SafeGuard-EWHA/2026ESWContest_mobility_DugoNaerijiMarajo/README.md

# SafeGuard: UWB와 mmWave를 융합한 Cascading Wake-up 기반 차량 내 잔류 탑승자 선제 보호 시스템

**제24회 임베디드SW경진대회 자동차/모빌리티 부문 결선 제출 저장소** · 팀 두고내리지말아조 (윤현서, 최서현, 윤홍은, 이화여자대학교)

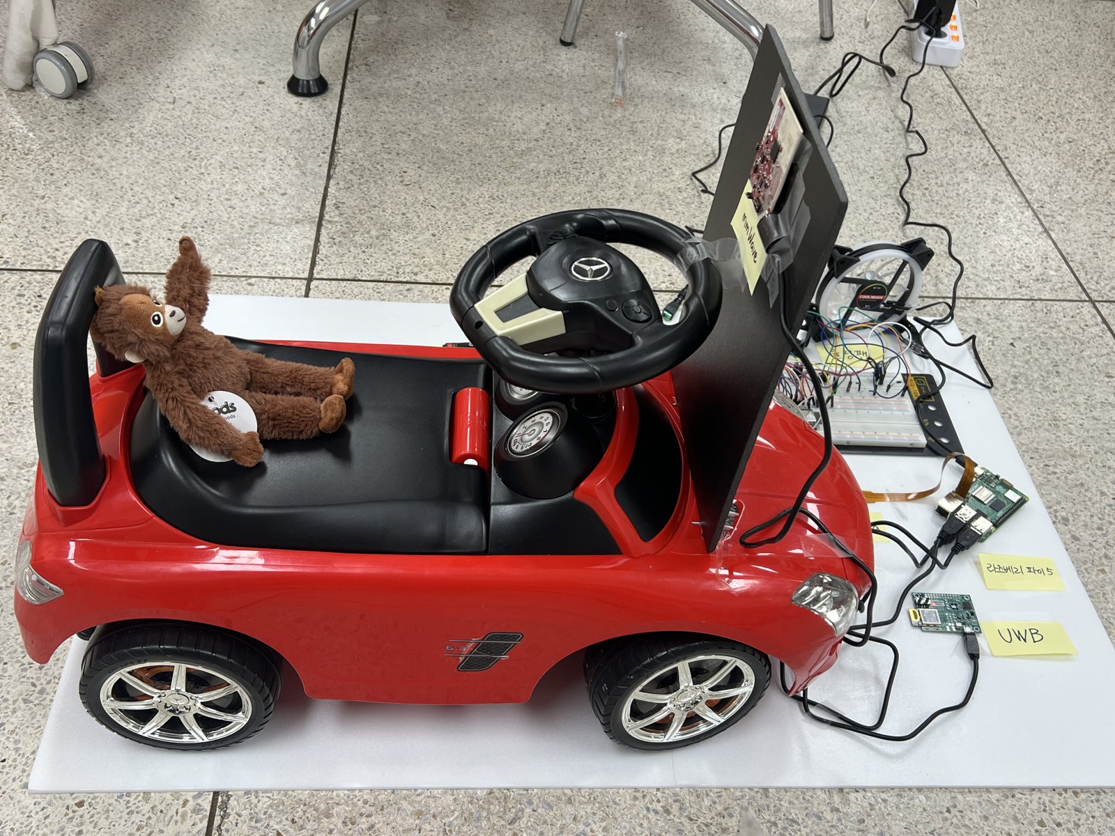
[picture p1: docs/presentation/img/benz/car_side_teddy.jpg]
SafeGuard 시연 시제품


| 제출 자료 | 위치 |
|---|---|
| 개발완료보고서 (PDF, 본문 20쪽) | [`2026ESWContest_모빌리티_두고내리지말아조_개발완료보고서.pdf`](docs/presentation/2026ESWContest_모빌리티_두고내리지말아조_개발완료보고서.pdf) |
| 작품소개서 (Word, 2쪽) | [`2026ESWContest_모빌리티_두고내리지말아조_작품소개서.docx`](docs/presentation/2026ESWContest_모빌리티_두고내리지말아조_작품소개서.docx) |
| 시연 동영상 (YouTube) | [https://www.youtube.com/watch?v=aBB1S666mp4&feature=youtu.be](https://www.youtube.com/watch?v=aBB1S666mp4&feature=youtu.be) |
| 레이더 영상 5종, 주요 그래프, 실측 그래프 | 아래 본문 (페이지를 열면 바로 재생) |

| 폴더 | 내용 |
|---|---|
| [`prototype/`](prototype/) | **장치 제어 소스**: C++ 상태기계와 열 관측기(`SafeGuard_Main/src`), Python 센서 허브와 대시보드(`scripts`), ESP32 펌웨어, 측정 원본 |
| [`hardware/`](hardware/) | 블록 B 레이더 수신기(`mmwave/mmwave_reader.py`), 카메라 움직임 검출, ESP32 시험 스케치, 배선 가이드 |
| [`src/`](src/), [`app/`](app/), [`tests/`](tests/) | TwinLab 시뮬레이터 (상태기계, 가상 센서, 전력 모델, Streamlit 대시보드, pytest) |
| [`docs/figures/paper/`](docs/figures/paper/) | 주요 그래프와 생성 스크립트 (실측 원본에서 재현) |
| [`docs/figures/power/`](docs/figures/power/) | 결선 장비 소비전력 추정 그래프와 계산 스크립트 |
| [`docs/presentation/`](docs/presentation/) | 보고서, 소개서, 영상, 그림 생성 스크립트 |
| `B회신*_20261027/` | 레이더, 카메라 시험 원본 (CSV, 원본 바이트, 사진, 분석) |
| [`pic_red_benz/`](pic_red_benz/), [`pics/`](pics/) | 시연 시제품과 부품 사진 |

---






## 요약

보호자가 차를 떠난 뒤 차 안에 남은 아이를 찾아, 실내 온도가 위험해지기 **전에** 팬과 부저를 켜는 장치다.
보호자의 UWB 거리(5 m 초과 10초)로 이탈을 확인한 뒤에만 PIR, 카메라 → 60 GHz 레이더 → 온도 예측 순서로
필요한 센서를 깨운다(Cascading Wake-up).

| 서론 | 본론 | 결론 |
|---|---|---|
| 차량 내 아동 방치 사고는 온도가 오른 뒤 알리면 늦다. 단일 센서와 상시 구동 방식의 한계를 넘는 저전력 선제 보호가 목표 | 유아용 전동차 시제품, 시스템 구조와 상태기계, 레이더, 카메라, UWB 실측, 소비전력 추정 | [결론과 시사점](#3-결론과-시사점): 무엇을 확인했고 실제 차량에 무엇을 줄 수 있는지 |

시연 영상 (2026.10.28 실차 시연): https://www.youtube.com/watch?v=aBB1S666mp4&feature=youtu.be

라이브 데모 (TwinLab 시뮬레이터, 예선 제출본): https://safeguard-mmwave-simulator.streamlit.app/

## 상황별 실제 대시보드

**[상황별 캡처 7장과 간단한 설명 보기](docs/dashboard-scenarios/README.md)**

정지 확인 → 근거리 감시 → 보호자 이탈·탑승 의심 → 열 예측 → 보호·종료 순서로 정리했습니다. 연결 장애 화면도 별도로 모았습니다.
서로 다른 개발·시연 시점의 실제 캡처이며, 선제 보호 작동 장면은 갤러리의 시연영상 링크로 연결합니다.

| 근거리 감시 대기 | 이탈 후 온도 판단 | 열 예측 결과 예시 |
|---|---|---|
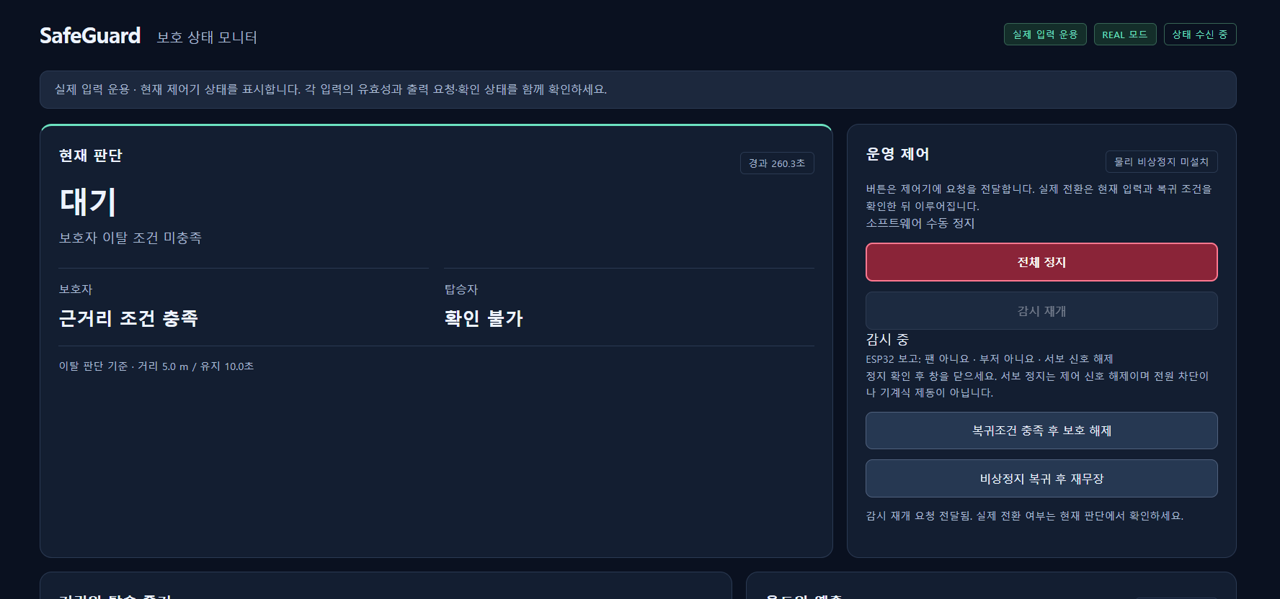
[picture p2: docs/dashboard-scenarios/images/02-standby.png]
근거리 감시 대기
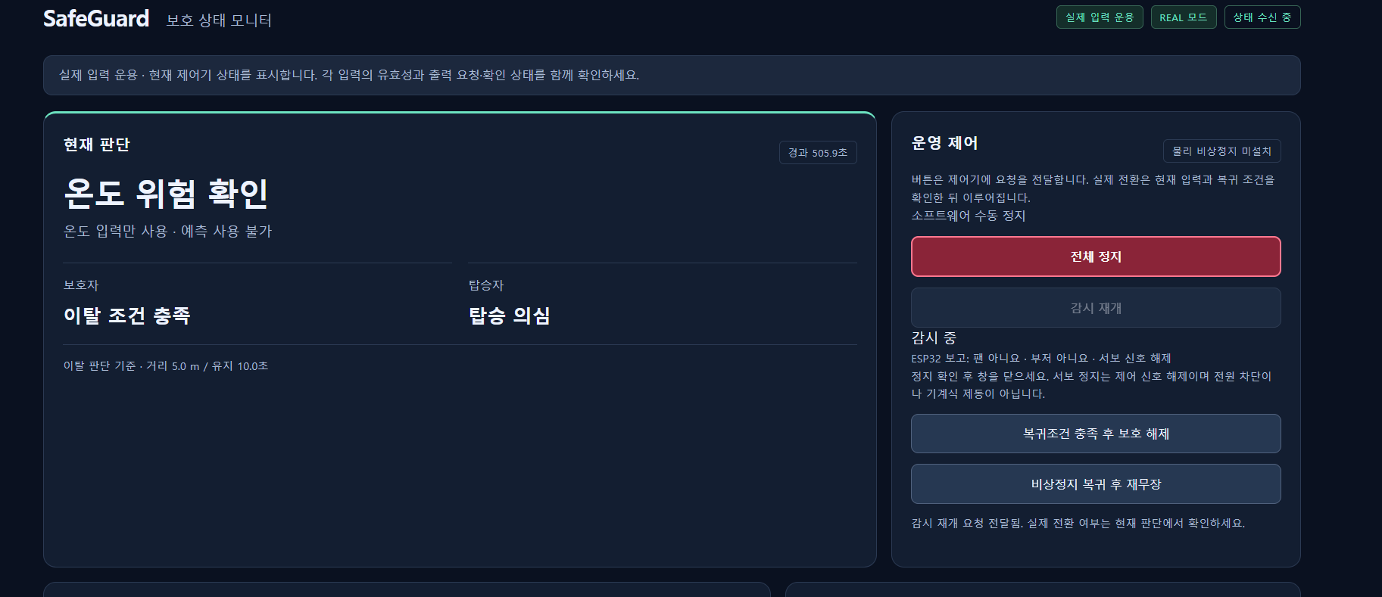
[picture p3: docs/dashboard-scenarios/images/03-away-thermal.png]
이탈 후 온도 판단
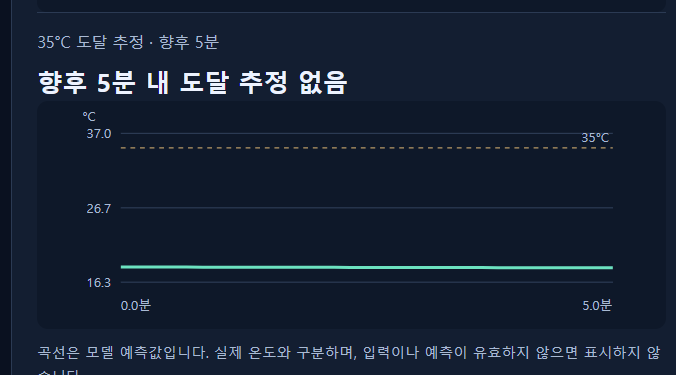
[picture p4: docs/dashboard-scenarios/images/04-no-crossing-forecast.png]
도달 추정 없음
|  |  |  |

# 1. 서론: 배경과 목표

- **배경**: 직사광선 아래 차량 실내 온도는 외기보다 크게 오르고, 아이는 체온 조절이 약해 짧은 시간에도 위험하다.
  Euro NCAP은 2026년부터 어린이 잔류 감지(CPD)를 평가 항목으로 다루고, 국내도 통학차량 하차 확인 장치를 의무화했다.
- **기존 방식의 한계**: PIR은 가만히 있는 아이를, 카메라는 어둠과 가림을 놓친다. 모든 센서를 상시 켜 두면 주차 중 배터리 부담이 크다.
  "현재 온도가 기준을 넘으면 알림"은 이미 위험 구간에 들어선 뒤다.
- **목표**: (1) 놓치지 않는다: 평소에는 PIR 또는 카메라 하나만 반응해도 레이더로 확인한다. (2) 필요할 때만 켠다.
  (3) 뜨거워지기 전에 움직인다: 35 °C 도달까지 남은 시간으로 판단한다.

# 2. 본론

## 2.1 시연 시제품: 유아용 전동차 위 SafeGuard (2026.10.28)

빨간 유아용 전동차를 차량 실내 모형으로 쓰고, 뒷좌석 자리에 인형(잔류 탑승자 역할)을 앉혔다.
60 GHz 레이더(mmWave)는 운전대 앞 판에 붙여 좌석을 향하게 했고, 나머지 부품은 이름표를 붙여 옆에 배치했다.

전동차 옆모습과 인형, 운전대 앞 레이더

| 위에서 본 전체 배치 | 정면: 운전대 앞 레이더 |
|---|---|
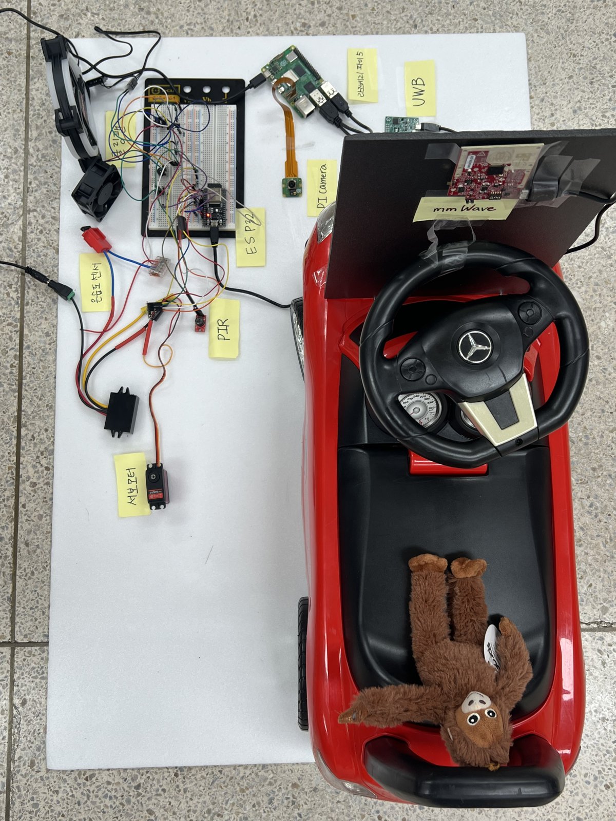
[picture p5: docs/presentation/img/benz/car_top_full.jpg]
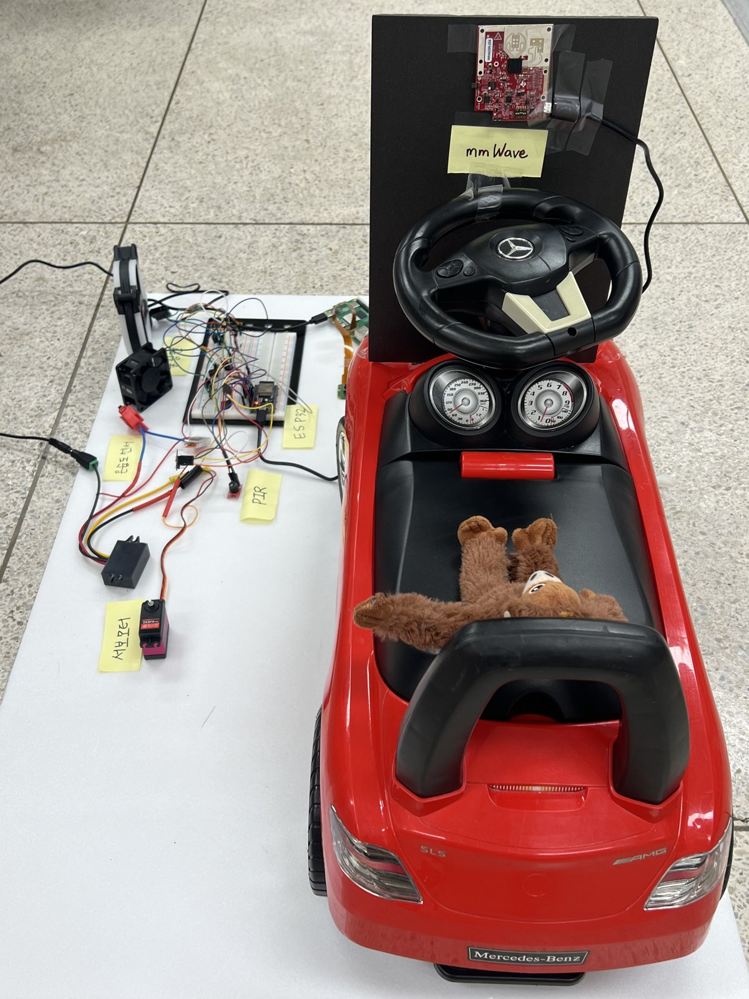
[picture p6: docs/presentation/img/benz/car_front_radar.jpg]
|  |  |

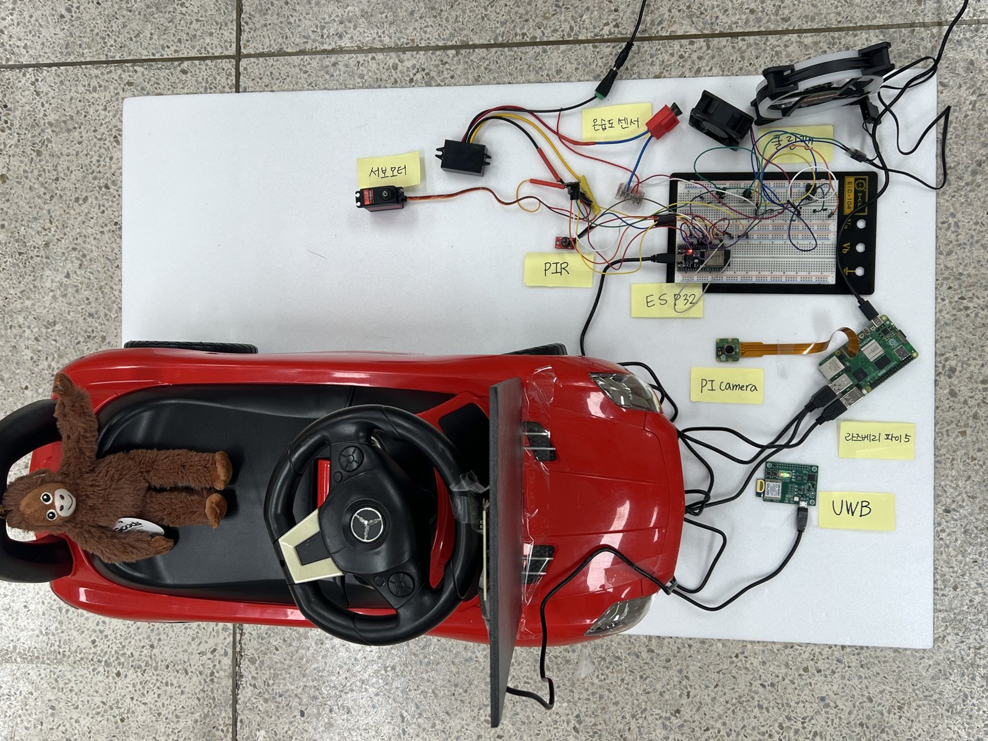
[picture p7: docs/presentation/img/benz/car_side_top.jpg]
옆에서 본 전체 배치와 이름표


| 레이더 (IWR6843ISK-ODS) | 운전대 앞 판에 장착 |
|---|---|
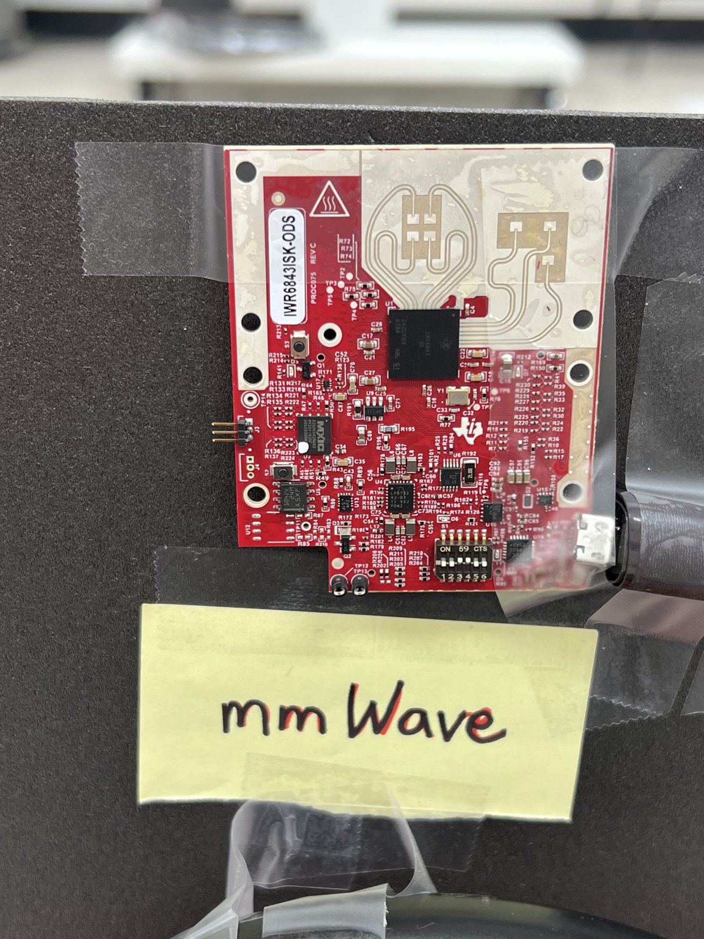
[picture p8: docs/presentation/img/benz/radar_close.jpg]
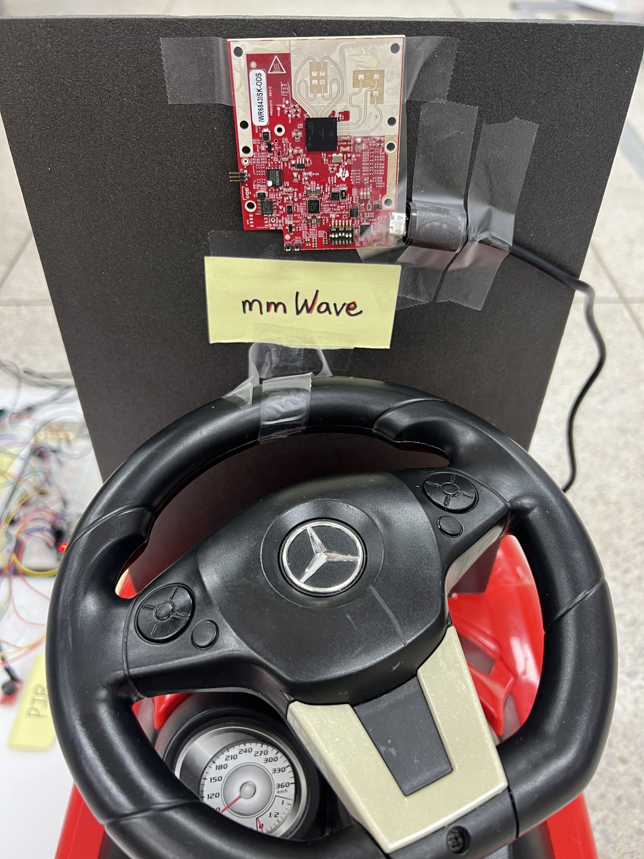
[picture p9: docs/presentation/img/benz/radar_on_dashboard.jpg]
|  |  |

| UWB, Pi Camera, Raspberry Pi 5 | ESP32, PIR, 온습도센서, 팬, 부저 | 서보, PIR, 12V 배선 |
|---|---|---|
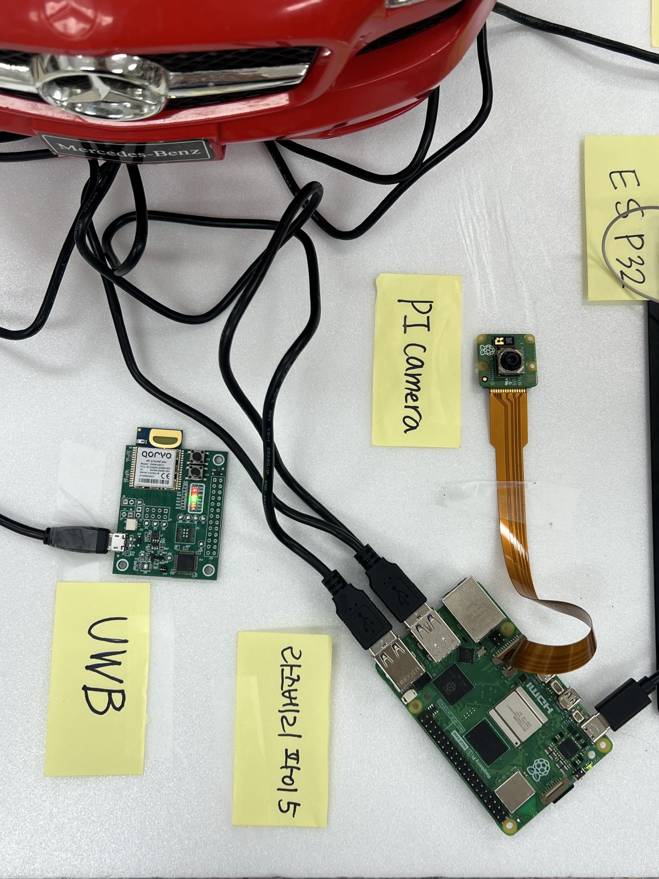
[picture p10: docs/presentation/img/benz/uwb_pi_camera.jpg]
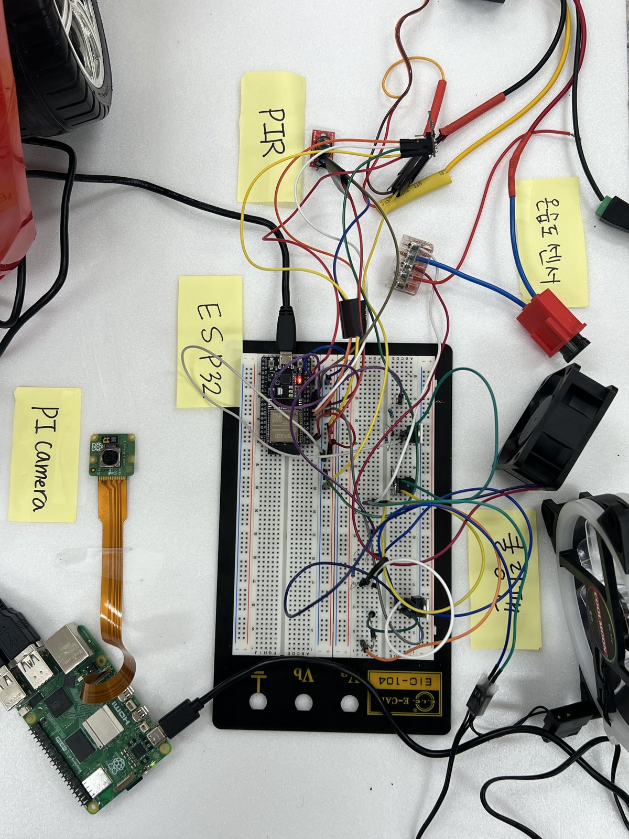
[picture p11: docs/presentation/img/benz/esp32_pir_sht31.jpg]
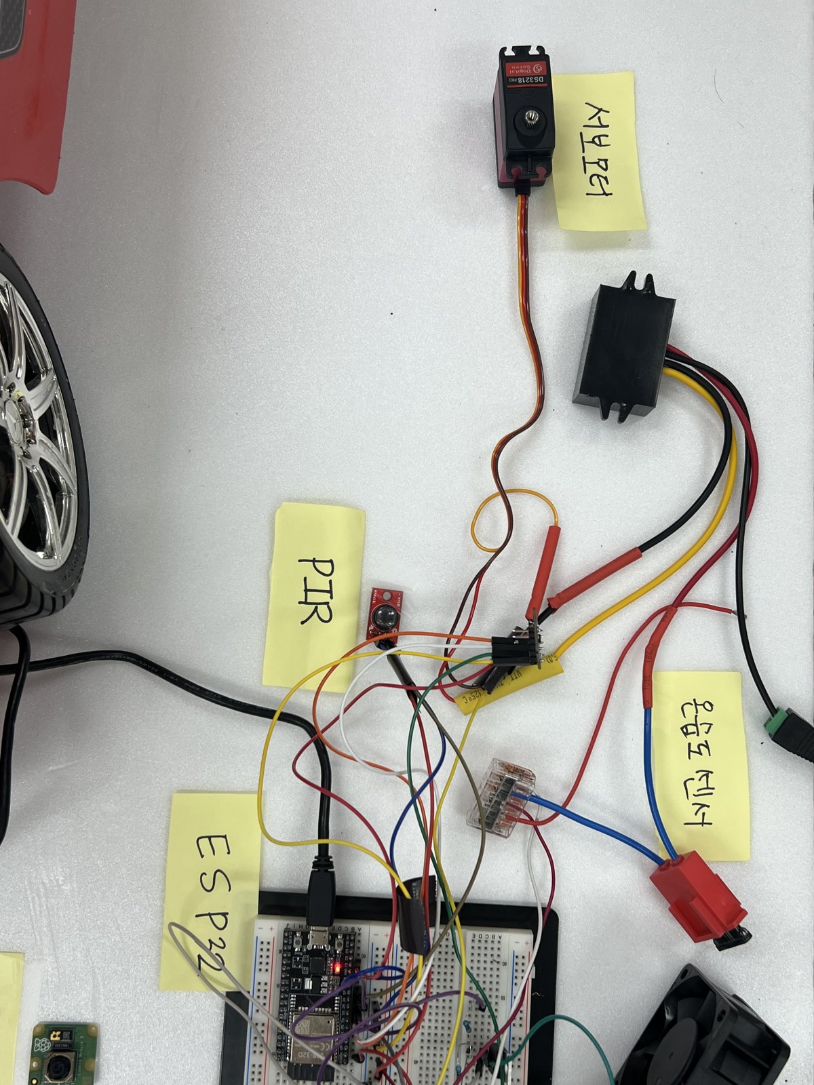
[picture p12: docs/presentation/img/benz/servo_pir.jpg]
|  |  |  |

사진 23장 (긴 변 2000 px로 줄이고 위치 정보 제거): [`pic_red_benz/`](pic_red_benz/)

### 실제 차량 설치와 시연 (2026.10.28)

전동차에서 만든 센서와 제어부를 실제 승용차 운전석 옆 센터 콘솔에 옮겨 달았다. Pi 5, 카메라, UWB 차량측, 레이더, ESP32 출력부를
판 하나에 고정하고 12V 팬, 부저를 연결했다.

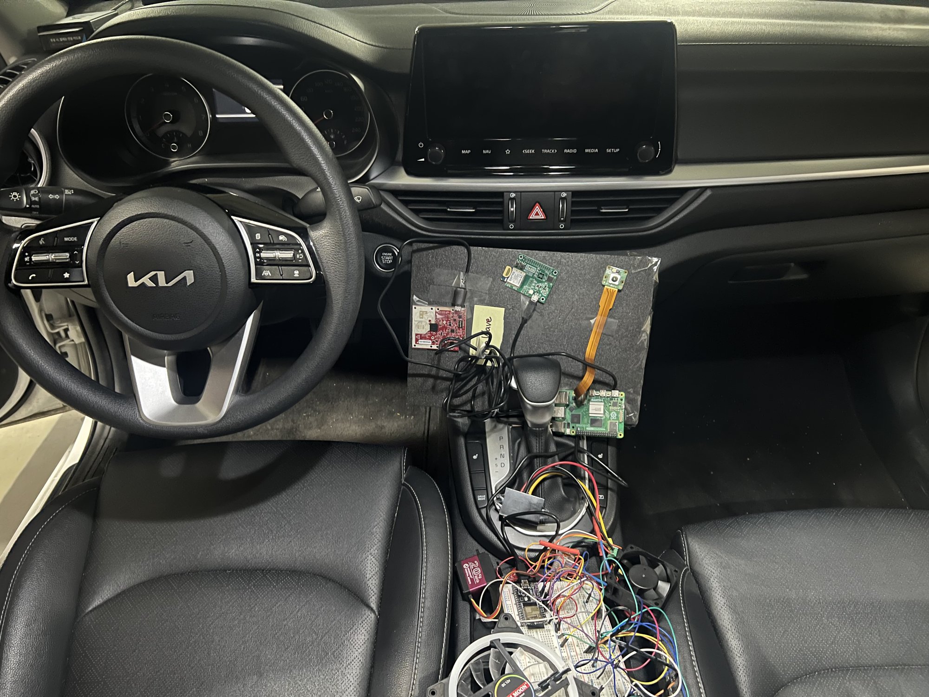
[picture p13: docs/presentation/img/realcar/realcar_install_front.jpg]
실제 차량 센터 콘솔에 설치한 SafeGuard


| 센터 콘솔 장착 | 장치 근접 (Pi 5, 카메라, UWB, 배선) |
|---|---|
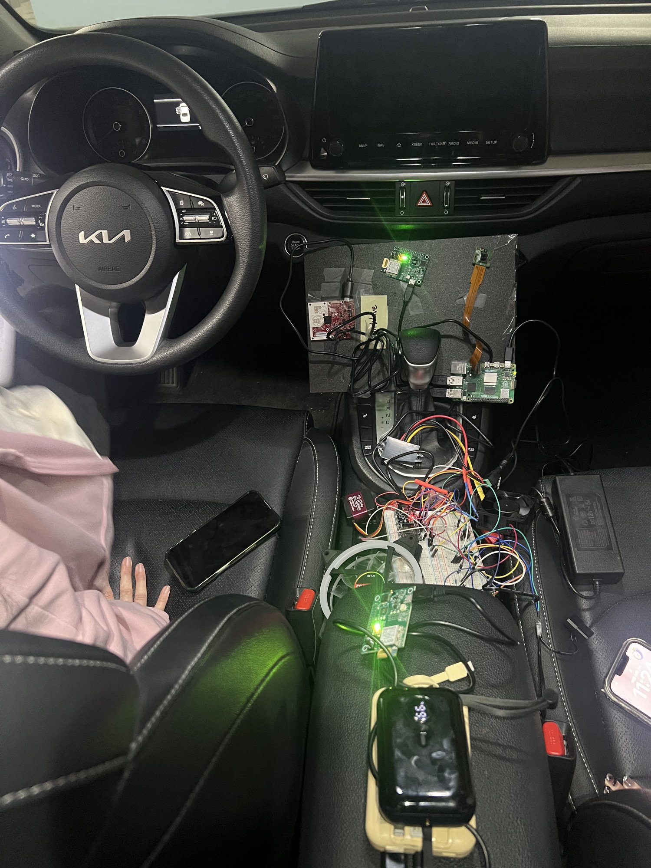
[picture p14: docs/presentation/img/realcar/realcar_console_mount.jpg]
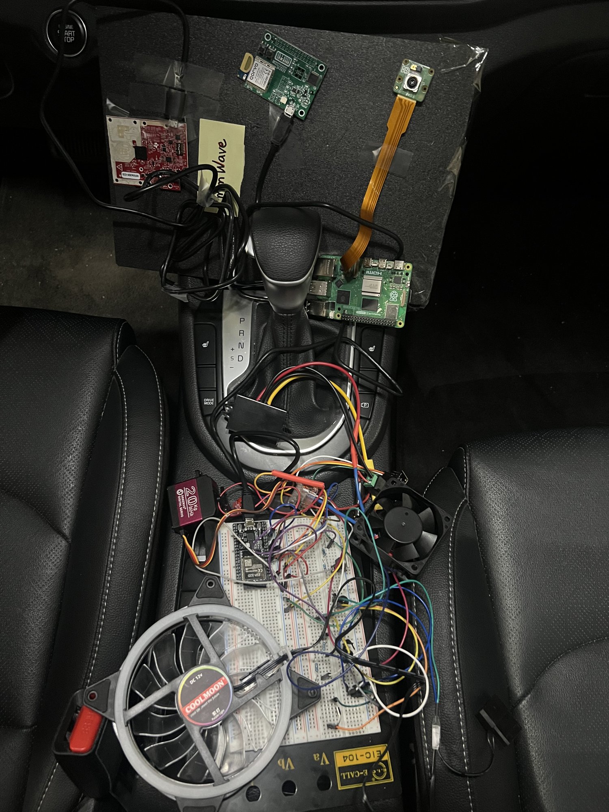
[picture p15: docs/presentation/img/realcar/realcar_device_closeup.jpg]
|  |  |

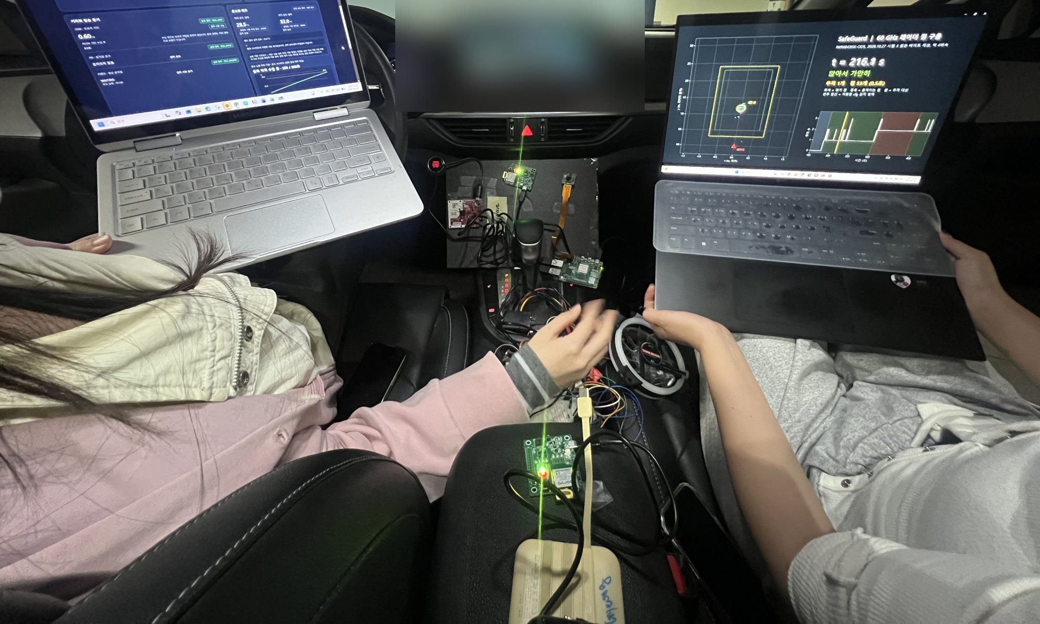
[picture p16: docs/presentation/img/realcar/realcar_demo_dashboards.jpg]
실차 시연 중 대시보드


시연 중 모습. 왼쪽 노트북은 SafeGuard 보호자 대시보드(UWB 거리, 실내 온도, 상태)다.
사진은 긴 변 2000 px로 줄이고 위치 정보를 지웠으며, 차량 내비게이션 화면은 가렸다.

## 2.2 실측 결과

제24회 임베디드SW경진대회 자동차/모빌리티 부문 결선 시제품(두고내리지말아조)의 실측 결과다.
아래 영상과 그래프는 모두 시험 원본 CSV와 레이더 원본 바이트에서 다시 그린 것이다
(생성 스크립트: [`docs/presentation/`](docs/presentation/)). 움직이는 그림은 GIF라서 페이지를 열면 바로 재생되고,
고화질 MP4는 각 그림 아래 링크로 받을 수 있다.

### 주요 그래프 6장 (실측 원본 기반)

생성: [`docs/figures/paper/build_paper_figures.py`](docs/figures/paper/build_paper_figures.py) · 각 그림은 PNG(300 dpi)와 PDF(벡터)로 저장.
모두 한 사람, 한 번의 시험이라 프레임끼리 독립이 아니며, 일반화된 정확도로 쓰지 않는다.

**Fig. 1 UWB 거리 측정 특성.** 정지 구간 잡음 σ 3.5 cm / 6.7 cm, 이동평균 창이 커질수록 잡음은 줄고 지연은 늘어남 (N = 7은 약 1.6 s 지연). 정답 거리가 없어 정밀도만 보고 정확도는 주장하지 않음.

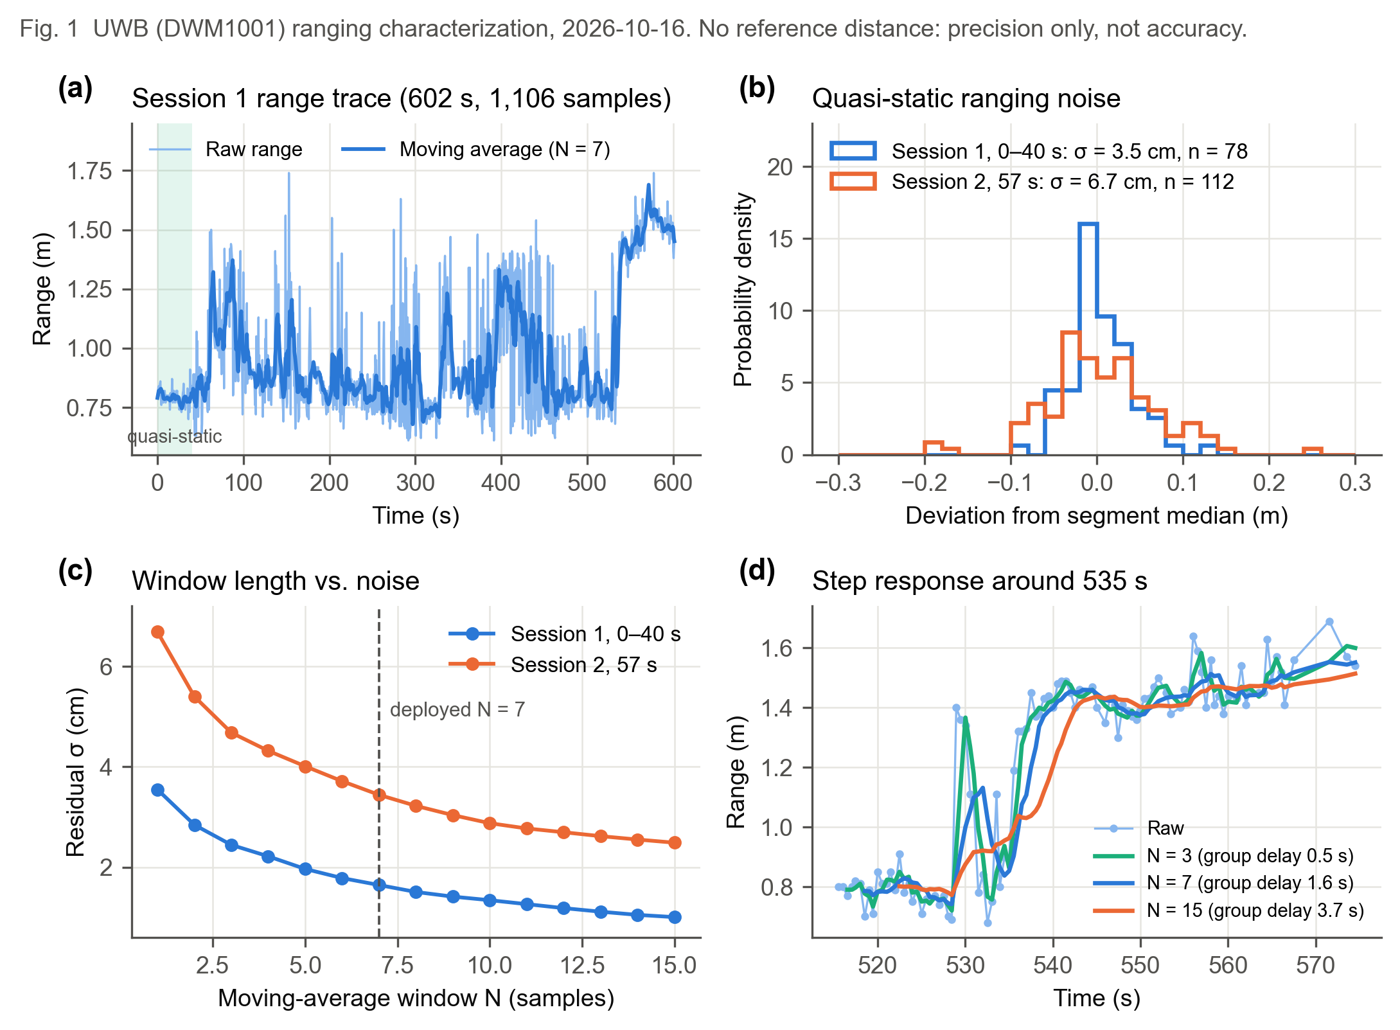
[picture p17: docs/figures/paper/fig1_uwb_ranging.png]
Fig 1 UWB


**Fig. 2 레이더 재실 판정.** 시험 3에서 빈자리 0%, 착석 100%였지만 퇴장 뒤 빈자리도 100% (유령 추적). 정지 착석 시험에서 차량용 cfg만 정확히 1명 95.7%.

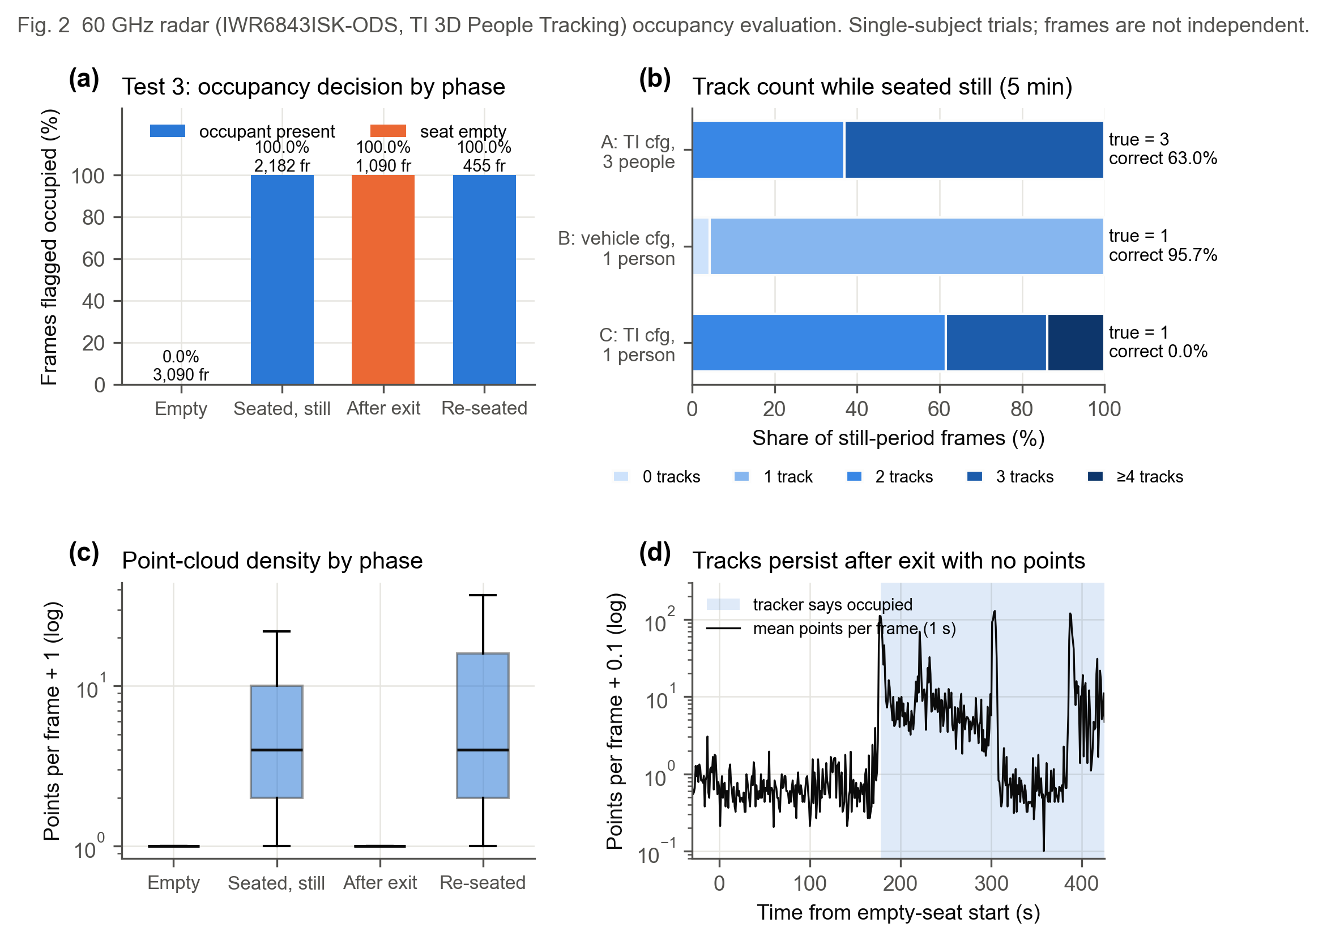
[picture p18: docs/figures/paper/fig2_radar_occupancy.png]
Fig 2 radar


**Fig. 3 카메라 움직임 특징.** 사람이 움직일 때만 1% 기준을 넘고, 가만히 앉은 사람과 조명 변화는 대부분 판정되지 않음 (조명 0%).

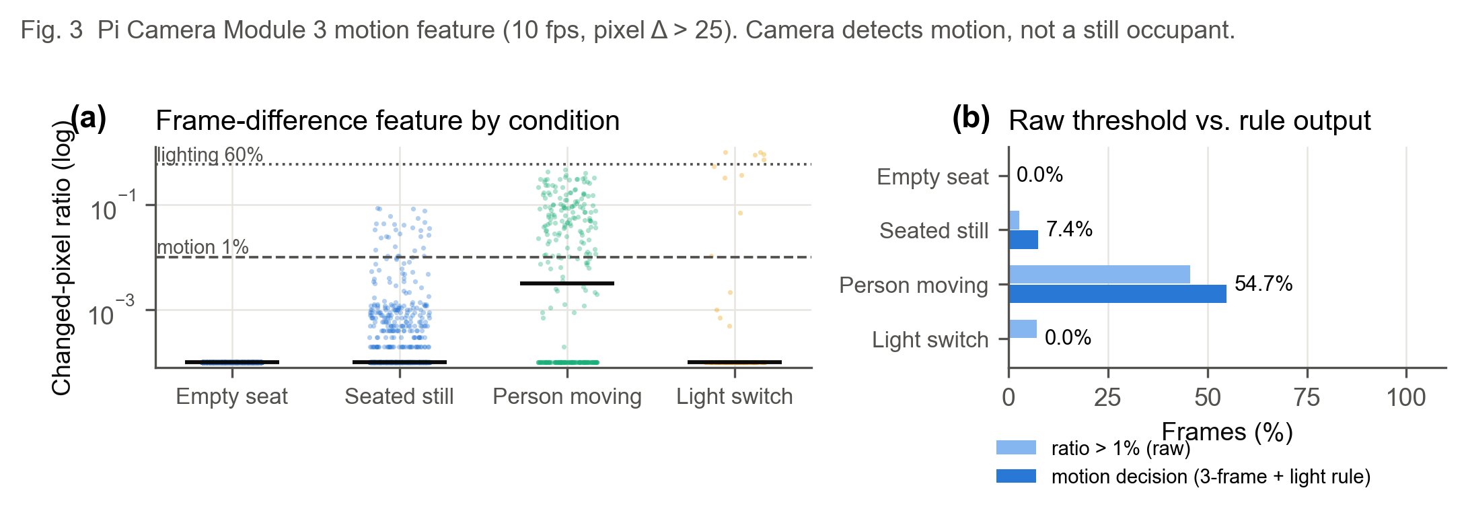
[picture p19: docs/figures/paper/fig3_camera_feature.png]
Fig 3 camera


**Fig. 4 센서 상호보완.** 카메라만으로는 정지 착석을 12%만 잡고, 레이더는 100%지만 퇴장 뒤에도 100%. 사후 분석으로 "추적 주변 0.45 m 안에 0.5 s 동안 점 3개 이상" 조건을 더하면 퇴장 뒤 0%, 착석 100% (메인 코드 미반영, 해결 후보).

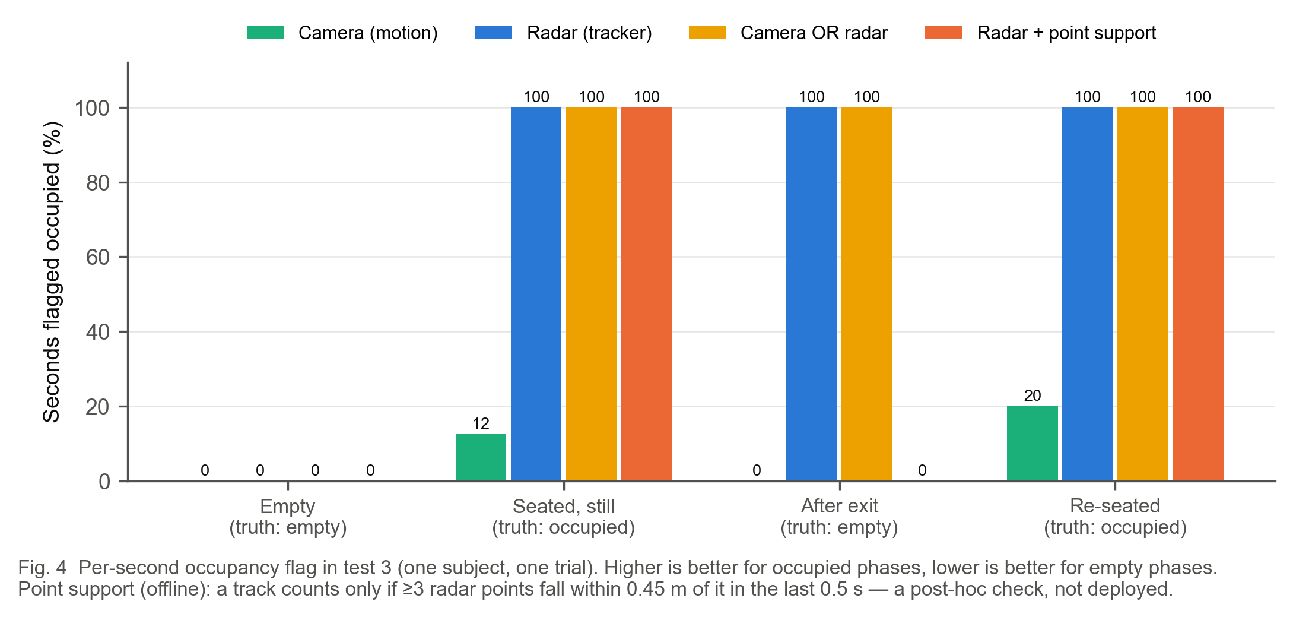
[picture p20: docs/figures/paper/fig4_multimodal.png]
Fig 4 multimodal


**Fig. 5 센서별 수신 주기.** 레이더 55 ms (누락 0), 카메라 100 ms, UWB 531 ms. UWB 99%가 1.1 s 안에 도착해 2 s 만료 기준 안쪽.

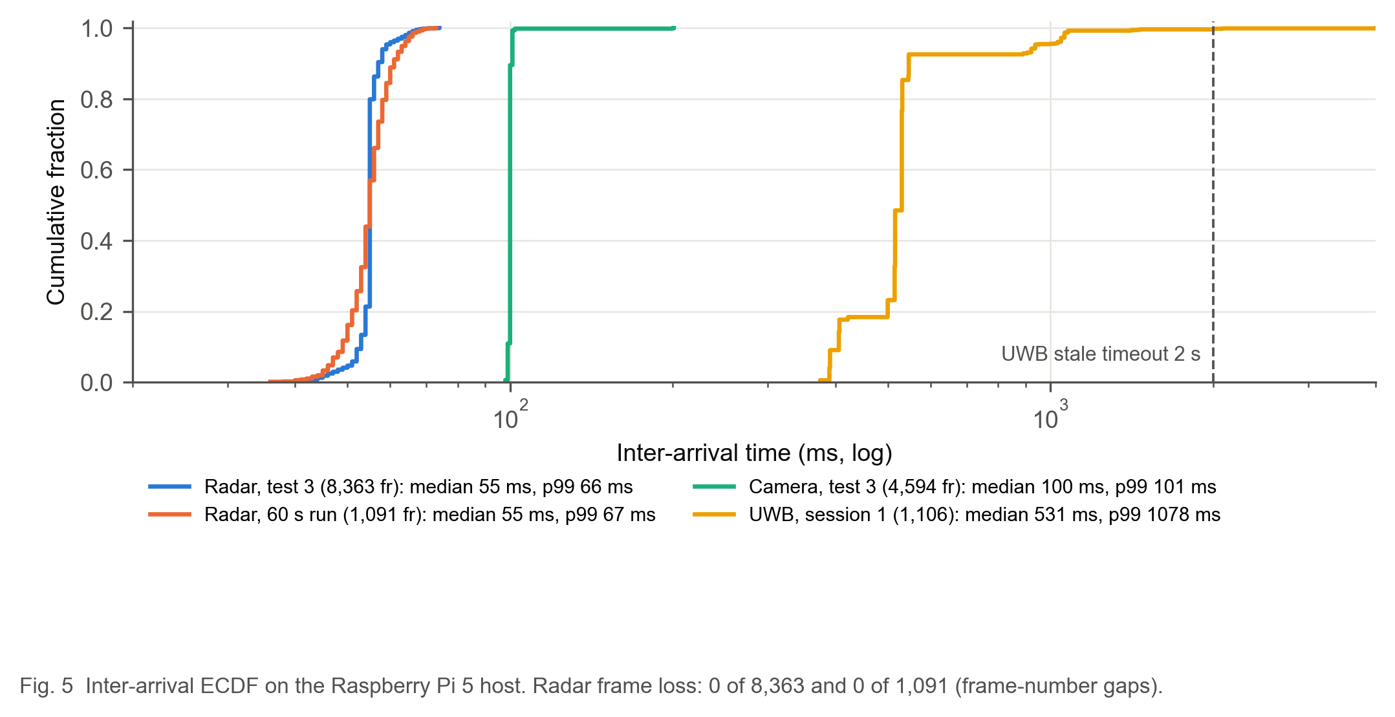
[picture p21: docs/figures/paper/fig5_sensor_timing.png]
Fig 5 timing


**Fig. 6 온도 판단 규칙 지도 (측정 아님).** `src/config.py` 규칙: 32 °C 이상 또는 35 °C 도달 예상 300 s 이하이면 PROTECT.

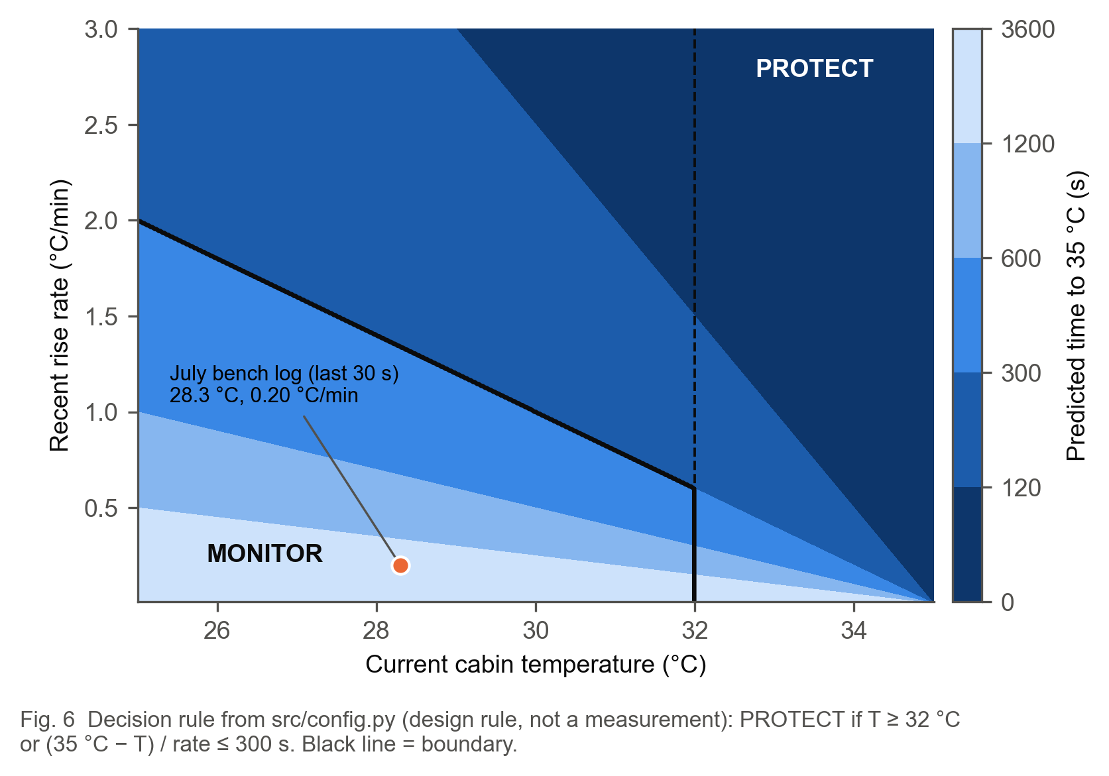
[picture p22: docs/figures/paper/fig6_thermal_rule_map.png]
Fig 6 thermal rule


PIR, SHT31, ESP32는 시간 기록이 있는 실측 로그가 아직 짧아(블록 A 시리얼 10줄) 통계 그림에서 뺐다.

### 레이더 점 구름 (위에서 본 모습, 시험 3, 약 4배속)

앉기 → 가만히 → 일어나 나감 → 다시 앉기. 사람이 나간 뒤에도 추적 2개가 남는 문제가 보인다.

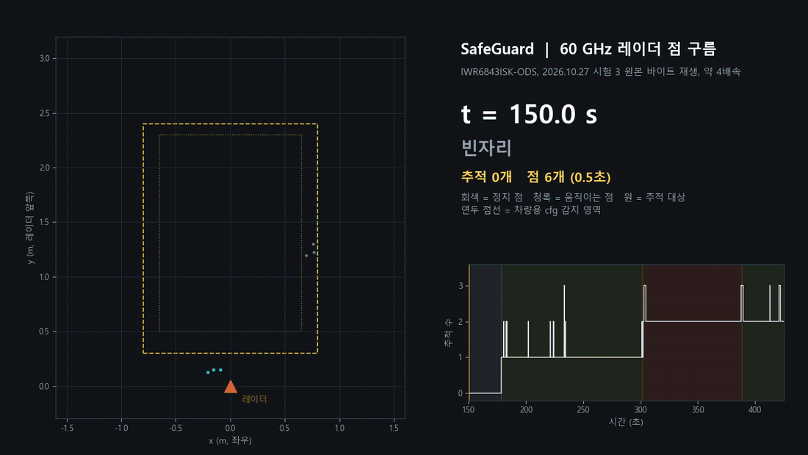
[picture p23: docs/presentation/img/readme/pointcloud_topview.gif]
레이더 점 구름 재생


MP4 (1분 2초): [`SafeGuard_mmwave_pointcloud_test3.mp4`](docs/presentation/SafeGuard_mmwave_pointcloud_test3.mp4)

### 사람 추적과 점 연결 (TI People Tracking 데모 형식)

위: 점 구름과 최근 6초 추적 경로. 아래: 추적 0.45 m 안의 점을 같은 색으로 표시.
사람이 나간 뒤에는 원 안에 점이 하나도 없는데 추적 2개가 남는다.

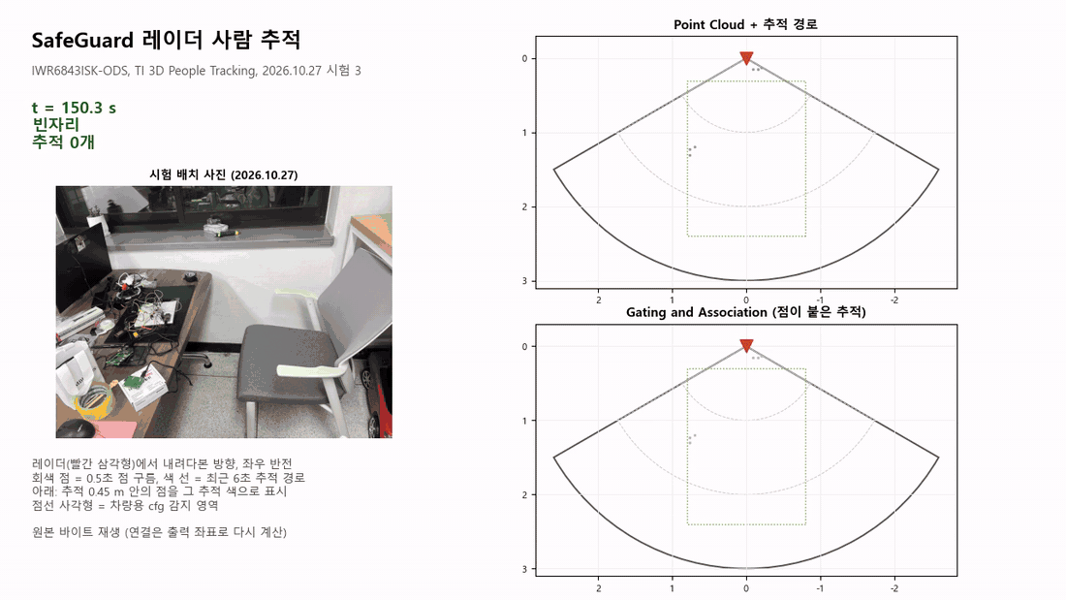
[picture p24: docs/presentation/img/readme/tracking_test3.gif]
사람 추적과 점 연결 영상


MP4 (1분 2초): [`SafeGuard_radar_tracking_test3.mp4`](docs/presentation/SafeGuard_radar_tracking_test3.mp4)

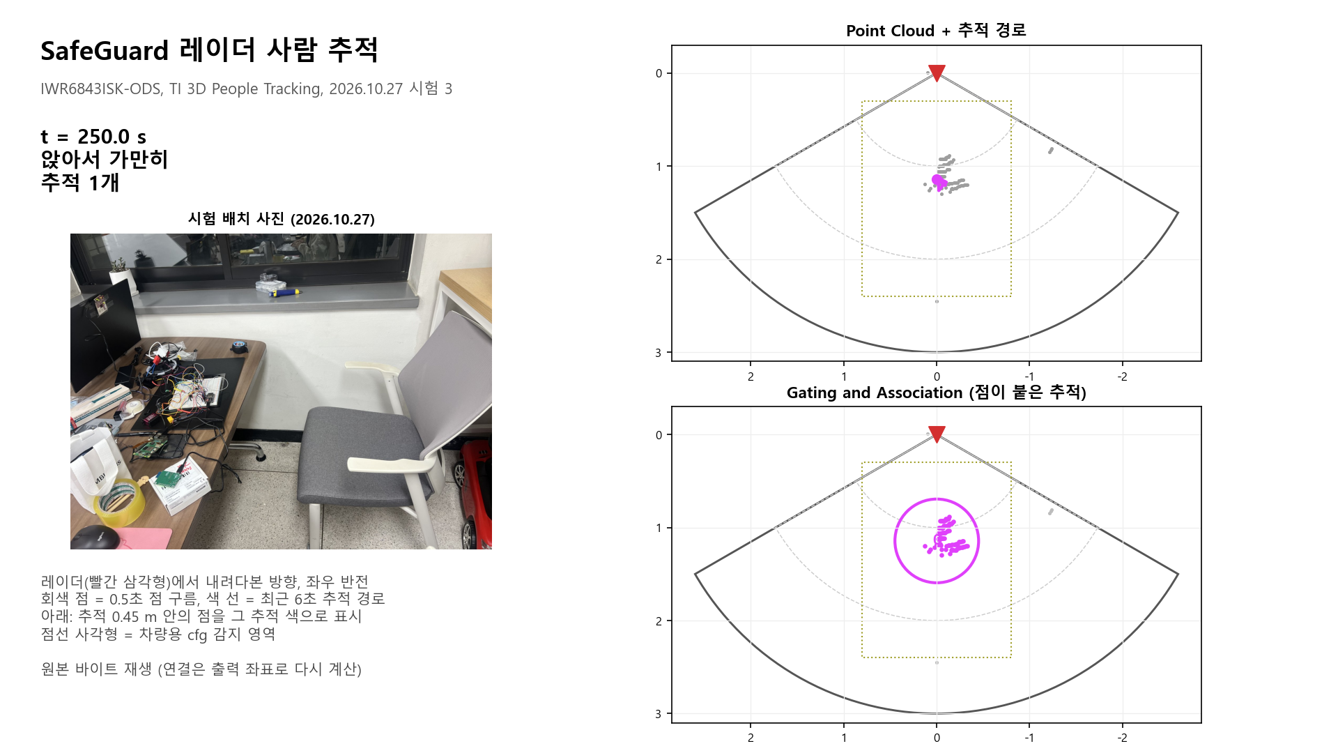
[picture p25: docs/presentation/img/final/fig_tracking_assoc.png]
사람 추적과 점 연결 정지 화면


### 3D 군집 (DBSCAN)과 TI 트래커 추적

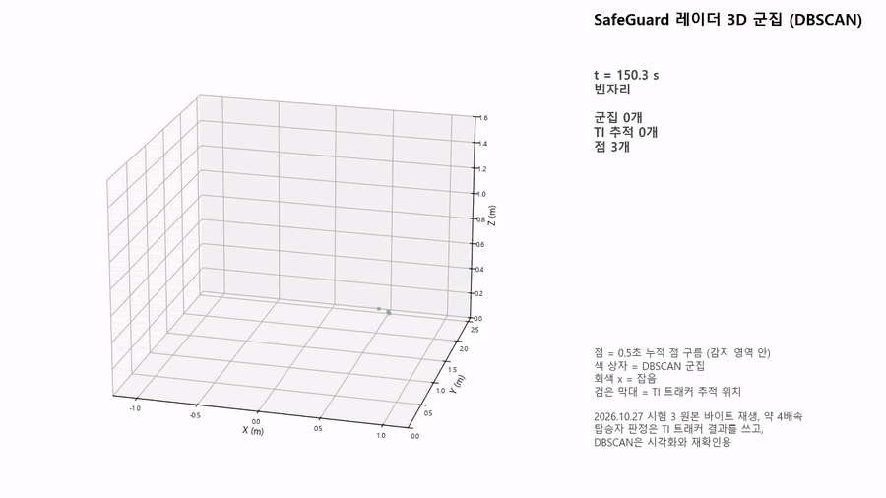
[picture p26: docs/presentation/img/readme/cluster3d_test3.gif]
3D 군집 영상


MP4: [`SafeGuard_radar_cluster3d_test3.mp4`](docs/presentation/SafeGuard_radar_cluster3d_test3.mp4)

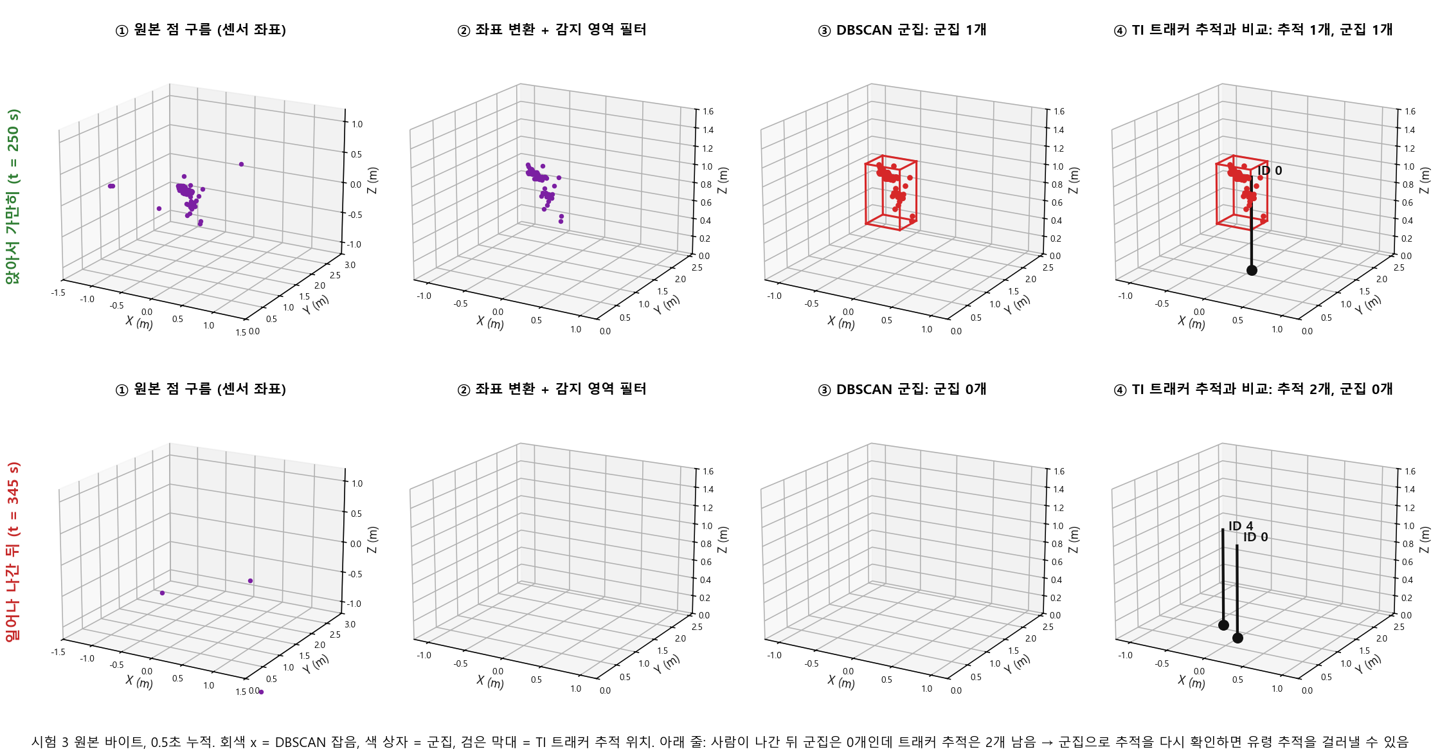
[picture p27: docs/presentation/img/final/fig_cluster_pipeline.png]
점 구름 처리 과정


윗줄은 앉아 있을 때 군집 1개와 추적 1개가 일치한다. 아랫줄은 사람이 나간 뒤 군집은 0개인데 TI 트래커 추적은 2개 남는다.
군집으로 추적을 다시 확인하면 유령 추적을 걸러낼 수 있다 (해결 후보, 메인 코드 미반영).

### TI 데모 형식 대시보드 (X-Y, Doppler-Range, 좌석 영역 점 개수, 필터, 스펙트럼)

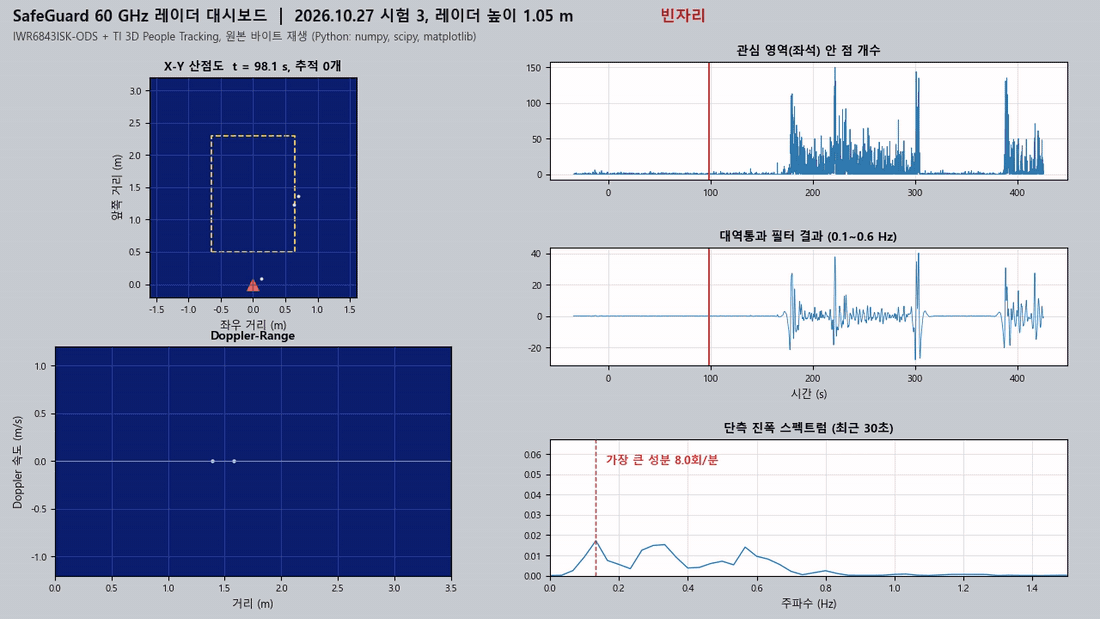
[picture p28: docs/presentation/img/readme/dashboard_test3.gif]
시험 3 대시보드 영상


MP4: [`SafeGuard_radar_dashboard_test3.mp4`](docs/presentation/SafeGuard_radar_dashboard_test3.mp4)

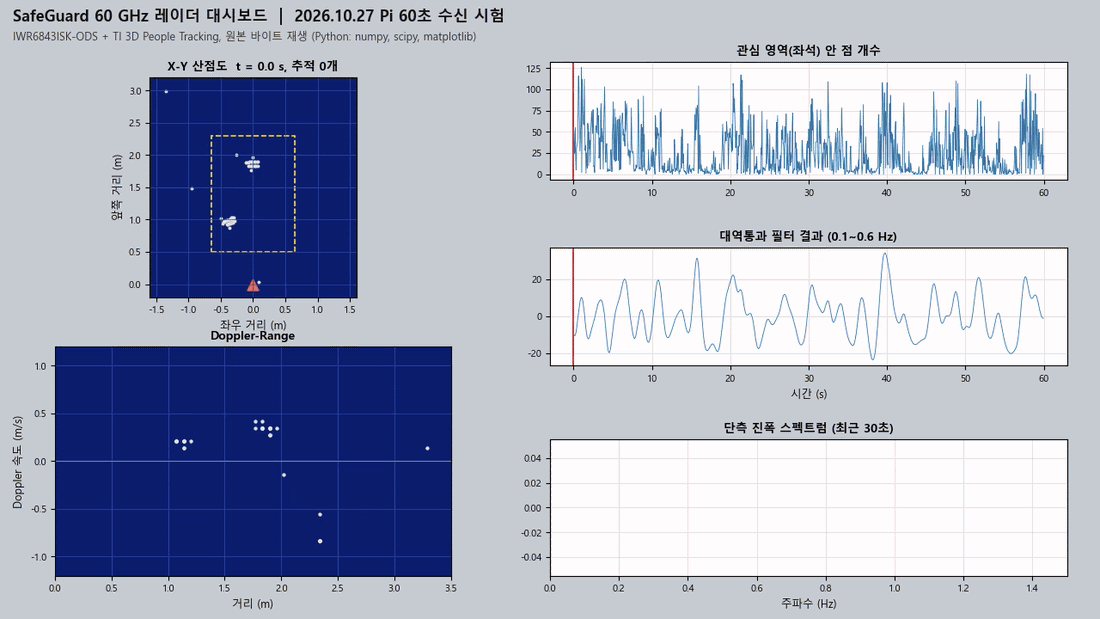
[picture p29: docs/presentation/img/readme/dashboard_rx60.gif]
60초 수신 시험 대시보드 영상


MP4 (55초): [`SafeGuard_radar_dashboard_rx60.mp4`](docs/presentation/SafeGuard_radar_dashboard_rx60.mp4).
스펙트럼의 가장 큰 성분은 표시만 하며, 호흡 정답이 없어 호흡수로 주장하지 않는다.

| 시험 3 대시보드 (정지 화면) | 60초 수신 대시보드 (정지 화면) |
|---|---|
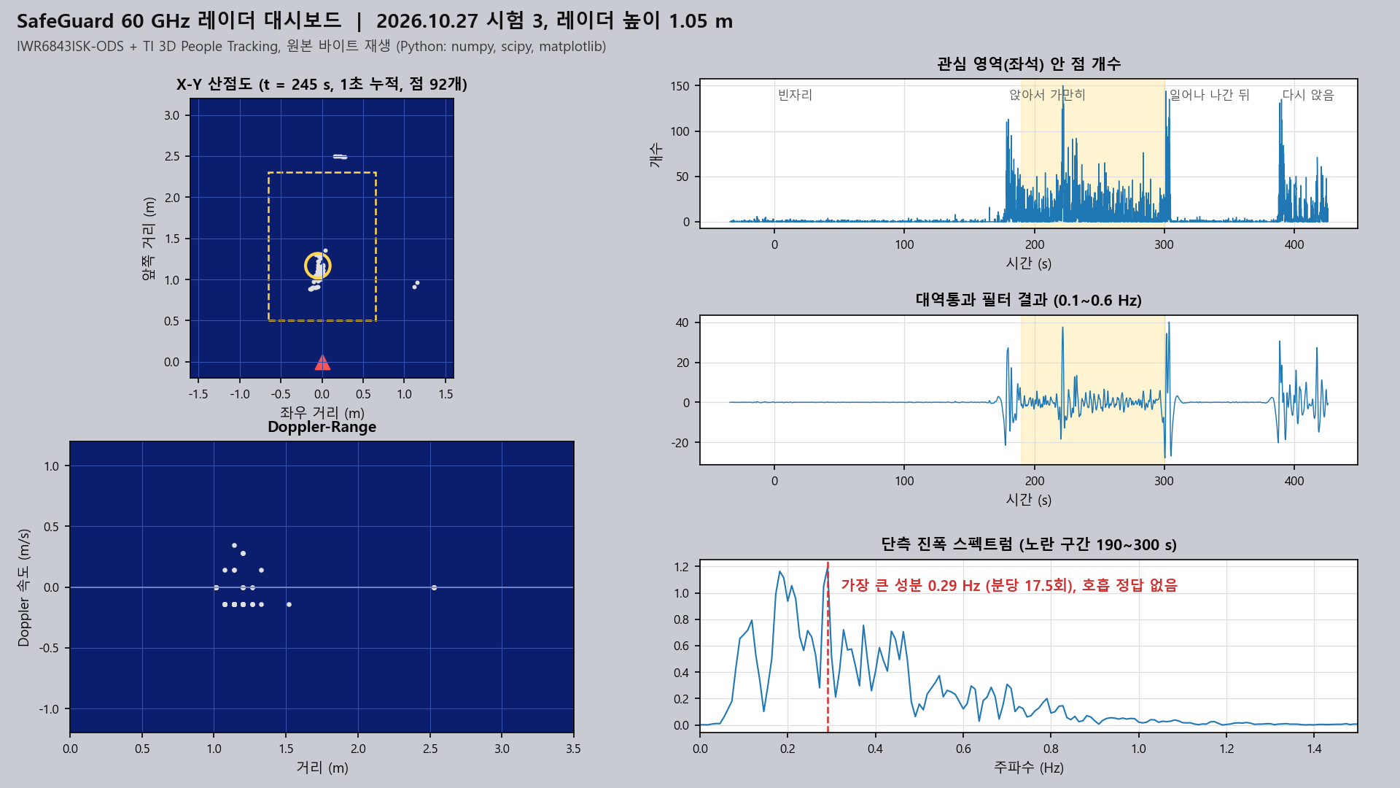
[picture p30: docs/presentation/img/final/dash_test3.png]
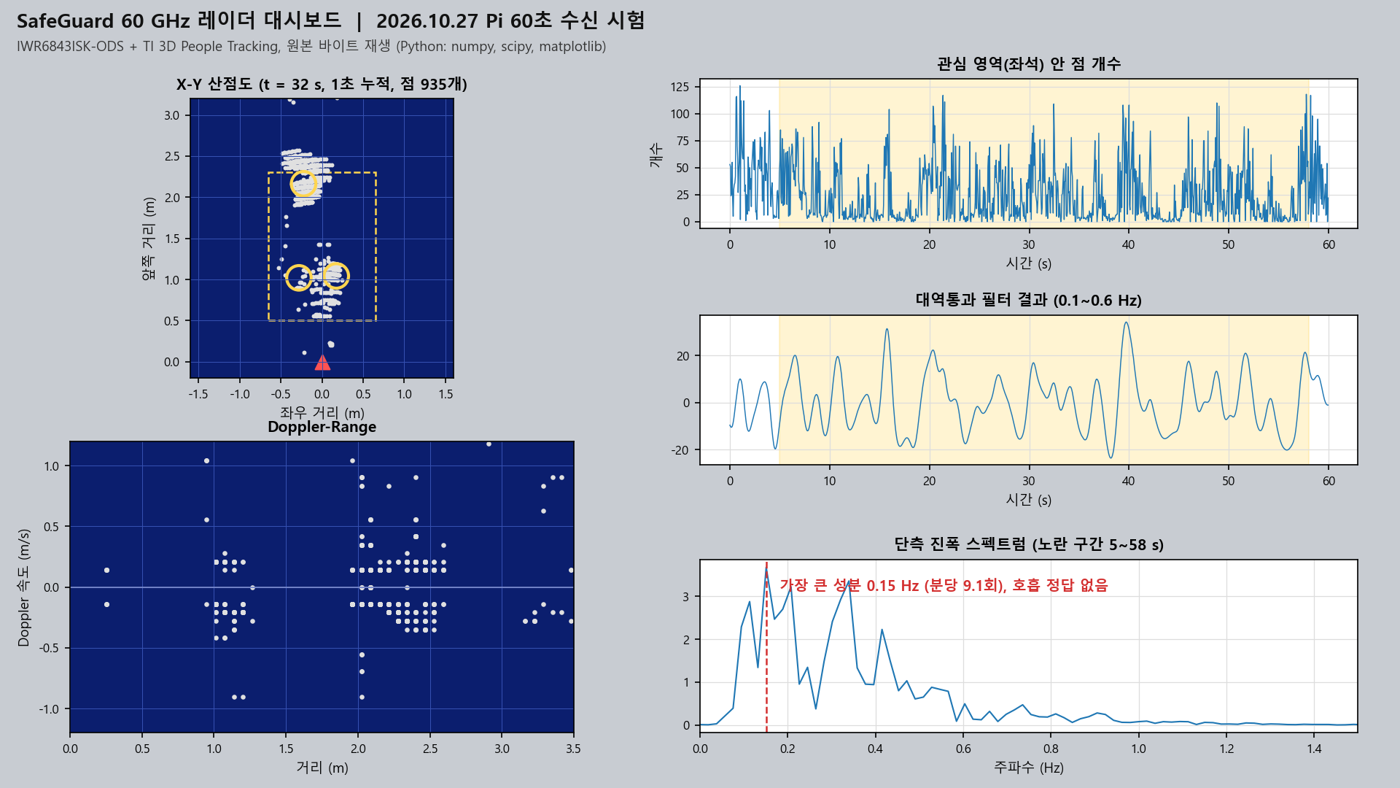
[picture p31: docs/presentation/img/final/dash_rx60.png]
|  |  |

### 시스템 구성과 실물

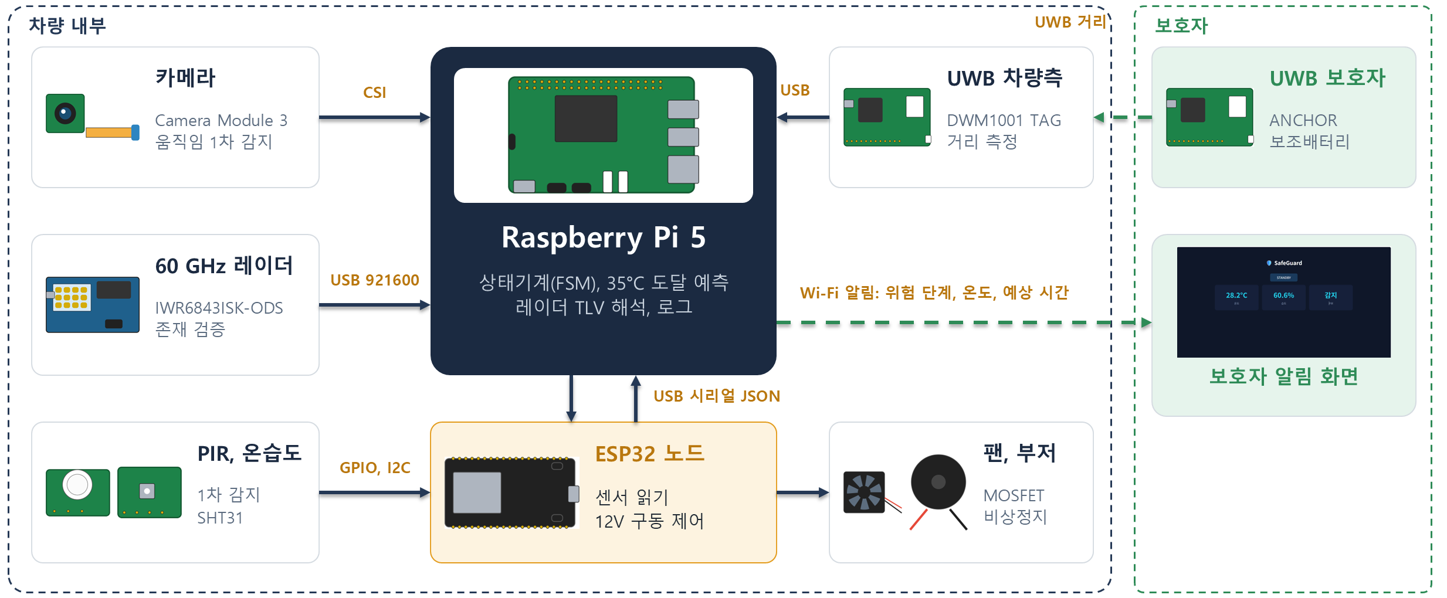
[picture p32: docs/presentation/img/final/system_diagram_crop.png]
SafeGuard 시스템 구성도


| 결선 시제품 전체 (2026.10.28) | 블록 B, C: Pi 5, 카메라, 레이더, UWB |
|---|---|
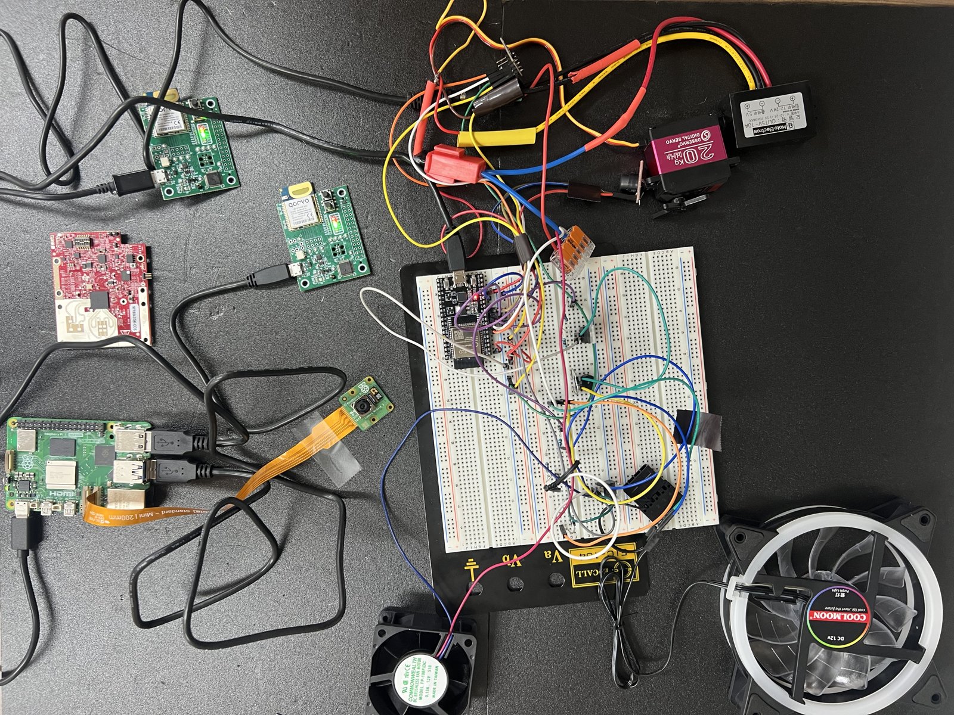
[picture p33: docs/presentation/img/final/sys_overview.jpg]
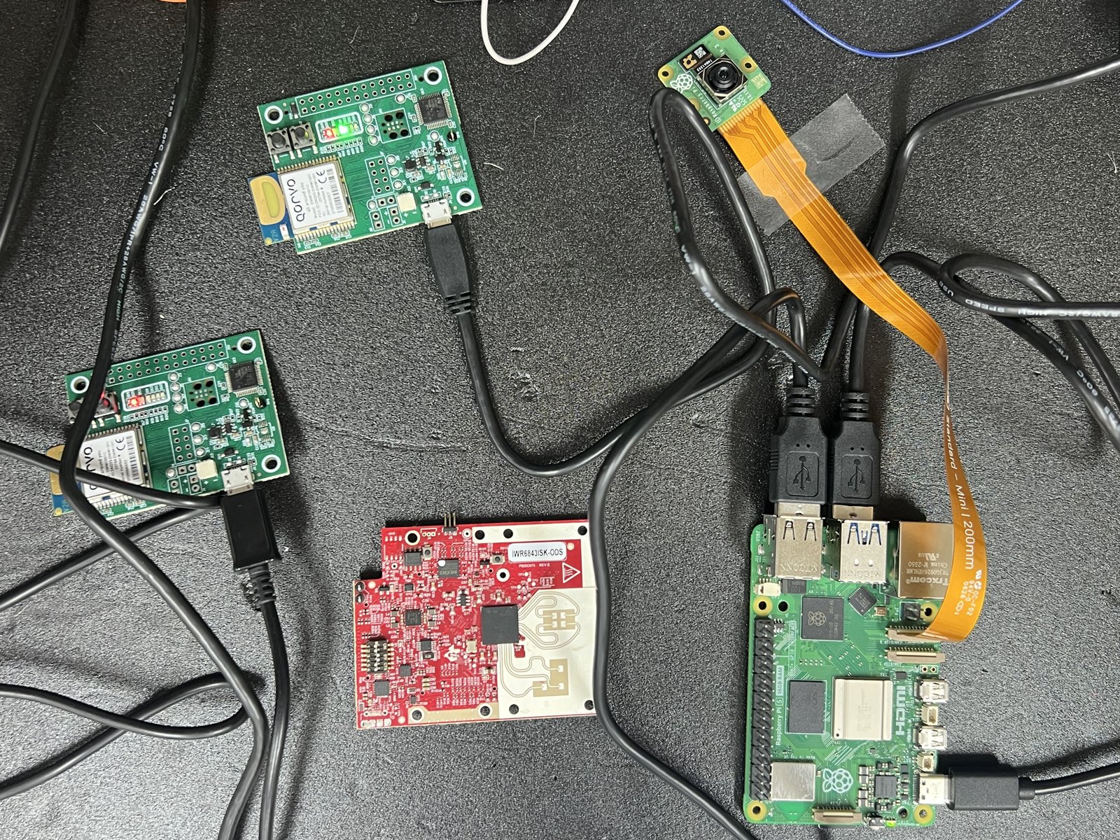
[picture p34: docs/presentation/img/final/pi_radar_uwb.jpg]
|  |  |
| **블록 A: ESP32, 12V 팬, 부저** | **레이더 정지 착석 시험 배치 (2026.10.27)** |
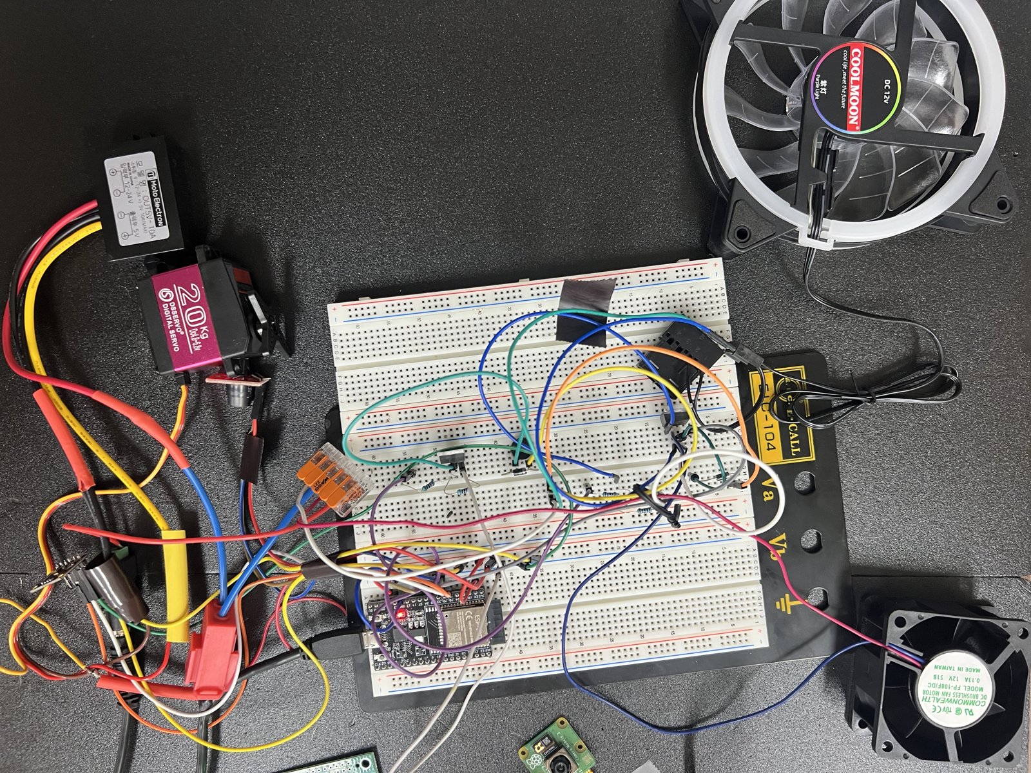
[picture p35: docs/presentation/img/final/blockA_fan.jpg]
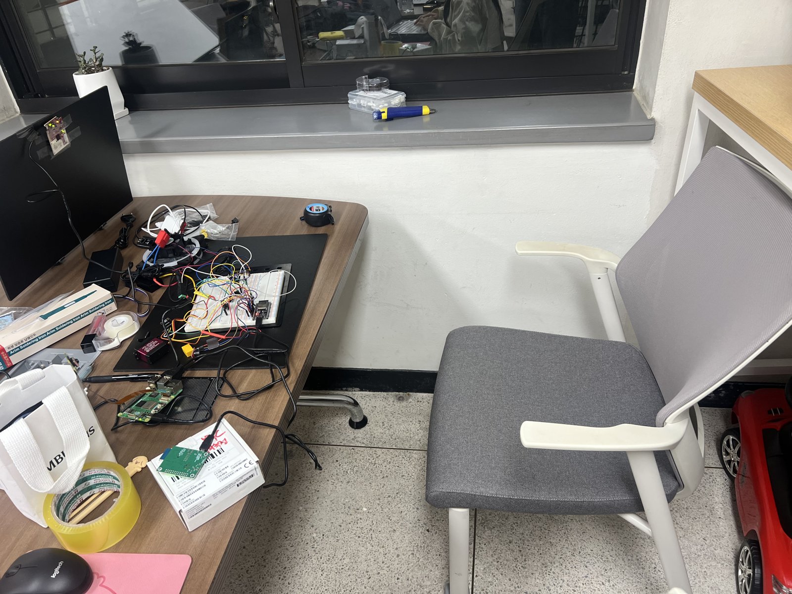
[picture p36: docs/presentation/img/final/radar_test_setup.jpg]
|  |  |

### 60 GHz 레이더 측정 결과 (IWR6843ISK-ODS, TI 3D People Tracking)

**1. 감지 영역을 차 실내 크기로 줄이자, 가만히 앉은 1명을 5분 동안 95.7% 정확히 1명으로 판정했다.**
TI 원본 cfg(6 m 방 기준)에서는 같은 조건에서 0%였다 (벽 다중 반사로 유령 추적 2에서 5개).

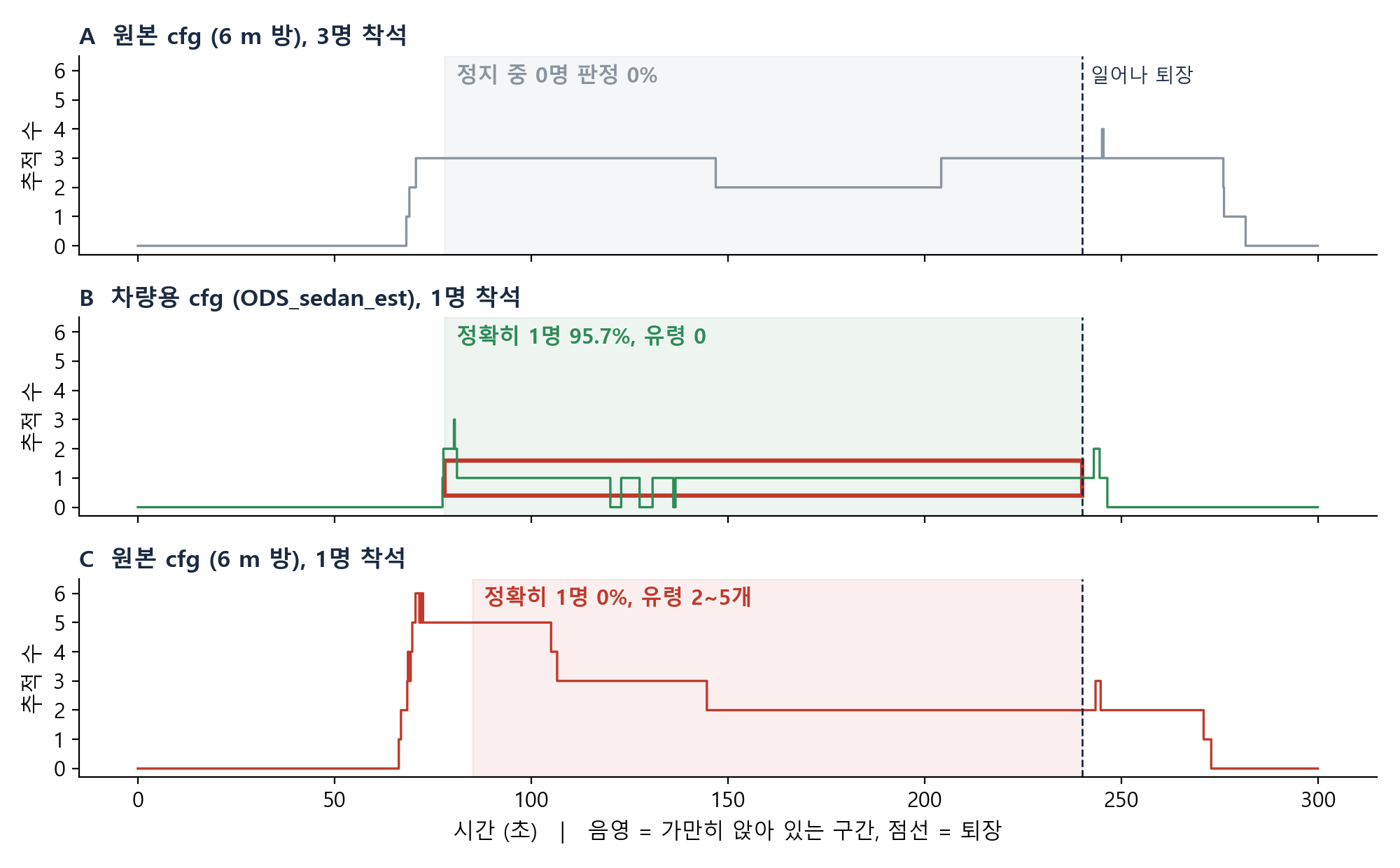
[picture p37: docs/presentation/img/final/fig_still_tests.png]
정지 착석 시험 A/B/C


**2. 하차 후 추적이 남는 시간.** 원인은 정지 추적 소거 시간 `static2free 3000`(약 165초)으로 분석했다.

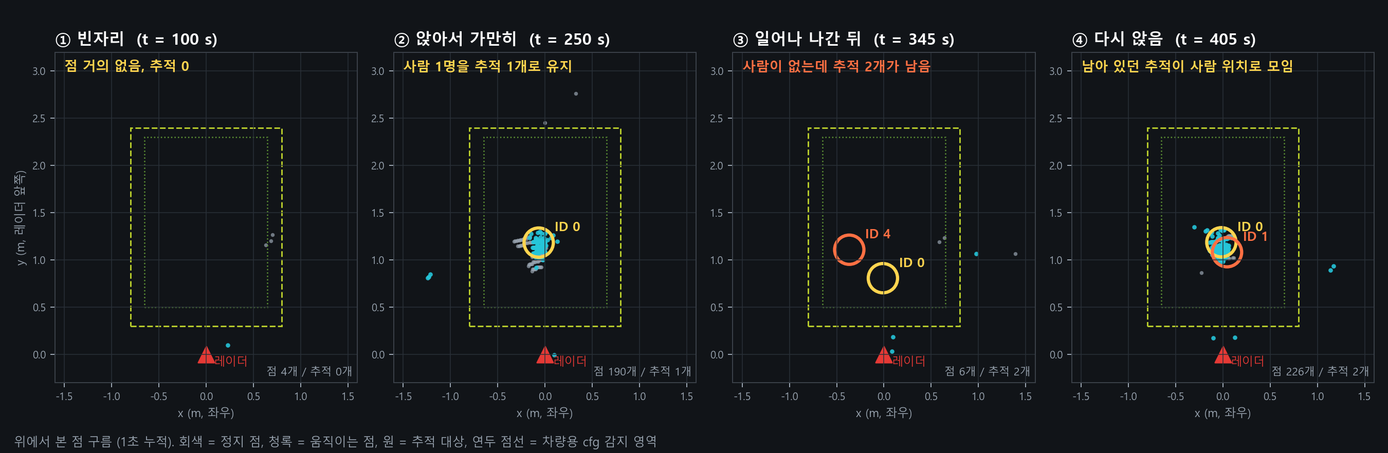
[picture p38: docs/presentation/img/final/fig_pointcloud.png]
시험 3 점 구름 4장면


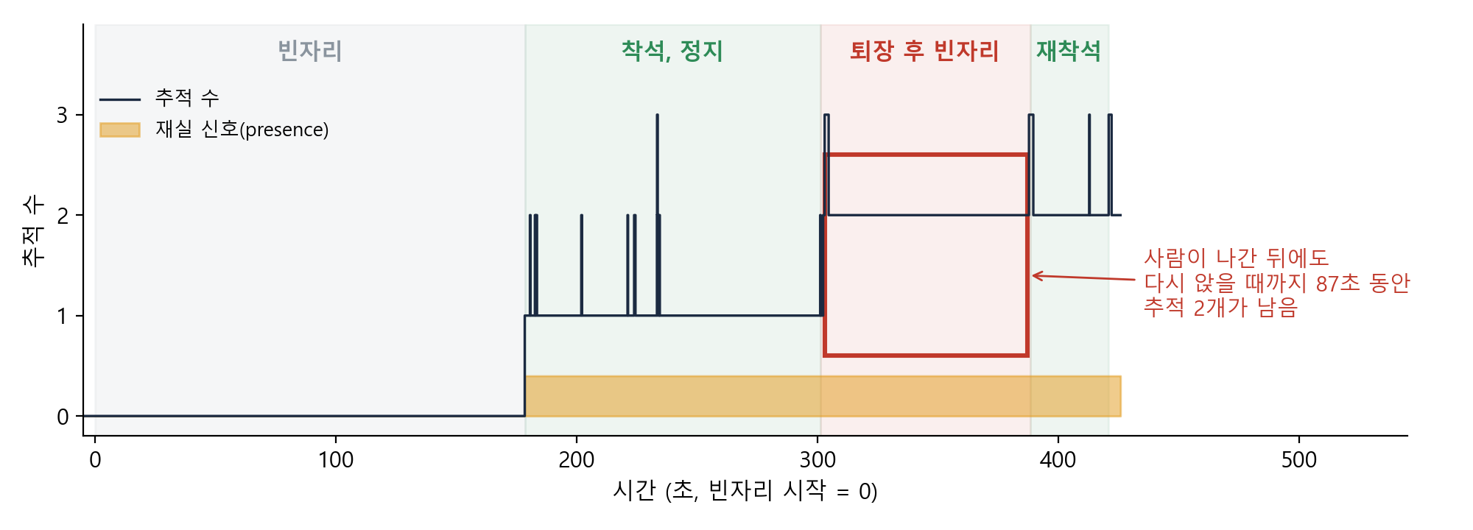
[picture p39: docs/presentation/img/final/fig_test3_timeline.png]
시험 3 타임라인


| Raspberry Pi 5 수신 안정성 | 카메라 조명 변화 시험 |
|---|---|
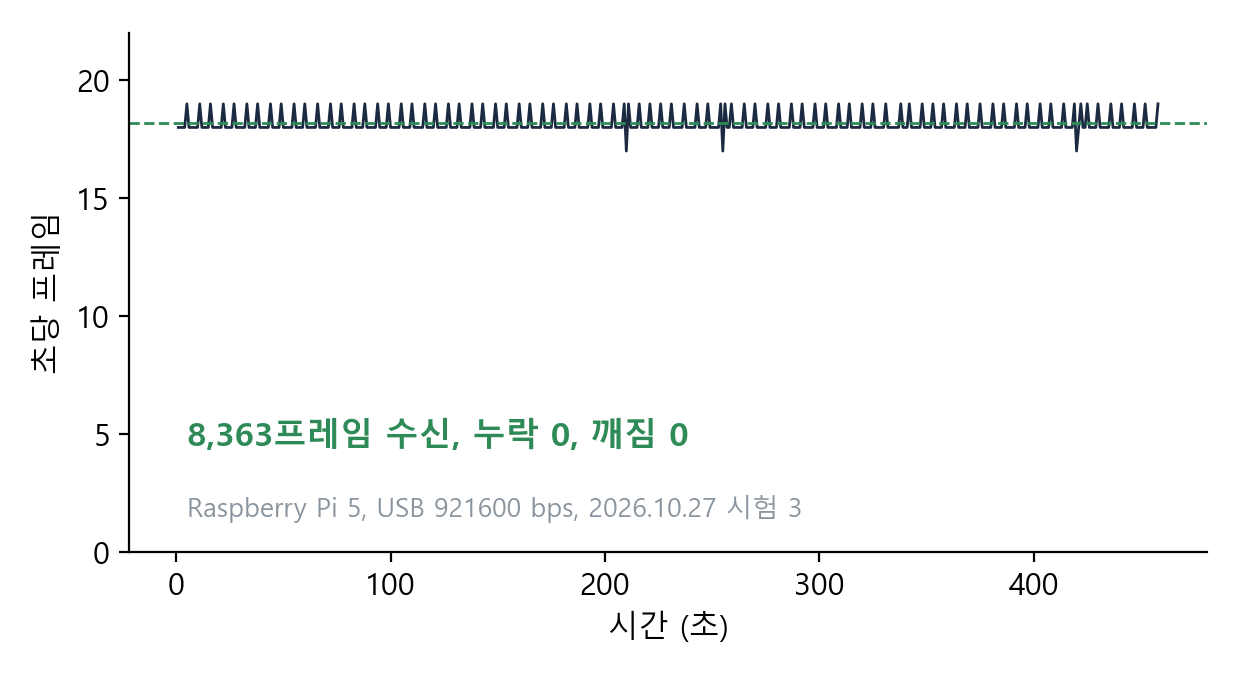
[picture p40: docs/presentation/img/final/fig_pi_fps.png]
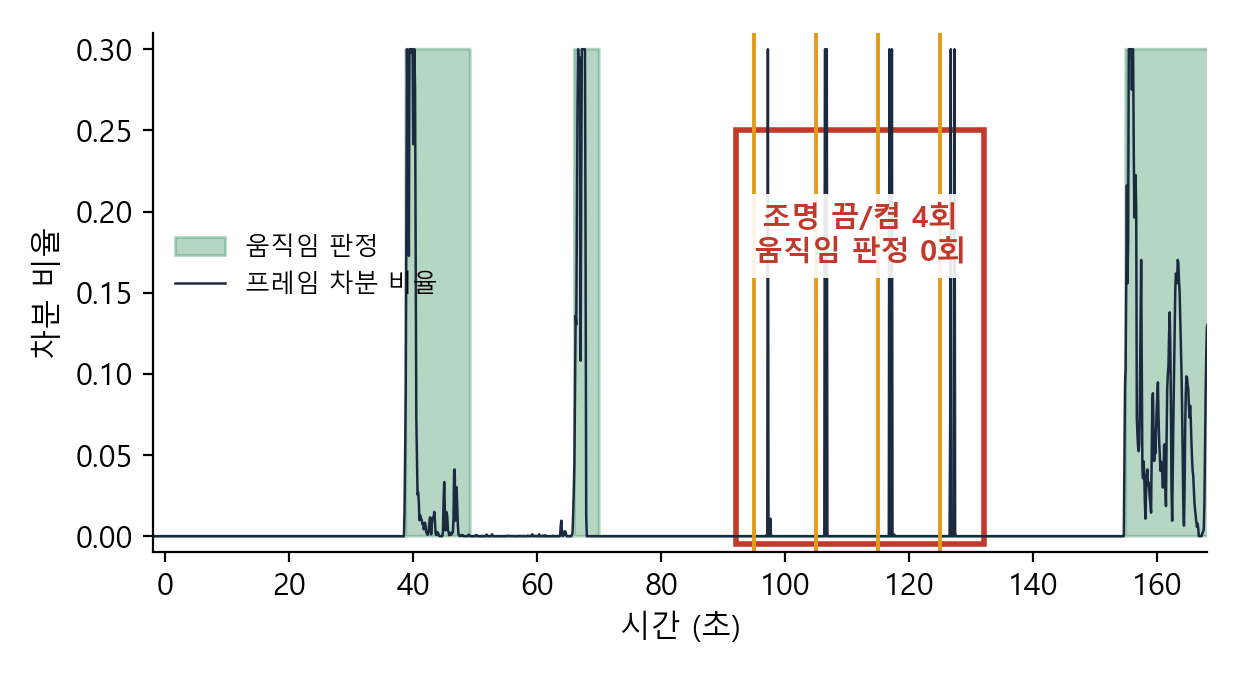
[picture p41: docs/presentation/img/final/fig_cam_light.png]
|  |  |
| 460초 동안 8,363프레임, 누락 0, 깨짐 0 (18.2 fps) | 천장 조명 끔/켬 4회, 움직임 오검출 0회 |

### 센서 검증 그래프 (시간 축 기록)

**카메라와 레이더 같은 시간축 비교 (시험 3).** 카메라는 움직일 때만, 레이더는 가만히 앉아 있어도 잡는다. 퇴장 뒤 레이더 추적이 남는 구간도 함께 보인다.

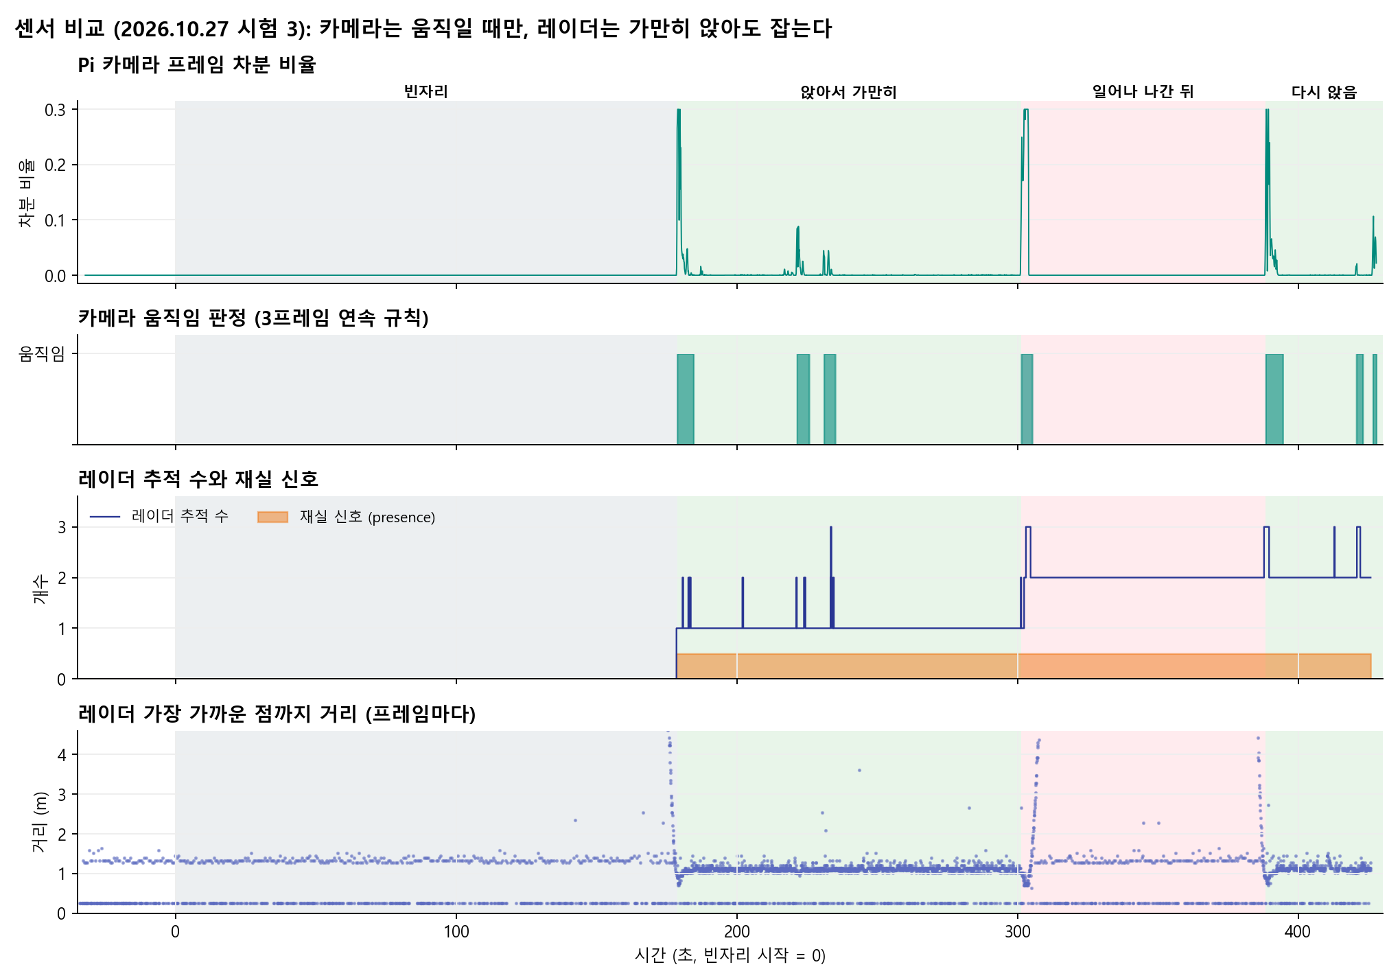
[picture p42: docs/presentation/img/final/fig_val_fusion.png]
카메라와 레이더 비교


**레이더 수신 품질.** 시험 3(460초)과 Pi 60초 수신 모두 누락 0, 깨짐 0, 프레임 간격 중앙값 55 ms.

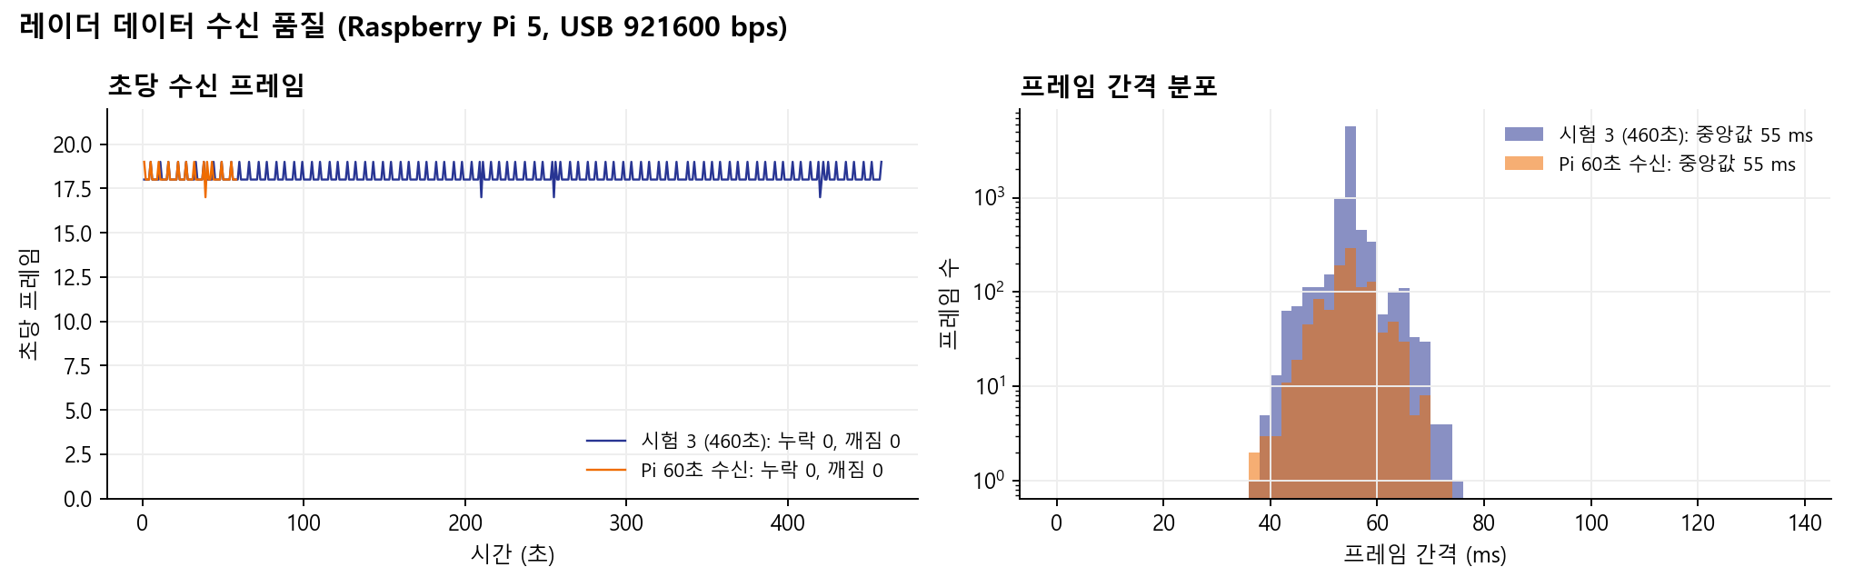
[picture p43: docs/presentation/img/final/fig_val_rates.png]
레이더 수신 품질


**7월 1차 시제품 로그 (Pi 4B, DHT22, PIR, 릴레이, 180초).** 결선 장비(SHT31, ESP32) 이전 시제품의 데이터 로거 기록.

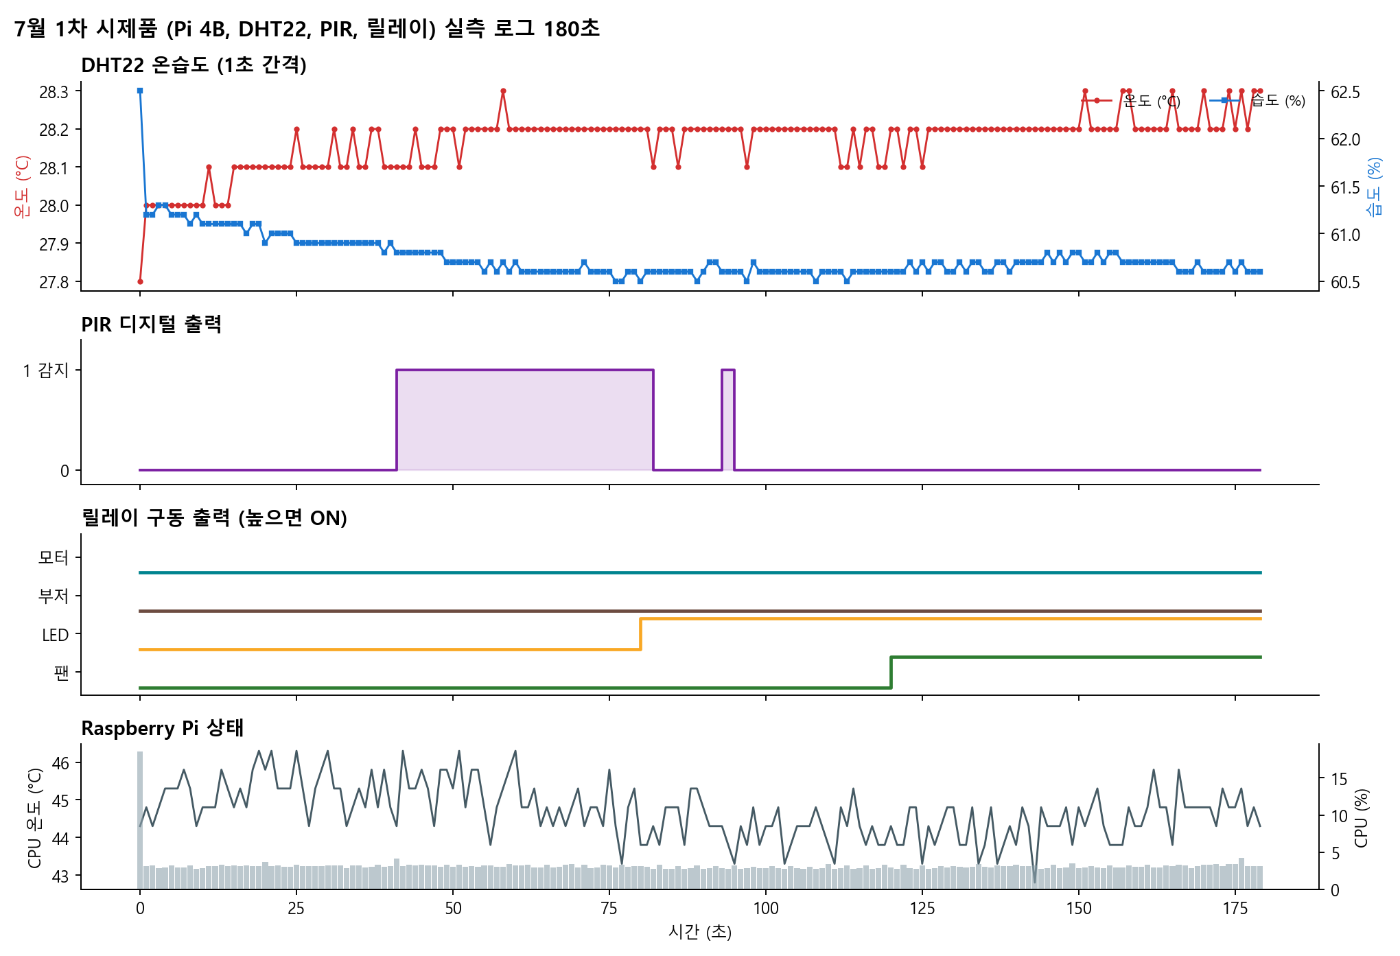
[picture p44: docs/presentation/img/final/fig_val_logger.png]
1차 시제품 로그


자세한 시험 기록: [`hardware/mmwave/people_tracking/README.md`](hardware/mmwave/people_tracking/README.md), [`hardware/HANDOFF_BLOCK_B.md`](hardware/HANDOFF_BLOCK_B.md)

## 2.3 소비전력 추정

전류계 실측은 아직 하지 못해, **데이터시트 대표값**에 실제 상태기계 설정(`configs/real.json`: 이탈 확인 10 s, 융합 창 2 s)을
곱해 계산했다. 계산: [`docs/figures/power/build_power_estimate.py`](docs/figures/power/build_power_estimate.py)

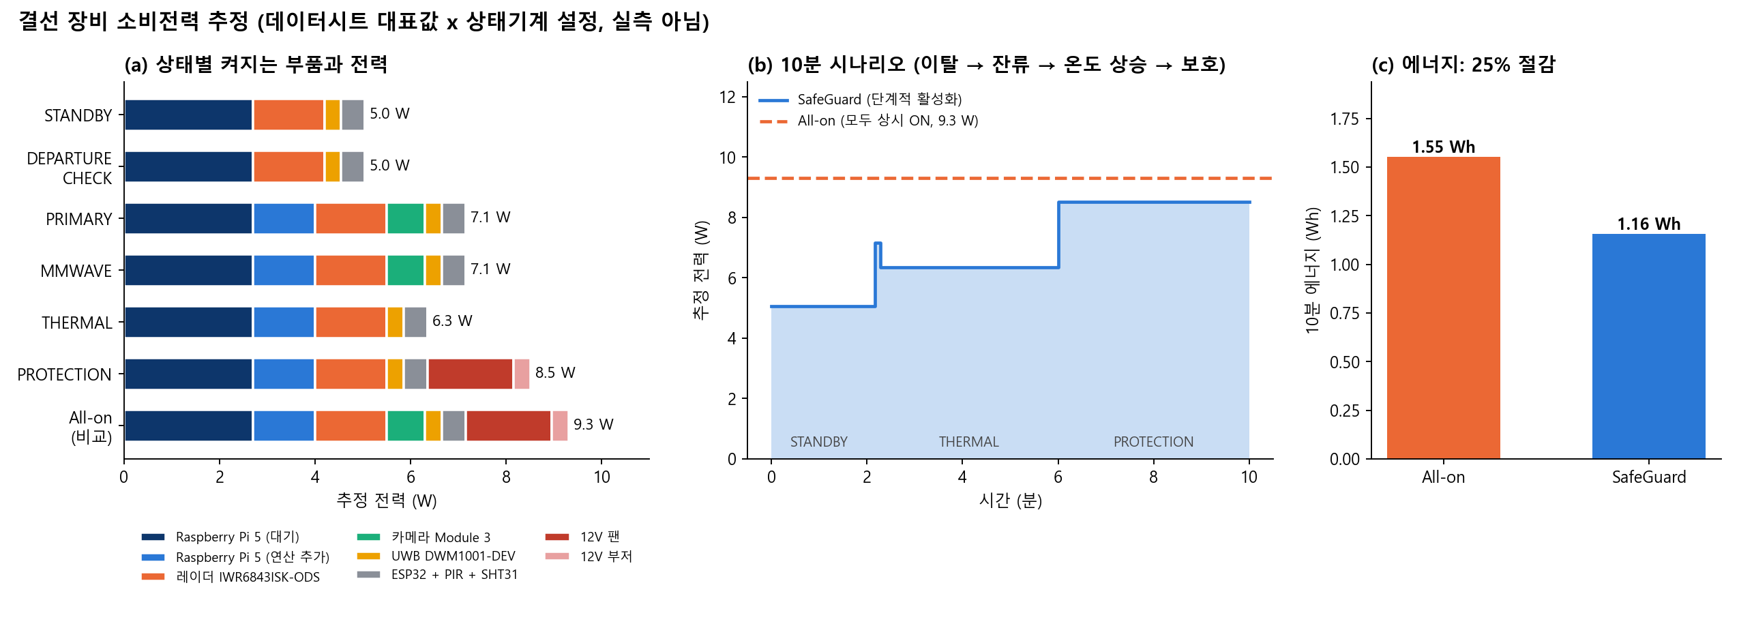
[picture p45: docs/figures/power/fig_power_estimate.png]
결선 장비 소비전력 추정


| 항목 | 추정값 |
|---|---|
| 대기 (STANDBY: Pi 5, 레이더, UWB, ESP32) | 5.0 W |
| 보호 (PROTECTION: + Pi 연산, 12V 팬, 부저) | 8.5 W |
| 모든 부품 상시 ON (All-on) | 9.3 W |
| 10분 시나리오 에너지 (이탈 → 잔류 → 온도 상승 → 보호) | All-on 1.55 Wh, SafeGuard 1.16 Wh (**25% 절감**) |
| 주차 대기 1시간 | All-on 9.3 Wh, SafeGuard 5.0 Wh |

현재 레이더는 한 번 멈추면 USB를 다시 꽂아야 켜지므로 계속 전원이 들어가 있다. 그래서 절감은 Pi 연산, 카메라, 구동부에서만
생긴다. 레이더 전원 제어(저전력 모드)까지 넣으면 대기 전력을 더 줄일 수 있다. 측정 방법은 [`hardware/power/README.md`](hardware/power/README.md).

# 3. 결론과 시사점

각 결과 옆에 근거 수준을 적었다: **[센서 실측]** 장치로 잰 값, **[실차 시연]** 실제 차량에서 확인, **[소프트웨어 시험]** 코드 시험,
**[사후 분석]** 기록을 다시 분석한 값, **[추정]** 계산값, **[계획]** 아직 하지 않은 것.

## 3.1 확인한 성과

1. **단계적 활성화를 하나의 상태기계로 구현했다 [소프트웨어 시험].** UWB 이탈 확인 → PIR, 카메라 → 레이더 → 온도 예측 →
   팬, 부저, 서보 요청까지 C++ 상태기계(상태 10개)로 이어진다. 다음 단계의 처리와 판단은 앞 단계 이벤트가 있을 때만 켜진다.
   레이더 등 센서의 전원은 계속 들어가 있어, 단계적으로 켜는 것은 처리와 판단이다.
2. **보호자 이탈을 거리로 판단한다 [센서 실측].** UWB 거리 잡음은 표준편차 3.5 cm이고, 7점 이동평균으로 잡음을 절반으로 줄이며 지연은 약 1.6초다.
3. **가만히 앉은 사람을 레이더가 잡는다 [센서 실측].** 감지 영역을 차 실내 크기로 줄이자 5분 정지 착석 시험에서 1명으로 정확히 판정한 비율이
   0%에서 95.7%로 올랐다. 같은 조건에서 카메라 움직임 판정은 7.4%(프레임 기준)였다. 레이더 단독 시험 결과이며 전체 시스템의 미검출률은 아니다.
4. **수신이 안정적이다 [센서 실측].** Raspberry Pi 5에서 레이더 8,363프레임(460초)을 누락 0, 깨짐 0으로 받았다.
5. **센서끼리 약점을 보완한다 [센서 실측, 사후 분석].** 카메라는 조명 변화에 오검출 0회였다. 하차 뒤 남는 레이더 유령 추적은
   추적 주변 점 근거를 확인하면 시험 3에서 퇴장 뒤 오판 0%가 된다(사후 분석, 메인 코드 미반영).
6. **온도가 35 °C(프로젝트 설정값)에 닿기 전에 보호를 요청한다 [소프트웨어 시험].** 합성 상승 이력에서 현재 34.5 °C, 약 51초 뒤 35 °C 도달
   예측으로 PROTECTION에 들어가 팬, 부저 요청을 확인했다. 실차에서 선제 출력이 켜진 시험은 아직 아니다.
7. **실제 차량에 옮겨 달았다 [실차 시연].** 전동차에서 만든 센서와 제어부를 실제 차량에 설치하고 대시보드와 연결했다.
   팬 2개와 부저 작동, 소프트웨어 전체 정지 후 꺼짐을 확인했다. 현재 시연은 레이더 USB 소켓 파손으로 레이더 입력 없이 대체 판단 경로로 진행한다.
8. **전력 [추정].** 데이터시트 대표값 기준 대기 5.0 W, 10분 시나리오에서 모든 부품 상시 구동 대비 약 25% 절감.

## 3.2 시사점

- **기존 차량에 붙이는 모듈**: 차량 배선을 바꾸지 않고 12V 전원과 USB만으로 동작해, 이미 운행 중인 통학차량, 승용차, 렌터카에도 붙일 수 있다.
- **레이더가 꼭 필요한 이유**: 카메라와 PIR은 가만히 있는 아이를 놓치기 쉽다. 정지 착석 시험에서 카메라 7.4%, 레이더 95.7%로 차이가 컸다.
  잔류 감지에서는 움직임이 없는 상황을 잡는 센서가 핵심이다.
- **설정과 시험 조건이 결과를 좌우한다**: 같은 레이더도 감지 영역 설정 하나로 0%와 95.7%가 갈렸고, 정지 추적 소거 시간 설정 하나로
  하차 뒤 잔존 시간이 크게 달라졌다. 차량마다 설치 위치와 영역을 맞추는 보정 절차가 제품화에 필요하다.
- **고장에 대비한 대체 경로**: 레이더가 응답하지 않으면 PIR과 카메라가 둘 다 반응할 때 "의심"으로 보호를 이어 간다.
  실제로 레이더 소켓이 파손된 지금도 이 경로로 시연을 진행할 수 있었다.
- **"현재 온도"보다 "도달까지 남은 시간"**: 온도가 오르는 속도를 보면 기준에 닿기 전에 환기를 시작할 수 있다. 다만 차량별 예측 정확도는 아직 검증하지 않았다.
- **규제, 평가 방향과의 연결**: Euro NCAP의 어린이 잔류 감지 평가처럼 "정지한 아이를 찾고 경고와 대응까지 이어지는가"를 보는 기준에
  레이더 확인과 선제 보호 흐름이 맞닿아 있다.

## 3.3 다음 검증 [계획]

| 항목 | 방법 |
|---|---|
| 레이더 복구 후 통합 시험 | 소켓 교체 뒤 실제 차량에서 이탈 → 레이더 확인 → 보호 전 과정 기록 |
| 선제 보호 실차 시험 | 실제 35 °C 이전에 예측 조건으로 팬, 부저, 서보가 켜지고 전체 정지로 꺼지는지 영상과 로그로 확인 |
| UWB 실거리 시험 | 줄자로 5 m 지점 표시 후 이탈 판정 시간 측정 |
| 소비전력 실측 | 12V 입력 전류계 + USB 전력계로 상태별 60초씩 3회 ([측정 계획](hardware/power/README.md)) |
| 유령 추적 대책 반영 | 정지 추적 소거 시간 조정과 점 근거 확인을 메인 코드에 넣고 하차 시험 반복 |
| 열 예측 정확도 | 실제 차량 온도 기록으로 35 °C 도달 시간 예측 오차 측정 |

# 부록

## 부록 A. Vital Signs 호흡수 측정 시도

컨설팅에서 "먼저 레이더로 미세 움직임(재실)을 잡고, 호흡수와 심박수는 가능하면 해 보라"는 의견을 받아 TI Vital Signs 펌웨어로 시도했다.

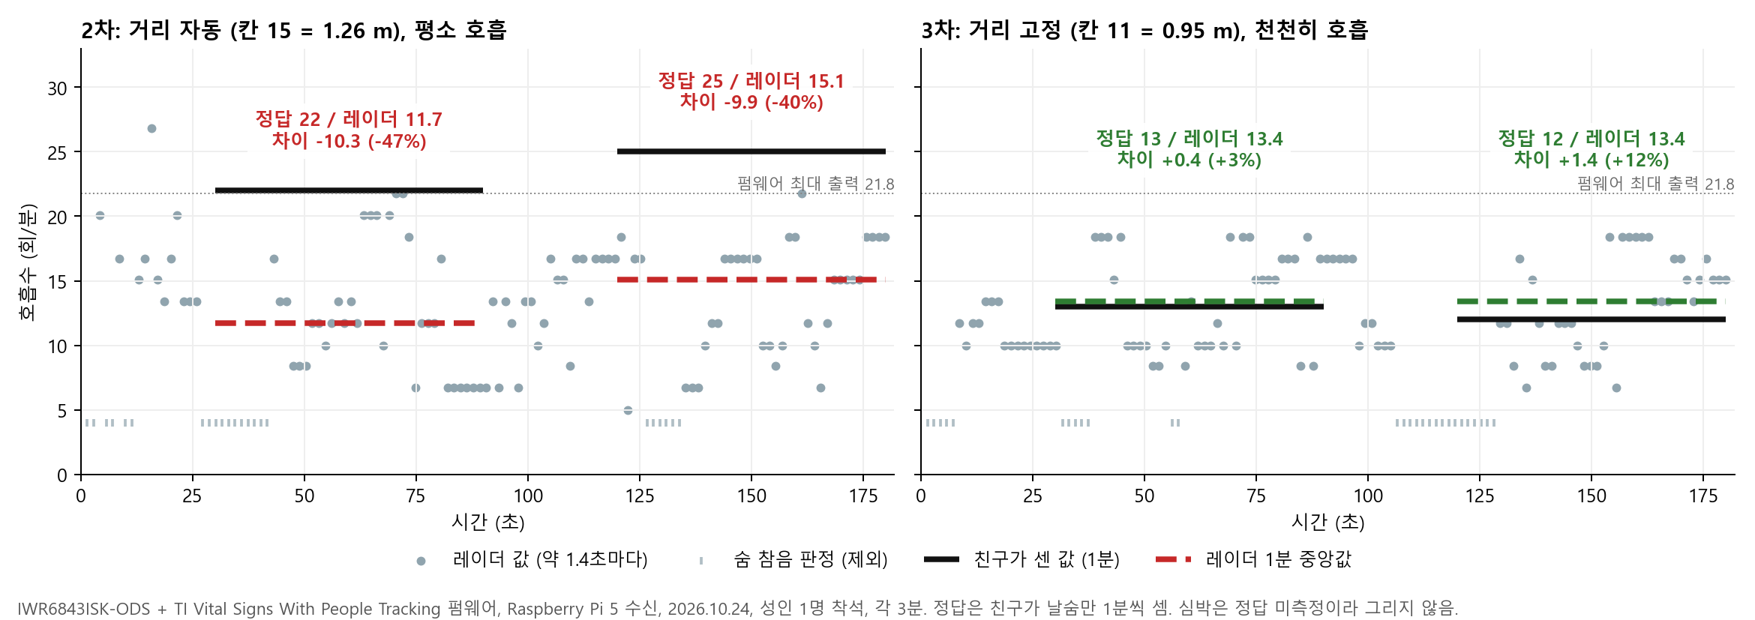
[picture p46: docs/presentation/img/final/fig_vital_breath.png]
레이더 호흡수와 직접 센 값 비교


- **조건**: 레이더 앞 약 0.95 m 착석, 거리 칸 11 고정, 안정 호흡(분당 12에서 13회), 날숨을 1분씩 직접 세어 비교 (2026.10.24, Pi 5 수신)
- **결과**: 거리 칸을 고정한 3차 시험에서 1분 중앙값이 직접 센 값과 분당 0.4에서 1.4회 차이로 따라왔다.
  거리 칸을 자동으로 둔 2차 시험보다 크게 나아졌다.
- **활용**: 잔류 감지에는 People Tracking 펌웨어를 쓰고, 호흡 측정은 차 안 아이의 상태를 더 알려 주는 확장 기능으로 남겨 둔다.

## 부록 B. TwinLab 시뮬레이터 (예선 제출본)

실제 장치로 만들기 어려운 상황(레이더 무응답, PIR 오탐, 센서 고장)을 반복해서 시험하려고 예선 때 만든 시뮬레이터다.
같은 상태기계 규칙을 Python으로 옮겨, 시나리오별 상태 전이와 전력 비교를 확인한다.

### 목차

1. [프로젝트 개요](#1-프로젝트-개요)
2. [시스템 구조](#2-시스템-구조)
3. [실행 방법](#3-실행-방법)
4. [입력 CSV 형식](#4-입력-csv-형식)
5. [Dashboard 사용법](#5-dashboard-사용법)
6. [Output-level Virtual Sensor Simulation](#6-output-level-virtual-sensor-simulation)
7. [Estimated Power Model](#7-estimated-power-model)
8. [Continuous vs Duty-cycle Actuator Policy](#8-continuous-vs-duty-cycle-actuator-policy)
9. [결과 자동 생성 (Export)](#9-결과-자동-생성-export)
10. [Sample Data & Demo Mode](#10-sample-data--demo-mode)
11. [테스트](#11-테스트)
12. [한계와 향후 개선점](#12-한계와-향후-개선점)

## 1. 프로젝트 개요

SafeGuard는 보호자가 차량에서 이탈한 후 차량 내부에 잔류 탑승자가 있는지
단계적으로(Cascading Wake-up) 확인하고, 위험 온도에 도달하기 전에
fan/LED/buzzer/DC motor를 제어해 완화 조치를 취하는 시스템이다.

이 저장소는 SafeGuard의 동작을 **재현 가능한 시뮬레이션**으로 구현하고,
아래 4가지 비교 모델(All-on / PiBase-style / Staged operation / SafeGuard
proposed)의 추정 전력·에너지를 비교하여 절감 효과를 정량화한다. 모든
결과는 Streamlit dashboard와 CLI 스크립트 양쪽에서 동일한 core simulation
engine(`src/`)을 통해 생성되며, pytest로 상태 전이·전력 계산의 정확성을
검증한다.

## 2. 시스템 구조

```
.
├── app/
│   └── streamlit_app.py       # 대시보드 (Demo Mode, Evidence Panel, 9개 섹션)
├── src/
│   ├── config.py               # 상수, 임계값, ScenarioConfig, Demo Mode 프리셋
│   ├── data_loader.py          # hardware_log.csv 검증/정규화/dummy 생성
│   ├── virtual_sensors.py      # UWB/mmWave/Camera output-level virtual sensor
│   ├── state_machine.py        # SafeGuard event-driven state machine
│   ├── device_activation.py    # Cascading Wake-up 기반 device ON/OFF 표
│   ├── power_model.py          # 추정 전력/에너지 계산
│   ├── model_comparison.py     # All-on/PiBase/Staged/SafeGuard 비교
│   ├── report_generator.py     # 표/그림/해석문/캡션/한계/Q&A 생성
│   └── pipeline.py             # 위 모듈을 엮는 end-to-end 오케스트레이션
├── scripts/
│   ├── run_dashboard.sh        # streamlit 대시보드 실행
│   ├── run_tests.sh            # pytest 전체 실행
│   ├── generate_paper_outputs.py  # CLI로 paper-ready export 번들 생성
│   ├── clean_outputs.py        # outputs/ 초기화
│   └── regenerate_sample_data.py  # sample_data/ CSV 재생성(참고용)
├── sample_data/                # 재현 가능한 예시 hardware_log.csv 3종
├── hardware/                   # 실제 Raspberry Pi 전용 코드 (dashboard는 import하지 않음)
│   ├── pi_hardware_logger.py   # gpiozero/RPi.GPIO/adafruit_dht/board 사용
│   └── requirements-pi.txt     # 하드웨어 전용 의존성 (웹 배포 requirements.txt와 분리)
├── tests/                      # pytest 단위/통합 테스트
├── outputs/
│   ├── csv/                    # 결과 표
│   ├── figures/                # 결과 그림(PNG)
│   └── report/                 # 결과 해석문/캡션/한계/Q&A(TXT)
├── docs/                       # GitHub Pages 홈페이지 + paper-ready 샘플 산출물
├── .claude/agents/             # 커스텀 서브에이전트 7종 (역할 분리)
└── requirements.txt             # 웹 배포용 (Raspberry Pi 전용 패키지 미포함)
```

### 데이터 흐름

```
hardware_log.csv (또는 dummy)  ┐
                                 ├─ build_simulation_frame ─ run_state_machine
UWB/mmWave/Camera virtual log  ┘         │
                                          ▼
                         device_activation (Cascading Wake-up, continuous/duty-cycle)
                                          │
                                          ▼
                         power_model (추정 전력 timeline, energy by state)
                                          │
                                          ▼
                model_comparison (All-on / PiBase / Staged / SafeGuard 비교)
                                          │
                                          ▼
                    report_generator (표 CSV / 그림 PNG / 해석문·캡션·한계·Q&A TXT)
```

### SafeGuard state machine

```
UWB_DEPARTURE_CHECK → PIR_CAMERA_CHECK → MMWAVE_CHECK → THERMAL_PREDICTION → ACTUATOR_CONTROL
                                              │
                                              └─ (timeout) → FAIL_SAFE
```

## 3. 실행 방법

### 3.1 의존성 설치

```bash
python -m pip install -r requirements.txt
```

### 3.2 Dashboard 실행

```bash
bash scripts/run_dashboard.sh
# 또는
python -m streamlit run app/streamlit_app.py
```

브라우저에서 `http://localhost:8501` 접속.

### 3.3 테스트 실행

```bash
bash scripts/run_tests.sh
# 또는
python -m pytest tests/ -v
```

### 3.4 CLI로 결과 자동 생성 (대시보드 없이)

```bash
# 기본 시나리오
python scripts/generate_paper_outputs.py

# Demo Mode 프리셋 사용
python scripts/generate_paper_outputs.py --demo normal_risk

# 실제/샘플 hardware_log.csv + 프리셋 조합
python scripts/generate_paper_outputs.py \
    --hardware-csv sample_data/sample_hardware_log_failsafe.csv \
    --demo mmwave_timeout

# 사용 가능한 --demo 옵션 확인
python scripts/generate_paper_outputs.py --list-demos
```

### 3.5 outputs/ 초기화

```bash
python scripts/clean_outputs.py
```

### 3.6 웹에서 바로 실행 (Streamlit Community Cloud)

설치 없이 아래 주소에서 바로 열린다 (예선 때 배포한 TwinLab 대시보드).

- https://safeguard-mmwave-simulator.streamlit.app/
- 시작 파일: `app/streamlit_app.py`, 설치 목록: 저장소 루트 `requirements.txt` (Raspberry Pi 전용 패키지는 `hardware/requirements-pi.txt`로 분리)
- 사이드바의 Demo Mode 버튼(Normal Risk, No Occupant, mmWave Timeout Fail-safe, Duty-cycle Optimized)으로 시나리오를 바로 볼 수 있다.

## 4. 입력 CSV 형식

### hardware_log.csv (필수 스키마)

| 컬럼 | 설명 |
|---|---|
| `time_s` | 경과 시간(초) |
| `state` | 원본 로그 상태 라벨(파이프라인이 재계산하므로 참고용) |
| `pir_val` | PIR 감지(0/1) |
| `temp_c` | DHT22 온도(°C) |
| `humidity` | DHT22 습도(%) |
| `relay_fan` / `relay_led` / `relay_buzzer` / `relay_motor` | 릴레이 채널 상태(0/1, ON/OFF, True/False 모두 허용) |
| `cpu_temp_c` | Raspberry Pi CPU 온도(°C) |
| `cpu_percent` | Raspberry Pi CPU 사용률(%) |

- 파일이 없으면 `src/data_loader.py`가 재현 가능한 dummy 데이터를 생성한다.
- 결측치는 선형보간, DHT22 read failure는 자동 감지·보간되며
  `dht22_failure_flag`로 표시된다.
- hardware_log.csv에는 온도, PIR, 구동 출력만 들어 있다. UWB, 레이더, 카메라는 시뮬레이터에서 시나리오 설정
  (occupant_exists, mmwave_mode 등)으로 만든다. 실제 센서 연동은 결선 장치 코드
  [`prototype/SafeGuard_Main`](prototype/SafeGuard_Main/)가 맡는다 (아래 12장 참고).

### power_measure_log.csv (선택, 실측 검증용)

| 컬럼 | 설명 |
|---|---|
| `time_s` | 경과 시간(초) |
| `state` | 상태 라벨 |
| `voltage_v` | 실측 전압(V) |
| `current_a` | 실측 전류(A) |
| `power_w` | 실측 전력(W) |

`src/data_loader.load_power_measure_log()`로 읽어 estimated power model과
교차 비교하는 용도로만 사용한다(파이프라인 필수 입력 아님).

## 5. Dashboard 사용법

사이드바 구성:

- **Demo Mode**: 4개 버튼(Normal Risk / No Occupant / mmWave Timeout
  Fail-safe / Duty-cycle Optimized)으로 완결된 시나리오를 한 번에 적용.
- **Failure Scenario Simulation**: mmWave timeout, PIR false positive,
  Camera dark, DHT22 fail, No occupant, Guardian nearby 개별 edge case 토글.
- **시나리오 파라미터**: duration, occupant exists, guardian departure
  time, 온도/습도, light/motion condition, mmWave mode, actuator policy
  (continuous/duty_cycle), hardware_log.csv 업로드.

메인 화면 구성:

| 섹션 | 내용 |
|---|---|
| Evidence Panel | 데이터 소스(Dummy/실측), 센서 유형(Virtual), 전력 유형(Estimated) 표시 |
| 1. Scenario Summary | 현재 적용된 시나리오 파라미터 표 |
| 2. State Machine Event Log | 상태 전이 이력 |
| 3. Sensor Timeline | UWB 거리, DHT22 온도 timeline |
| 4. State Timeline | SafeGuard 상태 timeline |
| 5. Power Timeline | 추정 전력 timeline (선택된 정책 기준) |
| 6. Energy by State | state별 추정 에너지 |
| 7. Model Comparison | All-on/PiBase/Staged/SafeGuard(continuous+duty-cycle) 비교표·그래프 |
| 8. Paper-ready Korean Summary | 결과 해석문 + "Paper-ready 자동 생성" 버튼(11개 파일 저장/다운로드) |
| 9. Judge Mode Feedback | 약점/반박/추가실험/데모포인트 + "예상 Q&A 보기" |

시나리오 조건을 바꾸면 `st.cache_data`가 변경을 감지해 전체 파이프라인이
자동으로 재계산된다.

## 6. Output-level Virtual Sensor Simulation

UWB(DWM1001-DEV 등가)와 mmWave 센서 데이터는 **raw RF/radar signal(FMCW
chirp, FFT spectrum, 다중경로 반사 등)을 물리적으로 모델링하지 않는다.**
대신 시나리오 조건(보호자 이탈 시점, 탑승자 존재 여부, mmWave 모드 등)에
따라 최종 output 값(거리, presence flag, velocity, confidence 등)만
합성하는 **output-level virtual sensor simulation**이다.

지원하는 mmWave edge case (mmWave mode):

| 모드 | 설명 |
|---|---|
| `normal` | 정상 감지 (presence=1, 유효 거리 범위) |
| `no_occupant` | 탑승자 없음, presence 항상 0 |
| `intermittent` | 통신이 간헐적으로 끊김(무응답) |
| `timeout` | 센서가 전 구간 무응답 → FAIL_SAFE 유발 |
| `out_of_range` | presence는 감지되나 거리값이 유효 범위 밖 |

### mmWave Sensor Profile

mmWave는 단일 센서로 고정되지 않고, 사이드바의 **mmWave Sensor Profile**
셀렉트박스에서 아래 두 profile 중 선택할 수 있다. 두 profile 모두 raw
signal processing을 수행하지 않는 output-level simulation이며, 실제
해당 하드웨어를 사용했다는 의미가 아니다.

| Profile | Output fields | Confirmation rule |
|---|---|---|
| `C4001_24GHz_LOW_COST` (저가형 24GHz human presence radar) | response_ok, presence_flag, distance_m, velocity_mps, confidence_score | response_ok, presence=1, 0.2-3.0 m, confidence≥0.6, 연속 5프레임 |
| `TI_IWR6843ISK_REFERENCE` (TI IWR6843ISK 기반 reference profile) | 위 필드 + point_count, angle_deg, micro_motion_score | 위 조건 + point_count≥3, confidence≥0.75(더 엄격), 연속 5프레임 |

선택한 profile은 결과 해석문 "0) Evidence" 섹션과 model comparison 표
(`mmwave_profile` 컬럼)에 그대로 기록되어 추적 가능하다.

Camera 감지도 OpenCV contour 연산을 재현하지 않고, `light_condition`에
따른 detection probability로 근사한다(예: `dark` 조건에서 감지 확률 급감).

## 7. Estimated Power Model

`src/config.py`의 `POWER_W` 딕셔너리는 **datasheet/typical-value 기반
추정치**이며 실측(measured power)이 아니다.

| 장치 | 추정 전력(W) |
|---|---|
| Raspberry Pi (idle) | 2.70 |
| Raspberry Pi (active) | 3.40 |
| Virtual UWB | 0.50 |
| PIR | 0.003 |
| Camera | 0.50 |
| Virtual mmWave | 0.80 |
| DHT22 | 0.013 |
| Relay channel (개당) | 0.36 |
| Fan | 0.50 |
| LED | 0.02 |
| Buzzer | 0.10 |
| DC motor | 0.80 |

실측 검증이 필요하면 `power_measure_log.csv`를 업로드해
`load_power_measure_log()`로 estimated 모델과 교차 비교할 수 있는 경로가
이미 마련되어 있다(자동 비교 UI는 아직 미구현, 향후 개선점 참고).

## 8. Continuous vs Duty-cycle Actuator Policy

ACTUATOR_CONTROL 단계의 두 가지 제어 전략을 **항상 함께** 계산/표시하여
비교 결과가 한쪽에 유리하게 편집되지 않았음을 투명하게 보여준다.

| 장치 | continuous | duty-cycle (개선 제어 전략) |
|---|---|---|
| Fan | 지속 ON | 10초 중 5초 ON |
| LED | 지속 ON | 2초 중 1초 ON |
| Buzzer | 지속 ON | 초기 10초 동안만 2초 중 1초 ON |
| DC motor | 지속 ON | 초기 5초만 ON |

FAIL_SAFE 상태에서는 안전을 위해 DC motor는 정책과 무관하게 항상 OFF다
(occupant_confirmed 되지 않았기 때문).

## 9. 결과 자동 생성 (Export)

대시보드의 결과 자동 생성 버튼 또는
`scripts/generate_paper_outputs.py`를 실행하면 아래 11개 파일이
`outputs/` 이하에 생성된다.

| 파일 | 위치 |
|---|---|
| `model_power_comparison.csv` | outputs/csv |
| `state_power_summary.csv` | outputs/csv |
| `event_log.csv` | outputs/csv |
| `figure_power_timeline.png` | outputs/figures |
| `figure_energy_by_state.png` | outputs/figures |
| `figure_model_energy_comparison.png` | outputs/figures |
| `figure_saving_vs_all_on.png` | outputs/figures |
| `paper_result_summary_kr.txt` | outputs/report |
| `figure_captions_kr.txt` | outputs/report |
| `limitations_kr.txt` | outputs/report |
| `judge_qna_kr.txt` | outputs/report |

(`export_manifest.txt`가 생성 목록 확인용으로 추가 저장된다.)

## 10. Sample Data & Demo Mode

`sample_data/`의 3개 CSV는 각각 대응하는 Demo Mode 프리셋과 **함께
사용할 때** 의도한 시나리오를 완전히 재현한다 (UWB/mmWave/Camera는
hardware_log.csv가 아니라 시나리오 설정에서 생성되기 때문).

| CSV | 짝지어 사용할 Demo Mode 버튼 | 결과 |
|---|---|---|
| `sample_hardware_log_normal_risk.csv` | Normal Risk Scenario | ACTUATOR_CONTROL까지 도달 |
| `sample_hardware_log_no_occupant.csv` | No Occupant Scenario | MMWAVE_CHECK에서 정지 (오탐 없이 escalation 안 됨) |
| `sample_hardware_log_failsafe.csv` | mmWave Timeout Fail-safe Scenario | FAIL_SAFE로 전이 |

각 CSV만으로도 `pir_val`/`temp_c` 패턴이 이미 다르게 설계되어 있어
(예: no_occupant는 pir_val 전 구간 0, temp_c가 32°C를 넘지 않음)
hardware 신호 자체의 차이도 Sensor Timeline에서 확인할 수 있다.
재생성하려면 `python scripts/regenerate_sample_data.py`.

## 11. 테스트

```bash
python -m pytest tests/ -v
```

상태 전이(경계값 포함), 전력/에너지 계산, device activation의 Cascading
Wake-up 배타성, 모델 비교, 리포트 생성 문구까지 pytest로 검증한다.

## 12. 한계와 향후 개선점

- 이 시뮬레이터의 전력 값은 데이터시트 기반 **추정 전력 모델**이다. 결선 장비 기준 추정은 [2.3 소비전력 추정](#23-소비전력-추정)에 있다.
- UWB, 레이더는 **출력 수준의 가상 센서**라서 다중 경로 반사, 잡음 같은 원신호 현상은 넣지 않았다.
  원신호 수준의 동작은 결선 실측(2.2절)에서 실제 레이더, UWB, 카메라 기록으로 확인했다.
- **하드웨어 기록과의 연동**: 시뮬레이터는 hardware_log.csv에서 온도와 PIR만 읽고, UWB, 레이더, 카메라는 시나리오로 만든다.
  결선에서는 이 역할을 나눠, 실제 센서 다섯 가지(UWB, 레이더, 카메라, PIR, SHT31)는 장치 코드
  [`prototype/SafeGuard_Main`](prototype/SafeGuard_Main/)의 센서 허브가 받아 C++ 상태기계에 넣고,
  시뮬레이터는 실제로 만들기 어려운 고장 상황 시험에 쓴다.
  다음 단계로, 장치가 남긴 실측 기록(UWB 거리, 레이더 추적 CSV, 카메라 판정 CSV)을 시뮬레이터에 그대로 다시 넣는 재생 모드를 추가할 계획이다.
- 향후: 전류 센서(INA219, INA226)로 추정과 실측 전력 비교, 실제 차량 장기 운용 기록으로 FAIL_SAFE 오탐, 미탐률 평가.
