SafeGuard-EWHA/2026ESWContest_mobility_DugoNaerijiMarajo/hardware/docs/SafeGuard_부품_식별_배선_그림책_v1.0.pdf

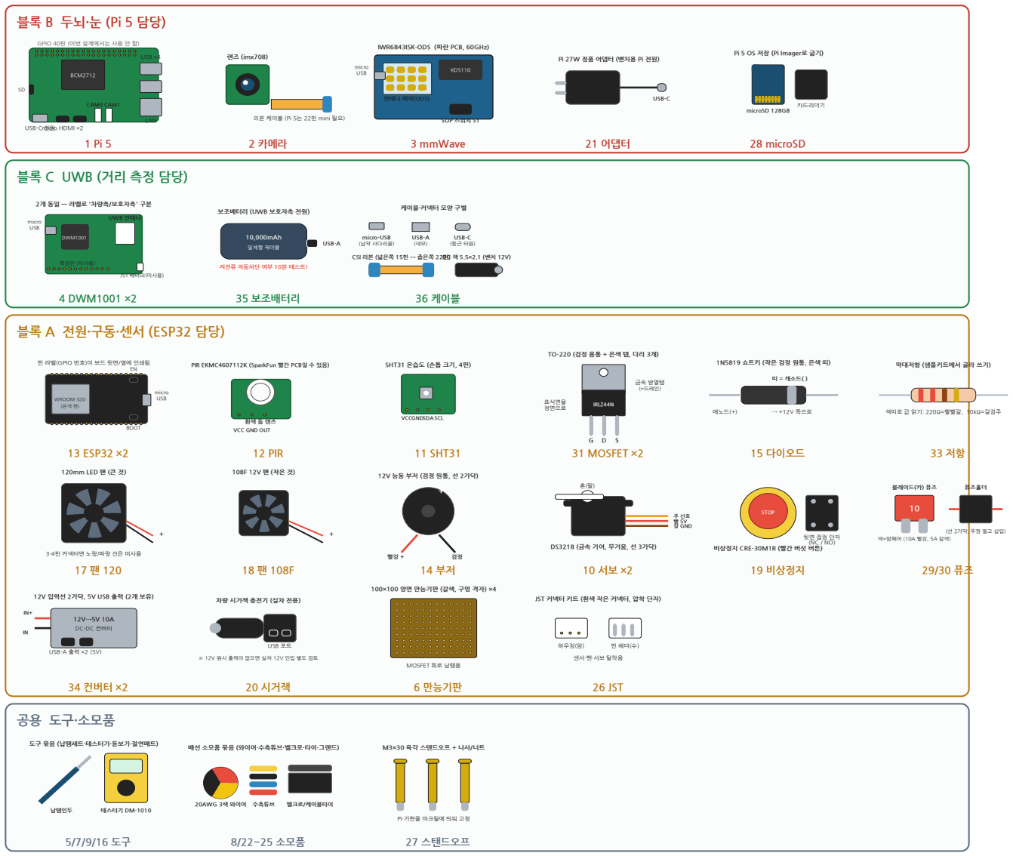
[picture p74: figure]
USB-C 전원 micro HDMI ×2; CAM0 CAM1; BCM2712; GPIO 40핀 (이번 설계에서는 사용 안 함); USB ×4; LAN; 리본 케이블 (Pi 5는 22핀 mini 필요); 렌즈 (imx708); 2 카메라; 안테나 패치(ODS); micro USB; SOP 스위치 S1; XDS110; IWR6843ISK-ODS (파란 PCB, 60GHz); 3 mmWave; USB-C; Pi 27W 정품 어댑터 (벤치용 Pi 전원); 21 어댑터; microSD 128GB; 카드리더기; Pi 5 OS 저장 (Pi Imager로 굽기); 28 microSD; 블록 C UWB (거리 측정 담당); DWM1001; UWB 안테나; 확장핀 (미사용); JST 배터리(미사용); 2개 동일 — 라벨로 '차량측/보호자측' 구분; 4 DWM1001 ×2; 10,000mAh; 일체형 케이블; USB-A; 보조배터리 (UWB 보호자측 전원); 저전류 자동차단 여부 10분 테스트!; 35 보조배터리; micro-USB (납작 사다리꼴); USB-A (네모); USB-C (둥근 타원); 케이블·커넥터 모양 구별; 36 케이블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

SafeGuard 부품 식별·배선 그림책 v1.0 | 팀 두고내리지말아조 | 2026-09-12 | 1

# SafeGuard 부품 식별·배선 그림책

## 36개 부품, 뭐가 뭔지 그림으로 찾기 — 연결 가이드 v1.0의 그림판

2026-09-12 | 팀 두고내리지말아조 | 블록 A(주황)=전원·구동·ESP32, B(빨강)=Pi·카메라·mmWave,

## C(초록)=UWB

### 쓰는 법: ① 상자를 열면 아래 지도와 대조해 부품을 블록별 상자(A/B/C/공용)로 나눈다. ② 다음 장의 부품 카드(생김새·핀·연결·주의)를 보고 라벨을 붙인다. ③ 마지막 배선 그림(A/B/C)을 보며 선을 잇는다. 그림은 사진이 아니라 특징을 강조한 도식이라 색·크기가 실물과 다를 수 있다. 헷갈리면 부품에 인쇄된 글자(IRLZ44N, 1N5819, DWM1001 등)를

먼저 읽는다.

<그림 0> 부품 지도 — 상자에서 꺼내며 이 그림 위에 놓아 보세요 (색 = 담당 블록)

CSI 리본 (넓은쪽 15핀 ↔ 좁은쪽 22핀) DC 잭 5.5×2.1 (벤치 12V)

PIR EKMC4607112K (SparkFun 빨간 PCB일 수 있음)

# 1. 부품 카드

각 카드: 번호(엑셀 No.) · 담당 블록 · 그림 · 생김새 · 핀/단자 · 연결 대상 · 주의. 카드를 잘라 부품 봉투에 붙여도 된다.

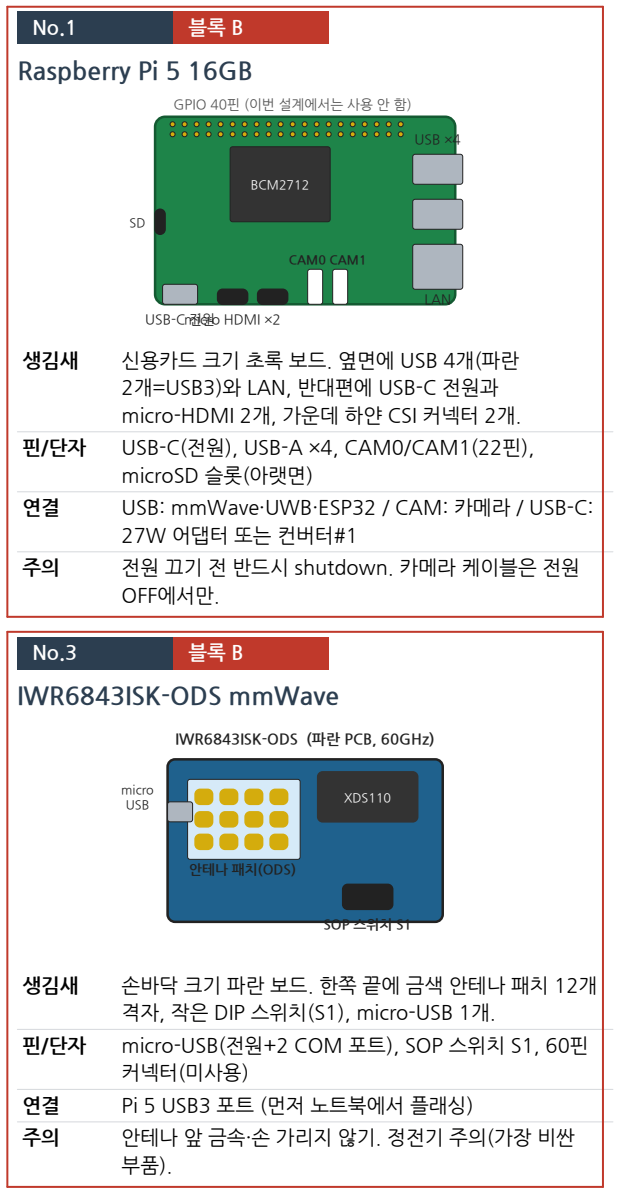
[picture p75: figure]
Raspberry Pi 5 16GB; USB-C 전원 micro HDMI ×2; CAM0 CAM1; BCM2712; GPIO 40핀 (이번 설계에서는 사용 안 함); USB ×4; LAN; 생김새; 신용카드 크기 초록 보드. 옆면에 USB 4개(파란; 2개=USB3)와 LAN, 반대편에 USB-C 전원과 micro-HDMI 2개, 가운데 하얀 CSI 커넥터 2개.; USB-C(전원), USB-A ×4, CAM0/CAM1(22핀),; microSD 슬롯(아랫면); 27W 어댑터 또는 컨버터#1; 전원 끄기 전 반드시 shutdown. 카메라 케이블은 전원; OFF에서만.; IWR6843ISK-ODS mmWave; 안테나 패치(ODS); micro USB; SOP 스위치 S1; XDS110; IWR6843ISK-ODS (파란 PCB, 60GHz); 손바닥 크기 파란 보드. 한쪽 끝에 금색 안테나 패치 12개; 격자, 작은 DIP 스위치(S1), micro-USB 1개.; 커넥터(미사용); Pi 5 USB3 포트 (먼저 노트북에서 플래싱); 안테나 앞 금속·손 가리지 않기. 정전기 주의(가장 비싼

연결 | USB: mmWave·UWB·ESP32 / CAM: 카메라 / USB-C:
No.2 | 블록 B

### Pi Camera Module 3

리본 케이블 (Pi 5는 22핀 mini 필요)

렌즈 (imx708)

생김새 | 2.5cm 정사각 초록 보드에 검은 렌즈. 주황색 얇은 리본 케이블 동봉(15핀, Pi 4용).
핀/단자 | 리본 케이블 커넥터 1개
연결 | Pi 5 CAM1 (22핀 mini 케이블 필요 → 추가 구매)
주의 | 렌즈 보호필름 제거. 리본 접점면 방향 주의.

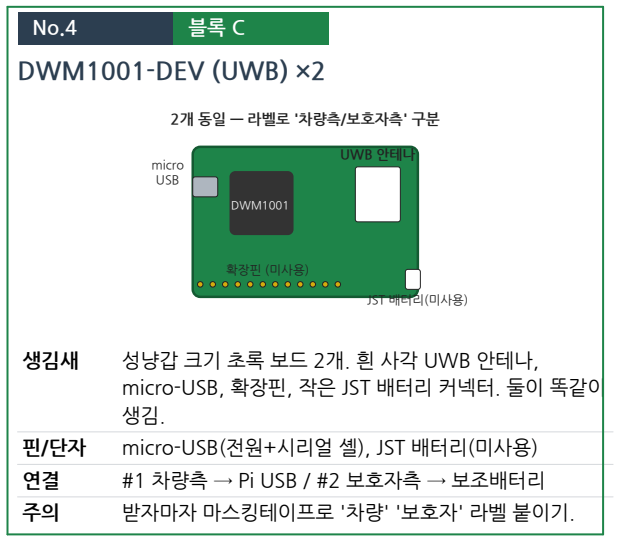
[picture p76: figure]
DWM1001-DEV (UWB) ×2; micro USB; DWM1001; UWB 안테나; 확장핀 (미사용); JST 배터리(미사용); 2개 동일 — 라벨로 '차량측/보호자측' 구분; 생김새; 성냥갑 크기 초록 보드 2개. 흰 사각 UWB 안테나,; micro-USB, 확장핀, 작은 JST 배터리 커넥터. 둘이 똑같이 생김.; micro-USB(전원+시리얼 셸), JST 배터리(미사용); #1 차량측 → Pi USB / #2 보호자측 → 보조배터리; 받자마자 마스킹테이프로 '차량' '보호자' 라벨 붙이기.

핀/단자 | micro-USB(전원+2 COM 포트), SOP 스위치 S1, 60핀

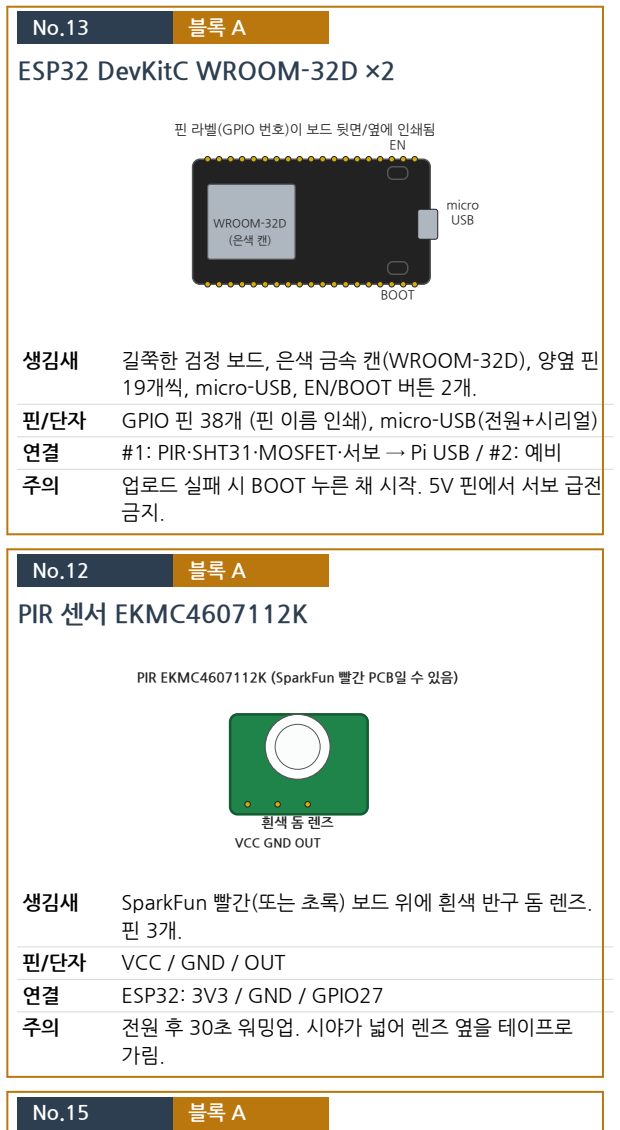
[picture p77: figure]
ESP32 DevKitC WROOM-32D ×2; WROOM-32D; micro USB; BOOT; 핀 라벨(GPIO 번호)이 보드 뒷면/옆에 인쇄됨; 생김새; 길쭉한 검정 보드, 은색 금속 캔(WROOM-32D), 양옆 핀; 19개씩, micro-USB, EN/BOOT 버튼 2개.; 업로드 실패 시 BOOT 누른 채 시작. 5V 핀에서 서보 급전; PIR 센서 EKMC4607112K; VCC GND OUT; VCC / GND / OUT; ESP32: 3V3 / GND / GPIO27; 전원 후 30초 워밍업. 시야가 넓어 렌즈 옆을 테이프로

핀/단자 | GPIO 핀 38개 (핀 이름 인쇄), micro-USB(전원+시리얼)
연결 | #1: PIR·SHT31·MOSFET·서보 → Pi USB / #2: 예비
No.11 | 블록 A

### SHT31 온습도 센서

VCCGNDSDA SCL

SHT31 온습도 (손톱 크기, 4핀)

생김새 | 손톱 크기 초록 보드, 가운데 은색 작은 사각 칩(구멍 있음), 핀 4개.
핀/단자 | VCC / GND / SDA / SCL (보드 실크 인쇄)
연결 | ESP32: 3V3 / GND / GPIO21 / GPIO22
주의 | 3.3V 급전. 핀 헤더 납땜 필요할 수 있음.

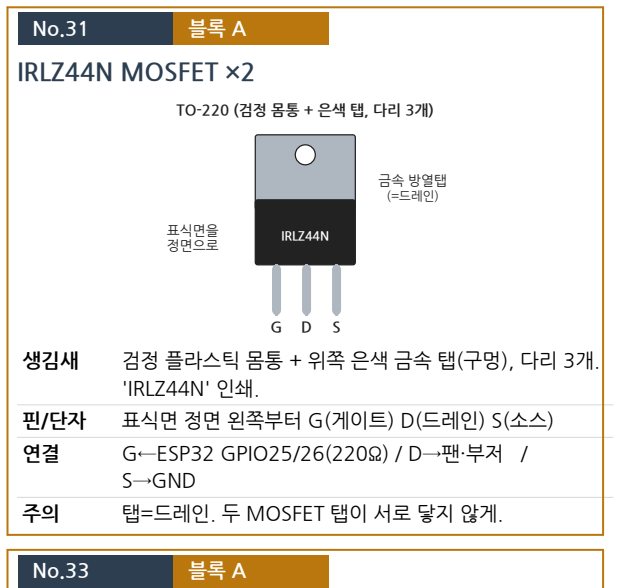
[picture p78: figure]
IRLZ44N MOSFET ×2; IRLZ44N; 금속 방열탭 (=드레인); 표식면을 정면으로; 생김새; 검정 플라스틱 몸통 + 위쪽 은색 금속 탭(구멍), 다리 3개.; 'IRLZ44N' 인쇄.; 표식면 정면 왼쪽부터 G(게이트) D(드레인) S(소스); G←ESP32 GPIO25/26(220Ω) / D→팬·부저  /; S→GND; 탭=드레인. 두 MOSFET 탭이 서로 닿지 않게.

PIR EKMC4607112K (SparkFun 빨간 PCB일 수 있음)

생김새 SparkFun 빨간(또는 초록) 보드 위에 흰색 반구 돔 렌즈.

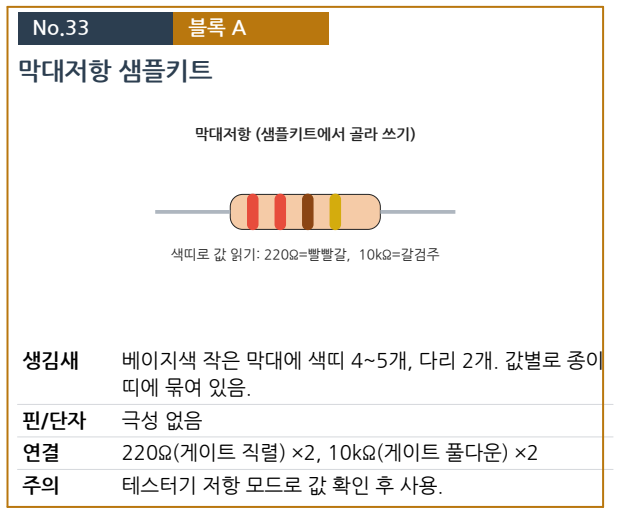
[picture p79: figure]
막대저항 샘플키트; 색띠로 값 읽기: 220Ω=빨빨갈, 10kΩ=갈검주; 막대저항 (샘플키트에서 골라 쓰기); 생김새; 베이지색 작은 막대에 색띠 4~5개, 다리 2개. 값별로 종이; 220Ω(게이트 직렬) ×2, 10kΩ(게이트 풀다운) ×2; 테스터기 저항 모드로 값 확인 후 사용.

### 1N5819 쇼트키 다이오드 ×5

띠 = 캐소드()

애노드(+) | → +12V 쪽으로

1N5819 쇼트키 (작은 검정 원통, 은색 띠)

생김새 | 쌀알보다 조금 큰 검정 원통, 한쪽 끝 은색 띠, 다리 2개.
핀/단자 | 띠 쪽 = 캐소드(), 반대 = 애노드(+)
연결 | 팬·부저 양단에 병렬, 띠가 +12V 쪽
주의 | 거꾸로 달면 전원 넣는 순간 퓨즈 단선.

No.14 | 블록 A

### 12V 능동 부저 ×2

+

빨강 + | 검정

12V 능동 부저 (검정 원통, 선 2가닥)

생김새 | 검정 원통(동전 크기), 윗면 구멍, 선 2가닥(빨강 +, 검정 ). '+' 표시 있음.
핀/단자 | 빨강 + / 검정
연결 | + → 12V 구동 레일 / → Q2 드레인
주의 | 능동형이라 전원만 주면 '삐' 남. 극성 지키기.
No.18 | 블록 A

### DC팬 108F 12V

+

108F 12V 팬 (작은 것)

생김새 | 작은 검정 사각 팬, 선 2가닥.
핀/단자 | 빨강 + / 검정
연결 | 120mm 팬과 병렬 → Q1
주의 | 회전 방향(바람) 확인 후 장착.

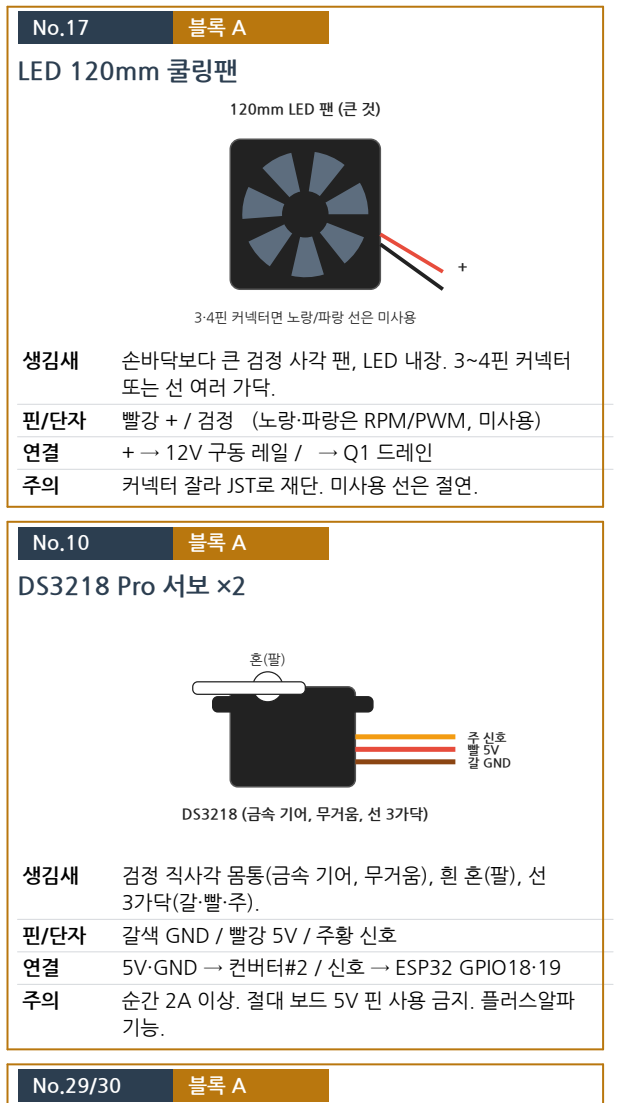
[picture p80: figure]
LED 120mm 쿨링팬; 120mm LED 팬 (큰 것); 3·4핀 커넥터면 노랑/파랑 선은 미사용; 생김새; 손바닥보다 큰 검정 사각 팬, LED 내장. 3~4핀 커넥터; 빨강 + / 검정  (노랑·파랑은 RPM/PWM, 미사용); + → 12V 구동 레일 /  → Q1 드레인; 커넥터 잘라 JST로 재단. 미사용 선은 절연.; DS3218 Pro 서보 ×2; 갈 GND; DS3218 (금속 기어, 무거움, 선 3가닥); 검정 직사각 몸통(금속 기어, 무거움), 흰 혼(팔), 선; 갈색 GND / 빨강 5V / 주황 신호; 순간 2A 이상. 절대 보드 5V 핀 사용 금지. 플러스알파

연결 | 5V·GND → 컨버터#2 / 신호 → ESP32 GPIO18·19

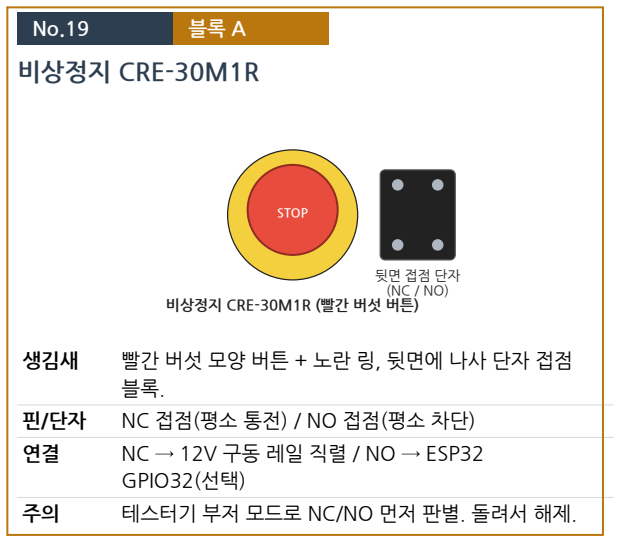
[picture p81: figure]
비상정지 CRE-30M1R; STOP; 뒷면 접점 단자 (NC / NO) 비상정지 CRE-30M1R (빨간 버섯 버튼); 생김새; 빨간 버섯 모양 버튼 + 노란 링, 뒷면에 나사 단자 접점; NC → 12V 구동 레일 직렬 / NO → ESP32; GPIO32(선택); 테스터기 부저 모드로 NC/NO 먼저 판별. 돌려서 해제.
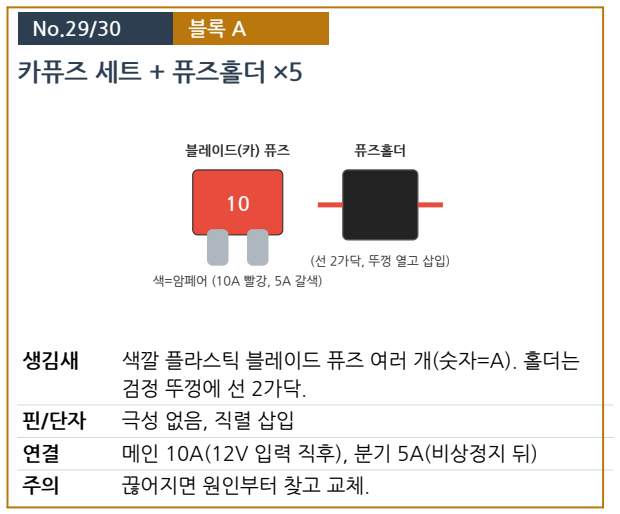
[picture p82: figure]
카퓨즈 세트 + 퓨즈홀더 ×5; 블레이드(카) 퓨즈; 색=암페어 (10A 빨강, 5A 갈색); 퓨즈홀더; 생김새; 색깔 플라스틱 블레이드 퓨즈 여러 개(숫자=A). 홀더는; 검정 뚜껑에 선 2가닥.; 메인 10A(12V 입력 직후), 분기 5A(비상정지 뒤); 끊어지면 원인부터 찾고 교체.

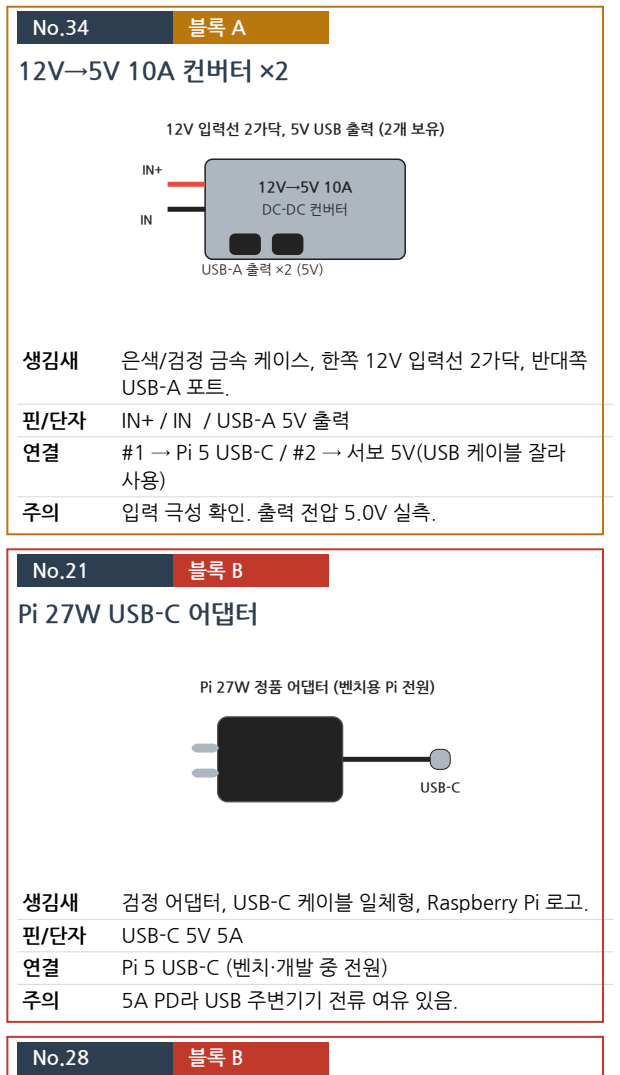
[picture p83: figure]
12V→5V 10A 컨버터 ×2; DC-DC 컨버터; USB-A 출력 ×2 (5V); 12V 입력선 2가닥, 5V USB 출력 (2개 보유); 생김새; 은색/검정 금속 케이스, 한쪽 12V 입력선 2가닥, 반대쪽; USB-A 포트.; IN+ / IN / USB-A 5V 출력; Pi 27W USB-C 어댑터; USB-C; Pi 27W 정품 어댑터 (벤치용 Pi 전원); USB-C 5V 5A; Pi 5 USB-C (벤치·개발 중 전원); 5A PD라 USB 주변기기 전류 여유 있음.

연결 | #1 → Pi 5 USB-C / #2 → 서보 5V(USB 케이블 잘라
No.20 | 블록 A

### 차량 시거잭 충전기

USB 포트

차량 시거잭 충전기 (실차 전용)

※ 12V 원시 출력이 없으면 실차 12V 인입 별도 검토

생김새 | 차량 시거 소켓에 꽂는 원통 플러그 + USB 포트.
핀/단자 | USB 출력
연결 | 실차 테스트 시 Pi 보조 전원
주의 | 12V 원시 출력이 없으면 12V 인입은 별도 검토(벤치는 12V 어댑터).
생김새 | 검정 어댑터, USB-C 케이블 일체형, Raspberry Pi 로고.
No.35 | 블록 C

### 보조배터리 10,000mAh

10,000mAh

일체형 케이블

USB-A

보조배터리 (UWB 보호자측 전원)

저전류 자동차단 여부 10분 테스트!

생김새 | 손바닥 크기 납작 배터리, 케이블 일체형, USB-A 포트.
핀/단자 | USB-A 출력
연결 | UWB 보호자측 노드 전원
주의 | 저전류 자동차단 → 10분 켜짐 테스트 필수.

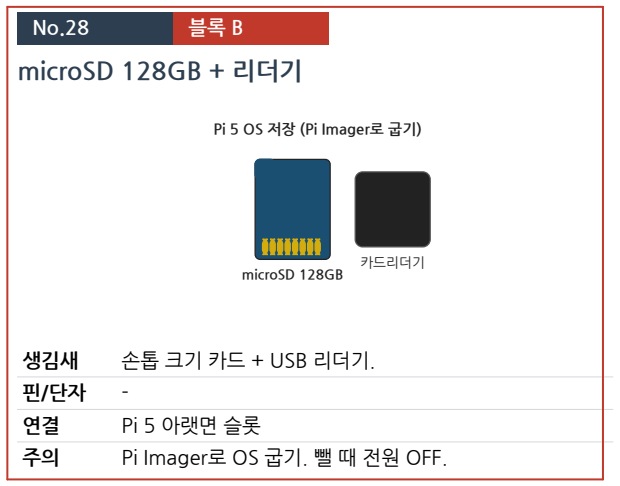
[picture p84: figure]
microSD 128GB + 리더기; microSD 128GB; 카드리더기; Pi 5 OS 저장 (Pi Imager로 굽기); 생김새; 손톱 크기 카드 + USB 리더기.; Pi 5 아랫면 슬롯; Pi Imager로 OS 굽기. 뺄 때 전원 OFF.

No.6 | 블록 A

### 양면 만능기판 ×4

| 100×100 양면 만능기판 (갈색, 구멍 격자) ×4

MOSFET 회로 납땜용

생김새 | 10×10cm 갈색/초록 판에 구멍 격자, 양면 동박.
핀/단자 | -
연결 | MOSFET·저항·다이오드·JST 납땜
주의 | 브레드보드 검증 후에만 납땜.

No.26 | 블록 A

### JST 커넥터 키트

하우징(암) | 핀 헤더(수)

JST 커넥터 키트 (흰색 작은 커넥터, 압착 단자)

센서·팬·서보 탈착용

생김새 | 흰색 작은 플라스틱 커넥터 암/수 + 압착 핀 여러 개.
핀/단자 | 2·3·4핀
연결 | 센서·팬·서보·12V 인입 탈착부
주의 | 압착기가 없으면 납땜 후 수축튜브.
No.27 | 블록 B

### M3×30 스탠드오프 키트

M3×30 육각 스탠드오프 + 나사/너트

Pi·기판을 아크릴에 띄워 고정

생김새 | 금색 육각 기둥 + 나사·너트.
핀/단자 | -
연결 | Pi·기판·카메라 고정
주의 | -

No.8/22/23/
24/25 | 블록 A/통합

### 배선 소모품 묶음

20AWG 3색 와이어 수축튜브 벨크로/케이블타이

배선 소모품 묶음 (와이어·수축튜브·벨크로·타이·그랜드)

생김새 | 3색 실리콘 와이어(빨·검·노), 수축튜브 색색 세트, 검정 벨크로(듀얼락), 벨크로 케이블타이, 케이블 그랜드(검정 너트형).
핀/단자 | -
No.5/7/9/16 | 블록 공용

### 도구 묶음

납땜인두 | 테스터기 DM-1010

도구 묶음 (납땜세트·테스터기·돋보기·절연매트)

생김새 | 납땜인두 세트, 노란 디지털 테스터기 DM-1010, LED 돋보기 스탠드, 실리콘 절연매트.
핀/단자 | -
연결 | 블록 A 작업대
주의 | 테스터기 10A 전류 단자는 직렬로만.

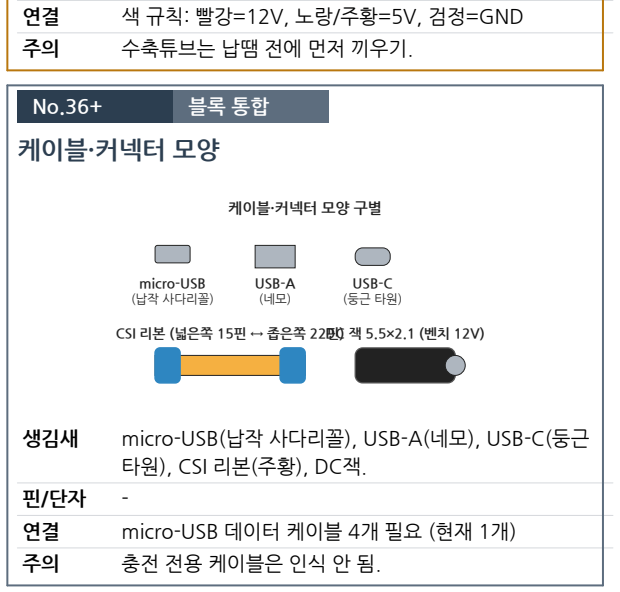
[picture p85: figure]
색 규칙: 빨강=12V, 노랑/주황=5V, 검정=GND; 수축튜브는 납땜 전에 먼저 끼우기.; 케이블·커넥터 모양; micro-USB (납작 사다리꼴); USB-A (네모); USB-C (둥근 타원); 케이블·커넥터 모양 구별; 생김새; micro-USB(납작 사다리꼴), USB-A(네모), USB-C(둥근; 타원), CSI 리본(주황), DC잭.; micro-USB 데이터 케이블 4개 필요 (현재 1개); 충전 전용 케이블은 인식 안 됨.

CSI 리본 (넓은쪽 15핀 ↔ 좁은쪽 22핀) DC 잭 5.5×2.1 (벤치 12V)

# 2. 배선 그림

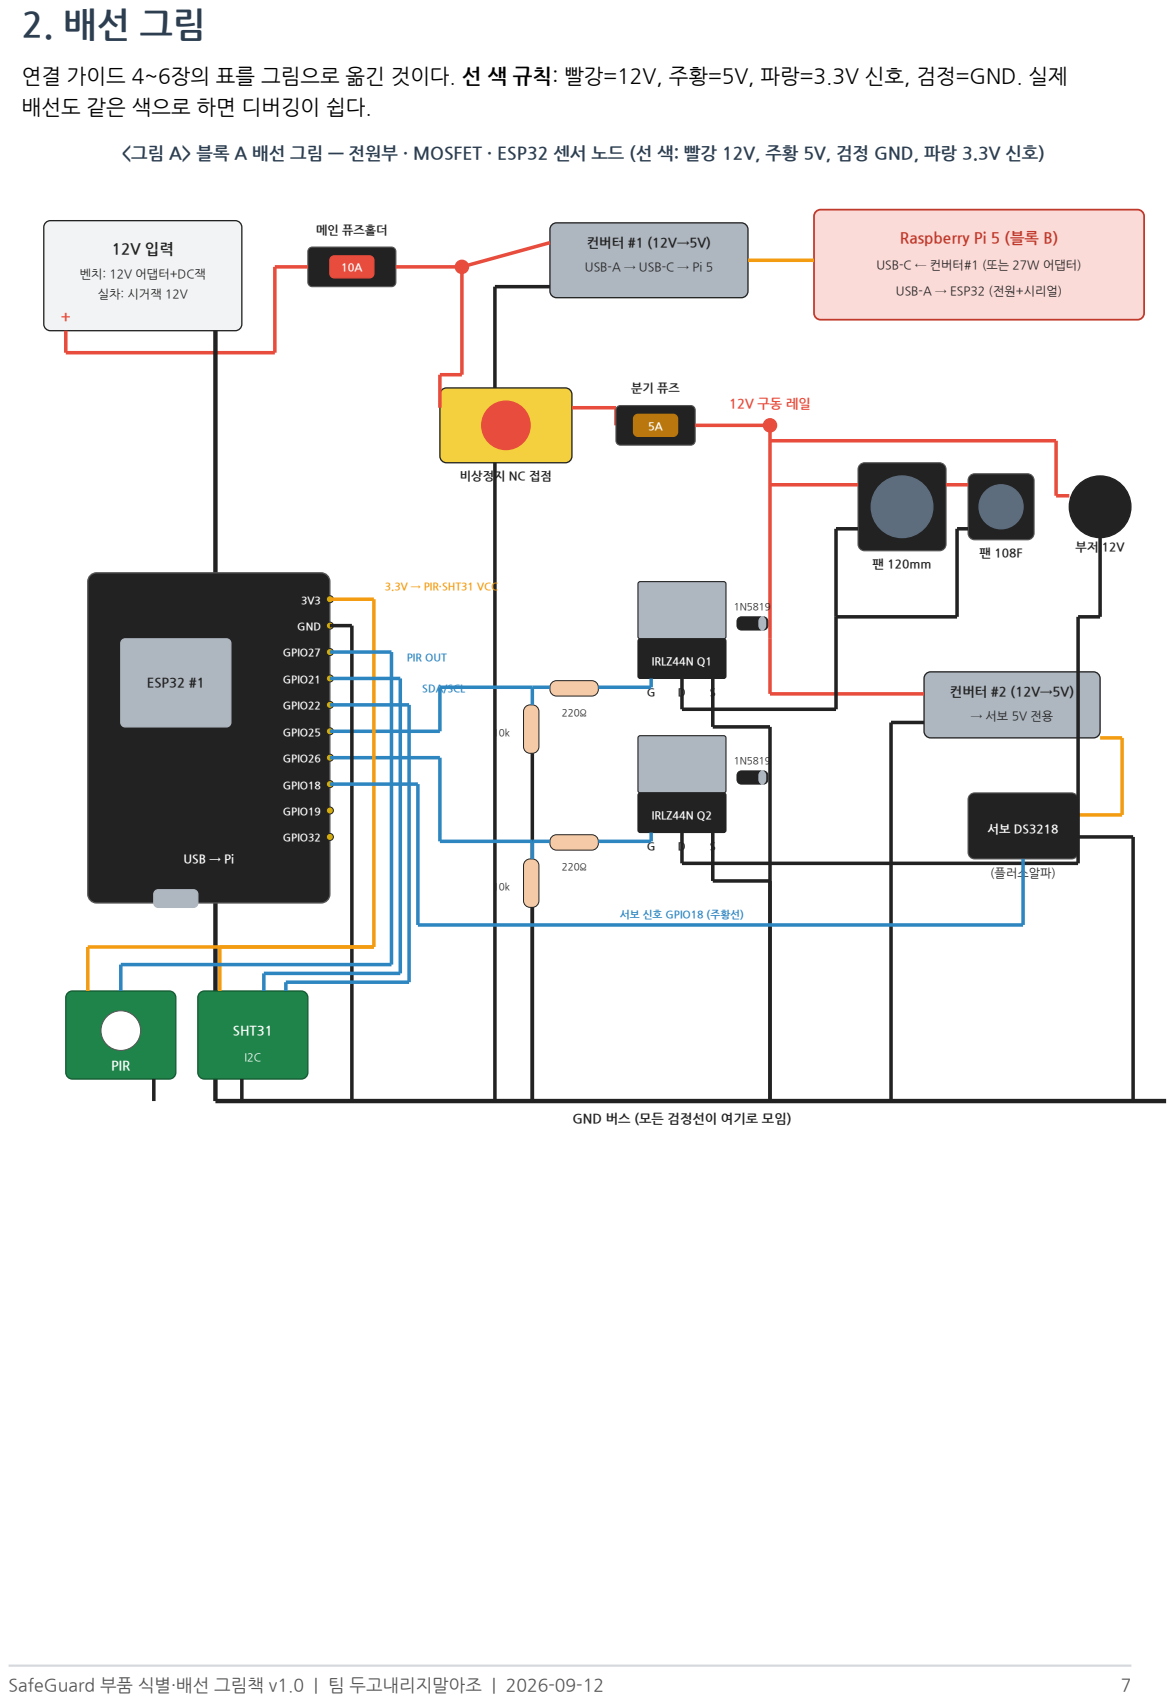
[picture p86: page 7]
메인 퓨즈홀더; 컨버터 #1 (12V→5V); 컨버터 #2 (12V→5V); (플러스알파); IRLZ44N Q1; IRLZ44N Q2; ESP32 #1; USB → Pi; GND; GPIO27; GPIO21; GPIO22; GPIO25; GPIO26; GPIO18; GPIO19; GPIO32; PIR; SHT31; 3.3V → PIR·SHT31 VCC; PIR OUT; SDA/SCL

연결 가이드 4~6장의 표를 그림으로 옮긴 것이다. 선 색 규칙: 빨강=12V, 주황=5V, 파랑=3.3V 신호, 검정=GND. 실제
배선도 같은 색으로 하면 디버깅이 쉽다.

<그림 A> 블록 A 배선 그림 — 전원부 · MOSFET · ESP32 센서 노드 (선 색: 빨강 12V, 주황 5V, 검정 GND, 파랑 3.3V 신호)

Raspberry Pi 5 (블록 B)

USB-C ← 컨버터#1 (또는 27W 어댑터)

벤치: 12V 어댑터+DC잭
실차: 시거잭 12V

USB-A → USB-C → Pi 5

USB-A → ESP32 (전원+시리얼)

비상정지 NC 접점

서보 신호 GPIO18 (주황선)

GND 버스 (모든 검정선이 여기로 모임)

<그림 B> 블록 B 연결 그림 — Pi 5에 무엇을 어디에 꽂나

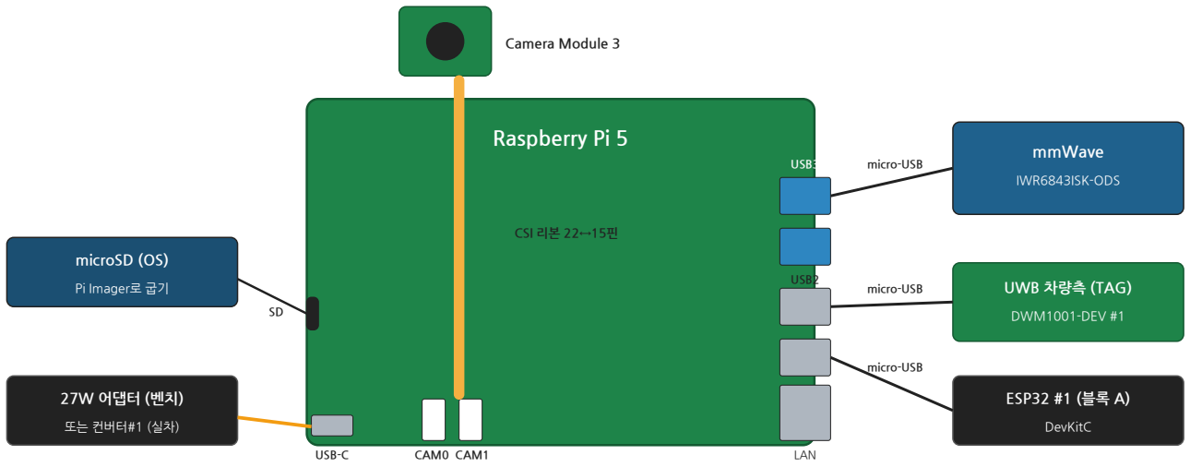
[picture p87: figure]
Raspberry Pi 5; USB3; USB2; USB-C; CAM0 CAM1; LAN; mmWave; IWR6843ISK-ODS; micro-USB; UWB 차량측 (TAG); DWM1001-DEV #1; ESP32 #1 (블록 A); DevKitC; Camera Module 3; CSI 리본 22↔15핀; 27W 어댑터 (벤치); 또는 컨버터#1 (실차); microSD (OS); Pi Imager로 굽기

USB 3개 + CSI 1개 + 전원 1개 = Pi에 꽂는 선은 총 5개

<그림 C> 블록 C — UWB 두 노드의 역할과 전원

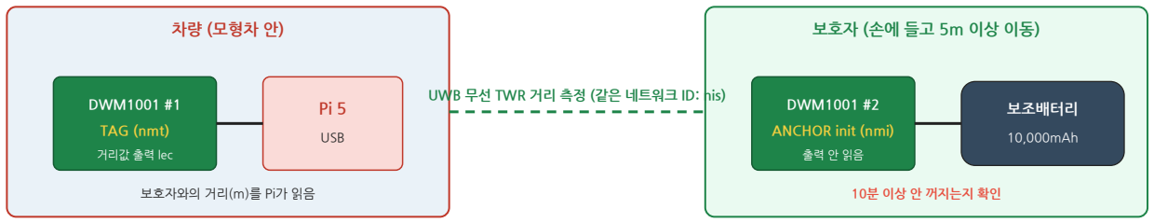
[picture p88: figure]
차량 (모형차 안); DWM1001 #1; TAG (nmt); 거리값 출력 lec; USB; 보호자와의 거리(m)를 Pi가 읽음; 보호자 (손에 들고 5m 이상 이동); DWM1001 #2; ANCHOR init (nmi); 보조배터리; 10,000mAh; 10분 이상 안 꺼지는지 확인; UWB 무선 TWR 거리 측정 (같은 네트워크 ID: nis)

두 보드는 똑같이 생겼으니 반드시 라벨을 붙인다. 설정 명령: nmt(태그) / nmi(앵커 initiator) / nis 0x1234 / lec

## 배선 전 5초 체크

### - 12V(빨강)가 ESP32·Pi·센서의 어떤 핀에도 닿지 않는가?

### - GND(검정)가 12V 전원, 컨버터 2개, ESP32, MOSFET 소스, 서보에 모두 연결되어 하나로 묶였는가?

### - 다이오드 띠(은색)가 +12V 쪽을 향하는가? MOSFET 표식면 기준 G-D-S 순서가 맞는가?

### - 서보 빨간선이 ESP32 5V가 아니라 컨버터#2에서 오는가?

### - 비상정지를 누른 상태에서 전원을 넣는가?

참고 상세 절차·명령·완료 조건 표는 SafeGuard_하드웨어_연결_가이드_v1.0.pdf를 함께 본다. 이 그림책은 '뭐가 뭔지'와 '어디에 꽂는지'만 담았다.
