SafeGuard-EWHA/2026ESWContest_mobility_DugoNaerijiMarajo/docs/figures/paper/fig4_multimodal.pdf

Empty
(truth: empty)

Seated, still
(truth: occupied)

After exit
(truth: empty)

Re-seated
(truth: occupied)

0

20

40

60

80

100
Seconds flagged occupied (%)

0

| | 20
12 | 0 | 0

0

100 | 100 | 100

0

100 | 100 | 100

0

100

100

Camera (motion) | Radar (tracker) | Camera OR radar | Radar + point support

Fig. 4 Per-second occupancy flag in test 3 (one subject, one trial). Higher is better for occupied phases, lower is better for empty phases. Point support (offline): a track counts only if 3 radar points fall within 0.45 m of it in the last 0.5 s a post-hoc check, not deployed.
