SafeGuard-EWHA/2026ESWContest_mobility_DugoNaerijiMarajo/docs/figures/paper/fig5_sensor_timing.pdf

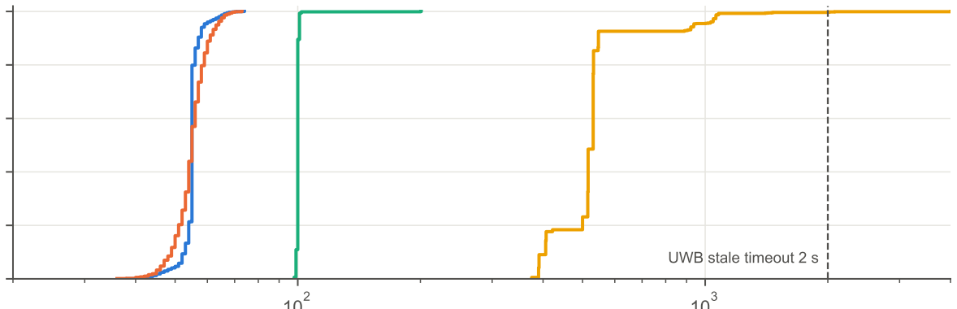
[picture p108: figure]
UWB stale timeout 2 s

10

10

### Inter-arrival time (ms, log)

0.0

0.2

0.4

0.6

0.8

1.0

### Cumulative fraction

Radar, test 3 (8,363 fr): median 55 ms, p99 66 ms Radar, 60 s run (1,091 fr): median 55 ms, p99 67 ms

Camera, test 3 (4,594 fr): median 100 ms, p99 101 ms UWB, session 1 (1,106): median 531 ms, p99 1078 ms

Fig. 5 Inter-arrival ECDF on the Raspberry Pi 5 host. Radar frame loss: 0 of 8,363 and 0 of 1,091 (frame-number gaps).
