SafeGuard-EWHA/2026ESWContest_mobility_DugoNaerijiMarajo/hardware_log.csv

time_s | state | pir_val | temp_c | humidity | relay_fan | relay_led | relay_buzzer | relay_motor | cpu_temp_c | cpu_percent
0 | IDLE | 0 | 27.8 | 62.5 | 0 | 0 | 0 | 0 | 44.3 | 18.6
1 | IDLE | 0 | 28.0 | 61.2 | 0 | 0 | 0 | 0 | 44.8 | 3.1
2 | IDLE | 0 | 28.0 | 61.2 | 0 | 0 | 0 | 0 | 44.3 | 3.2
3 | IDLE | 0 | 28.0 | 61.3 | 0 | 0 | 0 | 0 | 44.8 | 2.8
4 | IDLE | 0 | 28.0 | 61.3 | 0 | 0 | 0 | 0 | 45.3 | 2.9
5 | IDLE | 0 | 28.0 | 61.2 | 0 | 0 | 0 | 0 | 45.3 | 3.2
6 | IDLE | 0 | 28.0 | 61.2 | 0 | 0 | 0 | 0 | 45.3 | 2.9
7 | IDLE | 0 | 28.0 | 61.2 | 0 | 0 | 0 | 0 | 45.8 | 2.9
8 | IDLE | 0 | 28.0 | 61.1 | 0 | 0 | 0 | 0 | 45.3 | 3.2
9 | IDLE | 0 | 28.0 | 61.2 | 0 | 0 | 0 | 0 | 44.3 | 2.7
10 | IDLE | 0 | 28.0 | 61.1 | 0 | 0 | 0 | 0 | 44.8 | 2.8
11 | IDLE | 0 | 28.1 | 61.1 | 0 | 0 | 0 | 0 | 44.8 | 3.1
12 | IDLE | 0 | 28.0 | 61.1 | 0 | 0 | 0 | 0 | 44.8 | 3.1
13 | IDLE | 0 | 28.0 | 61.1 | 0 | 0 | 0 | 0 | 45.8 | 3.3
14 | IDLE | 0 | 28.0 | 61.1 | 0 | 0 | 0 | 0 | 45.3 | 3.1
15 | IDLE | 0 | 28.1 | 61.1 | 0 | 0 | 0 | 0 | 44.8 | 3.2
16 | IDLE | 0 | 28.1 | 61.1 | 0 | 0 | 0 | 0 | 45.3 | 3.1
17 | IDLE | 0 | 28.1 | 61.0 | 0 | 0 | 0 | 0 | 44.8 | 3.2
18 | IDLE | 0 | 28.1 | 61.1 | 0 | 0 | 0 | 0 | 45.8 | 3.1
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
