SafeGuard-EWHA/2026ESWContest_mobility_DugoNaerijiMarajo/hardware/mmwave/people_tracking/README.md

# hardware/mmwave/people_tracking — 3D People Tracking (차량 실내용 설정)

상태: **추정값 초안, 아직 실측·시험 안 함** (2026-10-23)

## 쓰는 TI 파일 (Radar Toolbox 4.00.00.05, `C:\ti\radar_toolbox_4_00_00_05`에 필요한 폴더만 풀어 둠)

| 용도 | 경로 (`...` = `source\ti\examples\Industrial_and_Personal_Electronics\People_Tracking\3D_People_Tracking`) |
|---|---|
| 펌웨어 | `...\prebuilt_binaries\3D_people_track_6843_demo.bin` |
| 원본 cfg | `...\chirp_configs\ODS_6m_staticRetention.cfg` (방 크기, 센서 2 m 높이) |
| 화면 | `tools\visualizers\Applications_Visualizer\Industrial_Visualizer\Industrial_Visualizer.exe` |
| 튜닝 근거 | `source\...\People_Tracking\docs\IWR6843_People_Tracking_PDFs\3D_people_tracking_{tracker,detection}_layer_tuning_guide.pdf` |

## 설정 파일 2개

둘 다 원본에서 **추적 계층만** 바꿨다 (전동차는 근거리 검출 1줄 추가). 원본과 diff로 확인했다.

| 명령 | 원본 (방) | `ODS_sedan_est.cfg` (파사트급 세단) | `ODS_rideon_est.cfg` (유아 전동차) |
|---|---|---|---|
| `sensorPosition` 높이·기울기 | 2 m, 15° | 1.2 m (룸미러 위 천장), 15° | 0.45 m (앞유리 덮개 아래), 20° |
| `boundaryBox` (추적 영역) | ±4, 0~8, 0~3 | ±0.8, 0.3~2.4, 0~1.3 | ±0.4, 0.15~0.95, 0~0.6 |
| `staticBoundaryBox` (정지 영역) | ±3, 0.5~7.5, 0~3 | ±0.65, 0.5~2.3, 0.2~1.2 (앞·뒷좌석) | ±0.3, 0.25~0.8, 0.05~0.5 (좌석) |
| `presenceBoundaryBox` | 방 전체 | 정지 영역과 같음 | 정지 영역과 같음 |
| `gatingParam` (한 대상 크기) | 3 2 2 3 4 | 3 1.0 1.0 1.5 2 | 3 0.5 0.5 0.5 2 (손·팔) |
| `stateParam` | …500 5 600 | …**3000** 5 **6000** | …**3000** 5 **6000** |
| `allocationParam` 최소 속도·점 | 0.1 m/s, 20개 | 0.05 m/s, 15개 | 0.05 m/s, 10개 |
| `trackingCfg` 최대 추적 | 30 | 5 | 3 |
| `dynamicRACfarCfg` 근거리 제외 | 4칸 (~34 cm) | 그대로 | 2칸 (~17 cm) |

좌표: 원점 = 센서 바로 아래 바닥, X 좌우, Y 센서 앞(뒷좌석 쪽) 거리, Z 높이, 단위 m.

**`stateParam`이 가장 중요한 변경이다.** 원본은 sleep2free 600프레임(55 ms × 600 ≈ 33초)이라, 움직임 없이 가만히 있는 사람을 **약 33초 뒤 지울 수 있다**. 잠든 아이를 놓치면 안 되므로 약 5.5분(6000, TI 가이드의 벽 장착 예시값)으로 늘렸다.

### 세단 추정 근거

2017~18 파사트 세단 실내 제원 (iSeeCars, 인치를 mm로 환산): 머리 공간 앞 ~973 / 뒤 ~960 mm, 어깨 폭 ~1,445 mm, 다리 공간 앞 ~1,077 / 뒤 ~993 mm.
여기서 방석 높이 ~0.3 m, 천장 ~1.25 m, 앞좌석 Y 0.5~1.2 m, 뒷좌석 Y 1.3~2.2 m로 추정했다. 15°는 센서(1.2 m)에서 뒷좌석 가슴(Y 1.8, Z 0.75)을 보는 각도(약 14°)다.
추정 오차를 생각해 상자를 넉넉하게 잡았다.

### 전동차 추정 근거

일반적인 2인승 SUV형 (약 120 × 70 × 60 cm)으로 가정했다. 좌석 Y 0.3~0.8 m, 폭 ±0.3 m, 방석 ~0.15 m, 덮개 ~0.5 m.

## ⚠️ 알아 둘 위험

1. **TI 권장과 다른 값이 있다.** 사용자 가이드는 정지 영역의 가까운 쪽(minY)을 2 m 이상으로 권장한다. 차 안에서는 불가능해서 낮췄다. 센서 근처의 정지 반사가 가짜 "정지한 사람"으로 남을 수 있으니 **빈 차 시험이 꼭 필요하다**.
2. **전동차는 TI 문서로 보장되지 않는 거리다.** 이 랩은 방에서 몇 m 거리의 사람을 추적하도록 만들어졌다. 50 cm 안팎의 손·팔에서 잘 안 되면 **Out-of-Box 데모 + 관심 영역 안의 점 개수**로 재실을 판단하는 방식으로 대체한다 (`../mmwave_reader.py` 확장).
3. **장착 방향이 기존 배치 계획과 다르다.** 하드웨어 가이드 7.1절은 "ODS 천장 중앙, 아래 향함"이다. 이 펌웨어는 측면 장착용이고, 천장용 랩(Overhead)은 2.8~3 m 높이가 필수라 차에 맞지 않는다. 그래서 두 cfg 모두 **앞쪽 위에서 뒷좌석을 비스듬히 보는 배치**를 가정했다. 앞좌석 등받이가 뒷좌석 시야를 일부 가릴 수 있다.
4. **인형으로는 안 잡힐 수 있다.** 움직이지도 숨 쉬지도 않는 인형은 정지 반사와 구별되지 않는다. 시연 대상은 실제 사람(손, 팔, 앉은 사람)으로.

## 나중에 기회가 생기면 줄자로 확인할 것

센서 높이, 센서~뒷좌석 방석 앞끝·등받이 거리, 좌석 폭, 방석 높이, 방석~천장 높이, 기울기 각도.
값이 바뀌면 각 cfg의 `[변경]` 줄 숫자만 고치면 된다.

## 정지 유지 시험 결과 (2026-10-24, 과방, Pi, 센서 약 1.2 m 높이, 의자 약 1.5 m 앞)

타임라인: 0~60초 모두 보드 뒤 → 약 60~78초 앉기 → 240초까지 가만히 → 240초 일어나 보드 뒤로 → 300초 종료.
두 시험 모두 5,455 프레임, 누락 0, 깨짐 0.

| 항목 | 시험 A: 원본 `ODS_6m_staticRetention.cfg`, **3명** | 시험 B: `ODS_sedan_est.cfg`, **1명** |
|---|---|---|
| 빈 자리 구간 | 추적 0명 (유령 없음) | 1,545 프레임 중 추적 0개 (유령 없음) |
| 가만히 있는 동안 추적 | 3명 70.4%, 2명 29.4%, 4명 0.2%, **0명 0%** | 1명 95.7%, 0명 4.3% (120~138초에 간헐적으로 끊김) |
| 추적·재실(1021) **둘 다 놓침** | 0% | **1.3%, 가장 긴 공백 1.3초** |
| 나간 뒤 사라지는 시간 | 약 5~10초 | 약 6초 (246초) |

- 원본 cfg가 정지한 사람을 약 33초 뒤 지울 것이라는 걱정은 **이번 조건에서는 일어나지 않았다**. 미세 움직임(호흡) 모드가 정지한 사람에게서도 점을 계속 만든 것으로 보인다.
- 메인 코드에서는 **추적 수 > 0 또는 재실 = 1**을 "있음"으로 보고, **몇 초(예: 5초) 계속 없을 때만 "없음"**으로 판단하면 시험 B의 최대 공백(1.3초)을 덮는다.
- 시험 B의 120초 끊김은 추측이다: 정지 영역 높이를 1.2 m(아이 기준)까지로 잡아서 앉은 성인의 머리가 영역 밖으로 나갔을 수 있다. 성인으로 시험할 때는 Z 최대를 1.5 m로 올려 비교.
### 시험 C: 원본 cfg + **1명** (시험 B와 같은 조건, 약 65초에 앉음)

| 항목 | 시험 C: 원본 cfg | 시험 B: 차량용 cfg |
|---|---|---|
| 정지 구간(85~240초) **정확히 1명** | **0%** (2명 61.5%, 3명 24.6%, 4명 1.0%, 5명 12.9%) | **95.7%** |
| 추적·재실 둘 다 놓침 | 0% | 1.3% (최대 1.3초) |
| 일어난 뒤 추적 0이 된 시각 | 272.9초 (**약 33초 뒤**) | 246.5초 (**약 6초 뒤**) |
| 나간 뒤(260~300초) 추적이 남은 프레임 | **32%** (유령) | 0% |
| 처음 빈 자리(30~60초) | 0명 | 0명 |

- 원본 cfg는 방 전체(앞 8 m, 좌우 ±4 m)를 보므로, 보드 앞 약 4 m의 벽(로그의 "가장 가까운 점 3.92~3.98 m")에서 생긴 **다중 반사가 유령 추적**이 되고, 정지 유지 설정 때문에 하차 후에도 약 30초 남았다.
- 차량용 cfg는 추적 영역을 앞 2.4 m, 좌우 ±0.8 m로 제한해 그 벽을 아예 보지 않는다 → 유령 없음. TI 튜닝 가이드 4.2절("boundaryBox로 벽 밖 다중반사 유령 제거")과 일치한다.
- 결론: **차 실내 크기로 영역을 맞추는 것이 정확도의 핵심**이다. 남은 약점(최대 1.3초 공백)은 메인 코드의 "5초 연속 없음일 때만 공석" 규칙으로 처리한다.

## 시험 순서 (보드를 고정한 뒤, 원본 cfg와 비교)

**대기 자리 주의 (10/24 관찰):** 보드 **바로 뒤나 옆뒤에 있어도 잡힐 수 있다.** 시야가 좌우·위아래 ±70°로 넓고(`fovCfg -1 70.0 70.0`),
안테나 뒤로 새는 약한 신호와 벽 반사가 있기 때문이다. 확실히 0명이 되려면 **보드의 대각선 뒤쪽으로 멀리** 가 있어야 했다.
실차에서도 앞좌석 사람이나 창밖 행인이 잡힐 수 있으므로 아래 5번(차 밖에서 움직이기)과 "앞좌석에만 사람" 시나리오를 꼭 넣는다.

| # | 상황 | 기대 |
|---|---|---|
| 1 | 빈 좌석 3분 | 추적 0개 (유령 없음) |
| 2 | 들어와 앉기 (전동차는 손 넣기) | 추적 1개 생김 |
| 3 | **가만히 3분** | **추적 유지** (원본 cfg는 약 33초 뒤 사라질 수 있음) |
| 4 | 나가기 (손 빼기) | 몇 초 안에 추적이 사라짐 |
| 5 | 차 밖에서 움직이기 | 추적 안 생김 |
