SafeGuard-EWHA/2026ESWContest_mobility_DugoNaerijiMarajo/prototype/SafeGuard_Main/docs/requirements_trace.md

# 요구사항과 구현 경계

기준 자료는 최신 컨설팅 피드백 이미지, 보완 설계 및 구현 실행 보고서 21쪽, 중간발표 자료 14쪽입니다. 최신 피드백의 변경 방향을 먼저 반영하고 보고서의 상세 조건을 유지합니다. 표의 ‘구현 대상/대응’은 설계와 프로그램의 대응 관계이며, 실물 검증 완료를 뜻하지 않습니다.

| 요구사항 | 자료 위치 | 구현 대상/대응 | 실물·성과 한계 |
|---|---|---|---|
| 본선 mmWave 핵심은 presence/미세 움직임 | 최신 피드백 보완 1 | mmWave health와 의미 있는 evidence를 구분 | 호흡은 선택, point cloud 수신만으로 확정 금지 |
| 정상 OR, 장애 AND | 보고서 8–9쪽, 발표 5쪽 | PRIMARY의 OR / FAIL_SAFE의 최근 유효 AND | 각 센서 실제 detector 검증 필요 |
| CONFIRMED/SUSPECTED/UNKNOWN 구분 | 보고서 8–9·12쪽 | occupant status 별도 기록 | UNKNOWN은 없음/안전/자동 보호 승인 아님 |
| 단일 FSM | 보고서 5·7쪽 | C++ 메인 한 곳에서 상태·보호 요청 결정 | Python 허브는 입력·통신 담당 |
| UWB 출력 계약 | 보고서 5·7·13쪽 | 기존 reader의 ID·거리·평활값·시각·유효성 활용 | 실물 C 동작과 새 전체 메인 검증은 별개 |
| 유효 거리 5m 초과 | 보고서 2·8·21쪽 | 연속 유지시간으로 DEPARTURE_CHECK | 정확히 5m는 초과가 아님 |
| 10초·MA7은 후보 | 보고서 3·21쪽 | REAL/하드웨어 DEMO 초기 10초, 기존 MA7 보존 | SIMULATION 1초는 가상 실행 속도용 |
| 복귀와 수동 해제 구분 | 보고서 8·12·21쪽 | 별도 복귀 거리·시간과 해제/재무장 요청 | 4m·3초 등은 이번 초기 구현 선택 |
| 데이터 유효시간 | 보고서 7·9·14쪽 | producer와 main의 신선도·통신 감시 | 오래된/무효 입력을 감지 1로 사용 금지 |
| UWB 중단은 복귀가 아님 | 보고서 12·19쪽 | 무효 거리·고장 표시, 0m 대체 금지 | 이미 진행 중인 보호를 자동 해제하지 않음 |
| mmWave 정상 미검출과 장애 구분 | 보고서 9·12쪽 | healthy negative와 timeout/fault 별도 처리 | TI 펌웨어에 맞는 실제 파서는 추가 연결 대상 |
| Pi 상시 ON, 처리 단계 활성화 | 보고서 10쪽, 발표 6쪽 | 상태별 처리 플래그 | 실제 전원 OFF나 측정된 절감으로 주장 금지 |
| RC/Euler와 35°C 도달시간 | 보고서 11쪽 | 단위·유효성·예측 범위 확인 | R/C/Q 보정 전 REAL 예측 기본 비활성 |
| 현재 온도 기준의 반응형 판단 | 보고서 11–12쪽 | 유효 보호 경로에서 현재 온도 >=35°C | 온도만으로 탑승 여부를 확정하지 않음 |
| API 실패 처리 | 보고서 11–12쪽 | 예측 유효성 해제/유효 실측 기반 반응 | 없는 외기 API를 연결 완료로 표시 금지 |
| DEMO/REAL 명확히 표시 | 최신 피드백 보완 3, 보고서 16쪽 | mode/profile과 입력별 source 구분 | DEMO 설정값을 실측 성과로 집계 금지 |
| 가상 입력과 실제 DEMO 분리 | 위 요구를 구체화한 구현 선택 | SIMULATION / HARDWARE_DEMO / REAL 설정 분리 | 일부 실제 UWB를 섞어도 합성 A/B는 실측 아님 |
| Fan/Buzzer 필수, Servo 선택 | 보고서 1·12·18쪽 | 핵심 출력 계약은 fan/buzzer | GPIO·정격·실제 출력은 A와 확인 |
| 명령 ID·ACK·재시도 | 보고서 7·12쪽 | 요청/응답 구분, 제한 재시도 | ACK는 회전·소리의 실제 관찰이 아님 |
| 비상정지 최우선 | 보고서 6·8·12쪽 | 소프트웨어 요청보다 ESTOP 우선 | 물리 구동 전원 차단은 하드웨어 확인 필요 |
| 수동 재무장 | 보고서 8쪽 | 스위치 복귀 뒤 rearm -> 재점검 | 스위치만 풀어 자동 재구동 금지 |
| 전력 계측 범위·일관된 계산 | 최신 피드백 보완 2, 보고서 10·15쪽 | 상태/시각 로그를 계측과 대응 | 전력·에너지 값은 계측 없으면 성과 미확인 |
| prototype 범위 | 보고서 2·15·19쪽 | 모형·무인 시험체 중심의 검증 | 실차 보호 효과·인증·의학적 안전 보장 아님 |

## 기존 자료와 현재 진척의 차이

- 발표 9–11쪽은 실제 선행 프로토타입 사진·DHT22/릴레이 로그와 시뮬레이터 결과를 포함합니다. 선행 작업의 근거로 보존하되 현재 ESP32/SHT31/MOSFET 및 UWB/mmWave 결합의 실행 증거로 바꾸지 않습니다.
- 발표 12쪽의 ‘B OS 이미징 중 / C 착수 예정’은 현재 대화에서 확인한 진척보다 오래됐습니다. 현재 B는 OS/SSH와 카메라 촬영, C는 실제 Pi 거리 출력·평균·통신 단절/복구가 확인됐습니다.
- 현재 A firmware와 실제 배선, B의 TI 펌웨어·cfg·원시 로그는 이 패키지의 실제 장치 계약 검증에 필요합니다. 미제공 부분은 자동 정상값으로 대체하지 않습니다.
- 최신 피드백은 호흡을 핵심 완료 조건에서 분리하고, presence/미세 움직임을 본선 필수 수준으로 제시했습니다. 전력 로거 구매도 기본 완료 조건이 아닙니다.

## 검증 표현

소프트웨어 테스트 통과는 파싱·시간 조건·상태전이·출력 계약에 대한 증거입니다. 이를 센서 검출률, 실제 팬 작동률, 전력 절감률로 확대하지 않습니다. 실제 시연 성공은 실제 감지 경로와 실제 Fan/Buzzer 동작까지 연결한 회차에서만 집계합니다. REPLAY와 합성 입력 회차는 별도 분류합니다.
