SafeGuard-EWHA/2026ESWContest_mobility_DugoNaerijiMarajo/prototype/docs/STATUS.md

# 현재 상태 — 2026-10-31 KST

## 코드·배포·실물 상태

| 구분 | 현재 확인 범위 |
|---|---|
| 소스 기준 | 10월 30일 직접 읽은 Pi 소스와 공개 저장소를 비교. GitHub에 있던 mmWave 대시보드 표시와 CTest 구성을 보존하여 병합 |
| 팀 Pi 배포 | `/home/pi/SafeGuard_Operational_20261031` 별도 폴더에 수정 소스·Linux 빌드 배치. 기존 Main·촬영본 보존 |
| 자동 실행 | navigation와 portal만 enabled/active. 실제 main 서비스는 미활성 |
| 현재 화면 | 접속 점검 모드. 실내온도 없음, 예측·출력 비활성, 서버도 제어 요청 거부 |
| 실제 연결 | Pi 정상 재부팅 후 웹 자동 시작. 휴대폰 위치 유효 및 위치 기반 기상 외기온 수신 확인 |
| 수신기 복구 | 위치 수신기 재시작 후 기존 인증 기억, 새 위치 수신, 유효 외기온 복구. portal 실행 유지 |
| 열 예측 코드 | 실내·외기 열수지 모델, 600초 이력·300초 예측, 기존 35°C 및 유효 ETA≤60초 정책 유지. 빌드·모의 시험 통과 |
| mmWave | 10월 31일 사용자 수리 완료 보고. 현재 새 운영 설정의 포트/검증 표시는 실물 연결 후 확인 필요 |
| ESP32 | 이번 작업에서는 연결하거나 펌웨어를 업로드하지 않음 |

## 근거를 구분할 것

접속·위치·날씨·재부팅 복구는 이번 Pi 작업에서 직접 확인했습니다. 새 열 모델의 시험은 가상 입력과 수학적 해석해 비교입니다. 기존 실내 시연·선제 보호 작동·촬영 성공 및 mmWave 수리 완료는 사용자 보고입니다. 이번 작업에서 센서·팬·부저·서보 실물 검증을 수행한 것으로 기록하지 않습니다.

현재 운영 입력은 실제 실내 센서와 위치 기반 기상 외기온을 사용하도록 구성했습니다. 촬영본의 고정 실내 28.5°C·외기 32°C는 별도로 보존합니다. 휴대폰 위치·날씨가 만료되면 최신 입력으로 사용하지 않습니다.

## 남은 일

1. ESP32·센서 연결, mmWave 입력 검증 및 포트 설정, 실제 출력 정지 피드백 확인.
2. 실제 제어 서비스 자동 시작과 부팅 직후 정지 유지 검증.
3. 600초 실제 실내·외기 이력, 선제 보호·직접 보호·수동 정지 및 화면/통신 장애 시험.
4. 차량별 온도 예측 정확도 측정. 문헌 시간상수를 차량 보정값으로 간주하지 않음.

[운영 순서](OPERATIONS.md) · [검증 기록](VALIDATION.md) · [열 모델](THERMAL_MODEL.md)

---

# 10월 28일 상태 기록 — 당시 확인 범위

## 이번 변경

**위험 기준 35°C / 서보 보호 각도 80° / 문헌·실측 추세 기반 열 예측 ON / 선제 보호 제어 ON**입니다. `thermal.predictive_control_enabled=true`, `protect_horizon_s=60`을 현재 기준 설정에 반영했습니다. 기존 RC 경로의 `thermal.enabled=false`, `calibrated=false`는 그대로이며 새 예측 제어 플래그와 다릅니다.

보호자 이탈·탑승 판단 등 기존 상태 기계 조건을 거쳐, 최신 온도 프레임에 대응하는 유효한 예측이 60초 이내 35°C 도달을 나타내면 실제 35°C 이전에도 PROTECTION으로 전환하여 팬·부저 및 기존 서보 80° 출력 경로를 요청합니다. 전체 정지·비상정지 우선순위와 실측 35°C 보호를 유지합니다. 예측 이력 준비는 600초, 표시 범위는 향후 300초입니다. “향후 5분”은 5분 후 반드시 35°C라는 뜻이 아닙니다.

## 확인된 근거

| 항목 | 확인 범위 |
|---|---|
| 현재 소스 | 선제 보호 패키지의 검증된 코드를 반영. GitHub 갱신은 Pi 자동 배포가 아님 |
| 소프트웨어 검증 | CMake Release, CTest 4개, 대시보드, 실제 main 출력 명령 경로, 설치·롤백 검증 통과. 상세는 아래 링크 |
| 예측 제어 시험 | 합성 상승 이력 600초에서 현재 34.5°C, 약 51초 후 35°C 예측 → Core PROTECTION 및 팬·부저 요청. 실제 출력 구성은 서보 80° 포함. 실제 장치 회전 시험과 구분 |
| 열 추정 화면 | 사용자 스크린샷에서 준비 후 평탄한 곡선과 “향후 5분 내 도달 추정 없음” 확인 |
| 후속 대시보드 | 사용자가 선제 보호 변경 후 대시보드까지 확인했다고 보고. 실제 선제 보호 출력 성공은 아직 보고되지 않음 |
| 펌웨어·정지 | 사용자 로그 FIRMWARE_OK 0.3.0, STOP_CONFIRMED_BY_CONTROLLER_REPORT |
| 이전 출력 시험 | 사용자가 팬 2개·부저 작동 및 전체 정지 후 꺼짐 확인. 서보 해결은 사용자 보고이며 팀원 수정 소스·배선 내역 미제공 |
| 백업 | 사용자가 SafeGuard_working_20261028_041601.tar.gz 12.1MB, gzip 검사 통과 확인. 35°C 복구 전 백업 |
| 측정자료 | 전달된 UWB·B블록 원본 및 분석 자료 88개, 재생성 가능한 그래프 3종 추가 |

## 남은 확인과 경계

- 실제 온도 35°C 이전에 예측 조건으로 보호 출력이 켜지고, 전체 정지로 꺼지는 통합 시험 결과는 아직 확보하지 못했습니다. 사용자의 “통합 실험은 된다고 치고”는 새 실측 증거로 기록하지 않습니다.
- 열 모델의 차량별 정확도는 미검증이며 겨울 외기는 원 연구 범위 밖입니다. 선제 보호 제어 구현 여부와 예측 정확도 검증 여부는 별개의 항목입니다.
- 카메라·mmWave 과거 측정자료가 존재해도 현재 통합 장치의 입력 정상 복구를 뜻하지 않습니다.
- Pi `/home/pi/safeguard_c` 전체, 최근 Pi 실행 로그 전체, 팀원 서보 수정 원본은 미수집입니다. 현재 저장소는 확인 가능한 자료의 기준본입니다.

[선제 보호 검증](../maintenance/SafeGuard_Predictive_Control_20261028/VALIDATION.md) · [측정자료/PPT 안내](../measurements/README.md) · [열 모델 방법](../maintenance/SafeGuard_Thermal_20261028/METHOD.md)
