SafeGuard-EWHA/2026ESWContest_mobility_DugoNaerijiMarajo/sample_data/sample_hardware_log_no_occupant.csv

time_s | state | pir_val | temp_c | humidity | relay_fan | relay_led | relay_buzzer | relay_motor | cpu_temp_c | cpu_percent
0.0 |  | 0 | 25.015235853987722 | 47.69920789262579 | 0 | 0 | 0 | 0 | 43.13403141381217 | 13.647965388637262
1.0 |  | 0 | 24.9513313517861 | 51.29574202054728 | 0 | 0 | 0 | 0 | 43.76431665628238 | 13.275364081048913
2.0 |  | 0 | 25.044178127681274 | 49.50721216531566 | 0 | 0 | 0 | 0 | 43.671953454008936 | 15.957751077040923
3.0 |  | 0 | 25.057003277434195 | 49.90801348125673 | 0 | 0 | 0 | 0 | 42.58541662504943 | 11.928715860147761
4.0 |  | 0 | 24.915737228057242 | 48.420652233944075 | 0 | 0 | 0 | 0 | 43.79898761345029 | 15.779383410640005
5.0 |  | 0 | 24.951488439379133 | 49.498315741466186 | 0 | 0 | 0 | 0 | 43.92734460470551 | 15.205106367452533
6.0 |  | 0 | 25.02629235266003 | 51.95006689204844 | 0 | 0 | 0 | 0 | 43.64555974305759 | 14.705115020163666
7.0 |  | 0 | 25.007385620385776 | 50.87398286298156 | 0 | 0 | 0 | 0 | 44.34896896745295 | 18.176552214298525
8.0 |  | 0 | 25.025649618510393 | 52.598467408114914 | 0 | 0 | 0 | 0 | 43.23663253883529 | 13.755585109410564
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
