SafeGuard-EWHA/2026ESWContest_mobility_DugoNaerijiMarajo/B회신2_20261027/4_photos/3_overview_board_chair_b.jpg

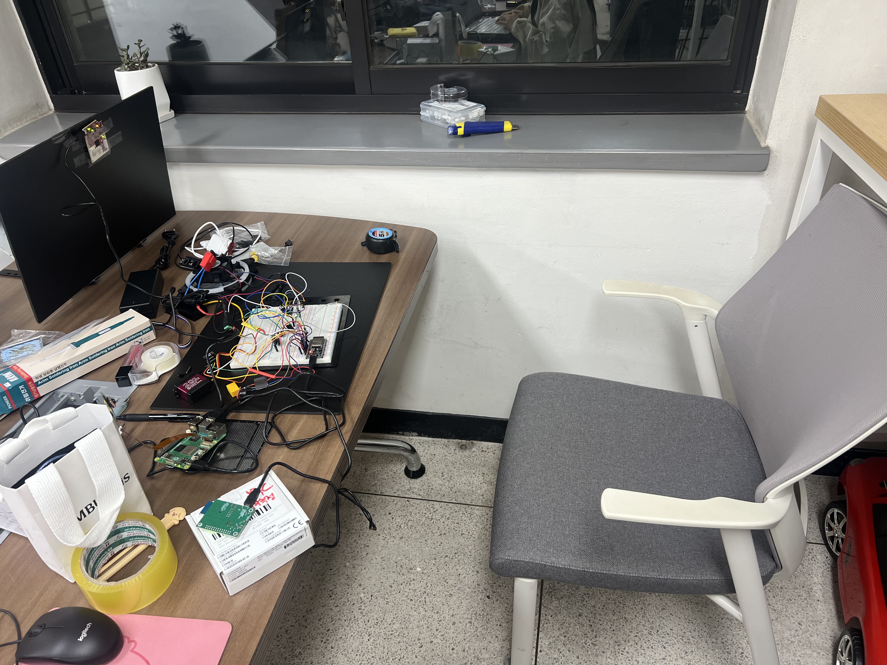
B회신2_20261027/4_photos/3_overview_board_chair_b.jpg
