SafeGuard-EWHA/2026ESWContest_mobility_DugoNaerijiMarajo/B회신2_20261027/5_camera/cam_light_snaps/motion_20261027_195645.jpg

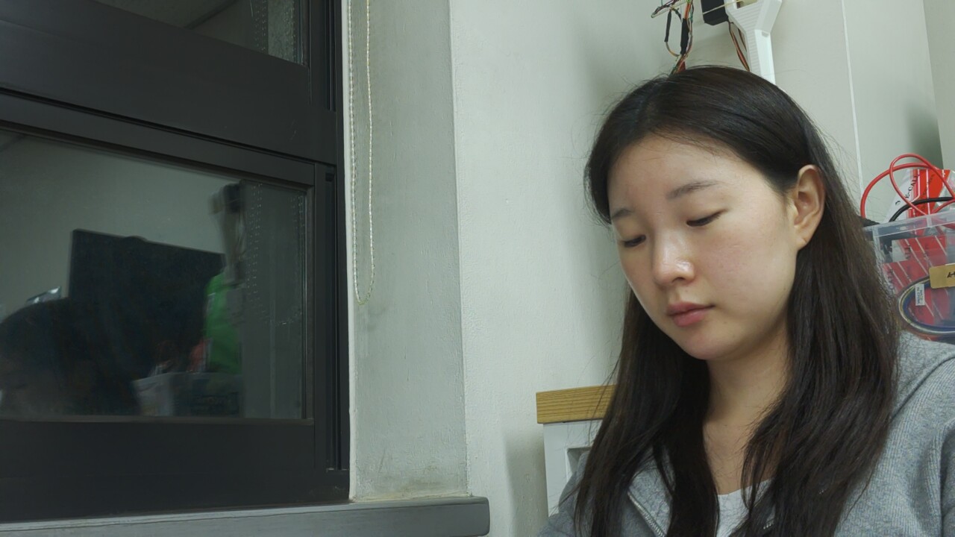
B회신2_20261027/5_camera/cam_light_snaps/motion_20261027_195645.jpg
