SafeGuard-EWHA/2026ESWContest_mobility_DugoNaerijiMarajo/B회신3_20261027/2_camera/cam_light_snaps/motion_20261027_195637.jpg

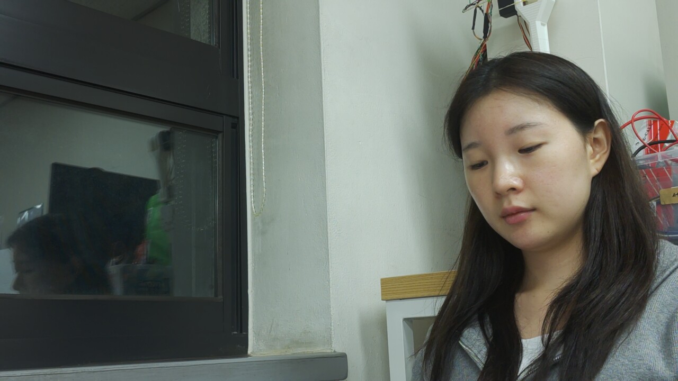
B회신3_20261027/2_camera/cam_light_snaps/motion_20261027_195637.jpg
