SafeGuard-EWHA/2026ESWContest_mobility_DugoNaerijiMarajo/B회신3_20261027/5_photos/1_side_tilt_a.jpg

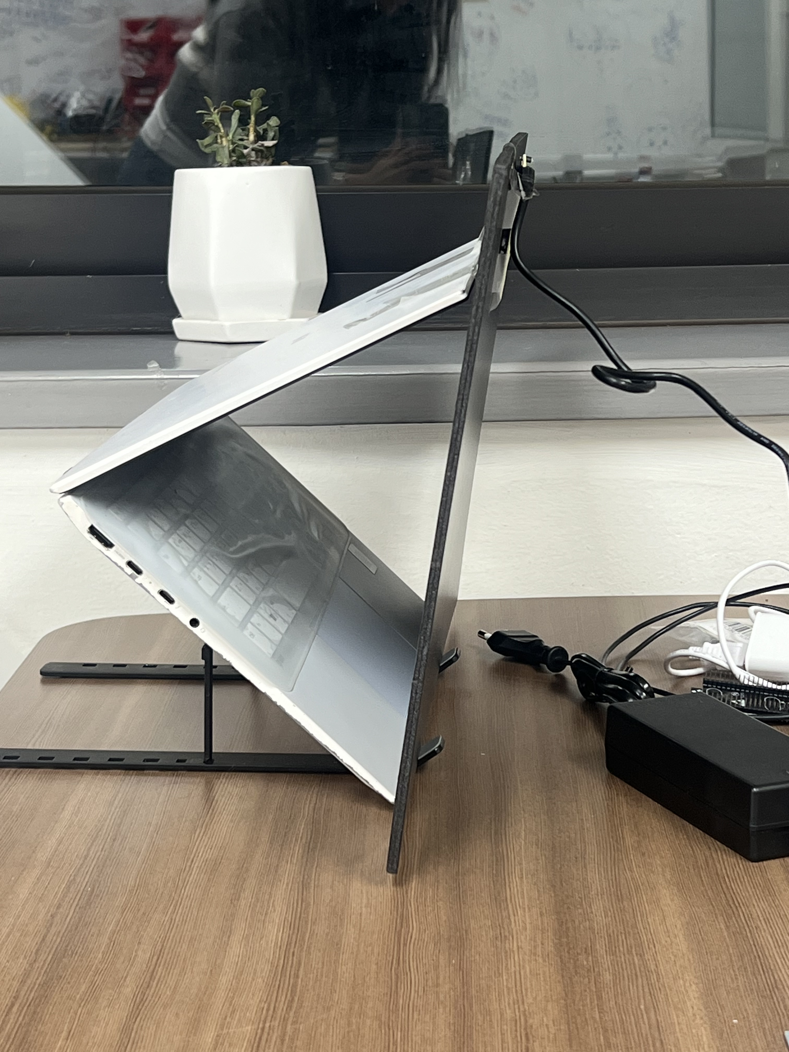
B회신3_20261027/5_photos/1_side_tilt_a.jpg
