SafeGuard-EWHA/2026ESWContest_mobility_DugoNaerijiMarajo/docs/figures/paper/fig7_thermal_literature.png

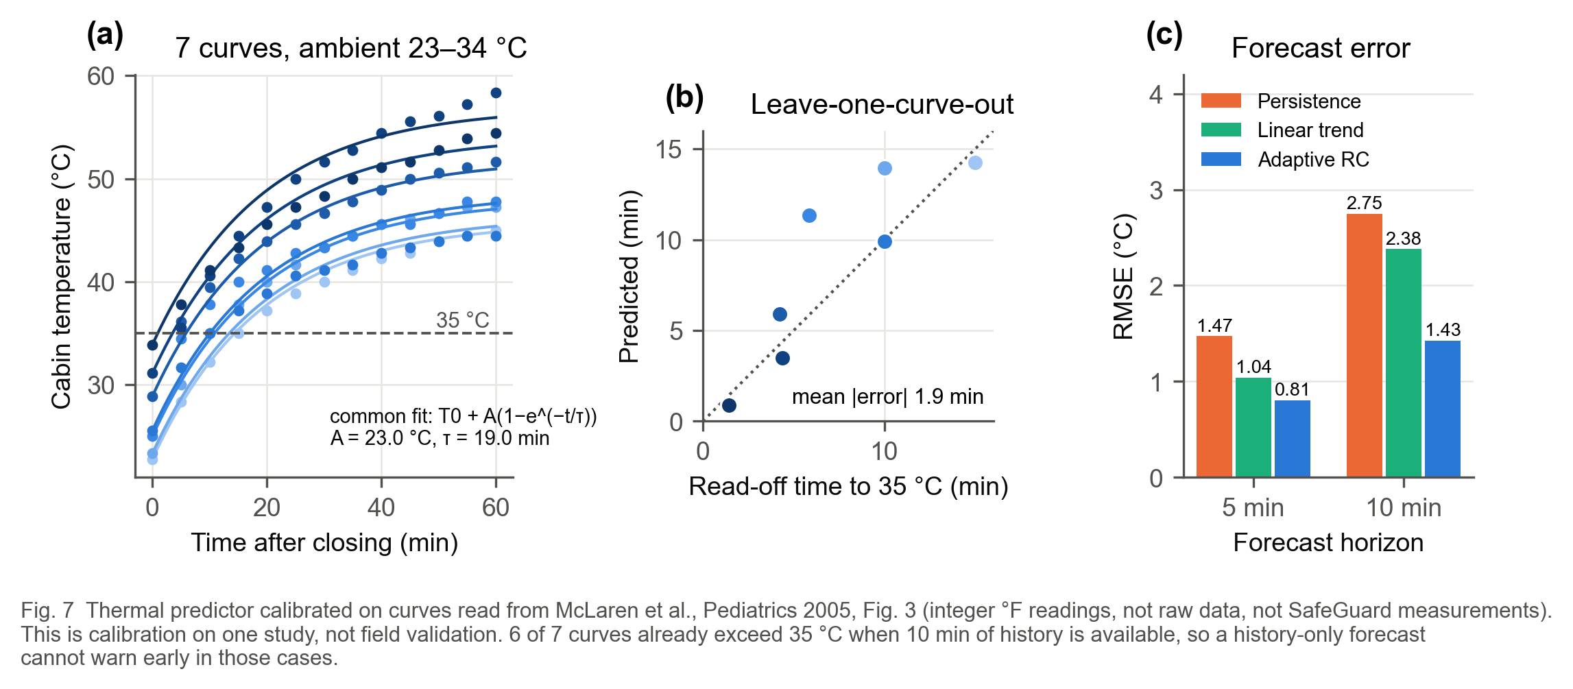
docs/figures/paper/fig7_thermal_literature.png
