SafeGuard-EWHA/2026ESWContest_mobility_DugoNaerijiMarajo/docs/presentation/img/docx/image1.jpeg

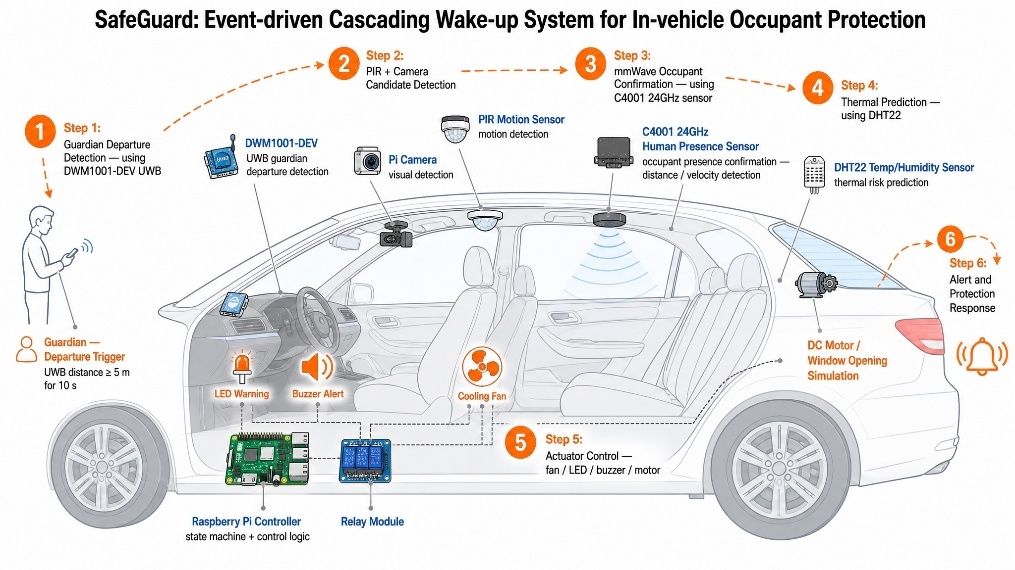
docs/presentation/img/docx/image1.jpeg
