SafeGuard-EWHA/2026ESWContest_mobility_DugoNaerijiMarajo/docs/presentation/img/docx/image2.png

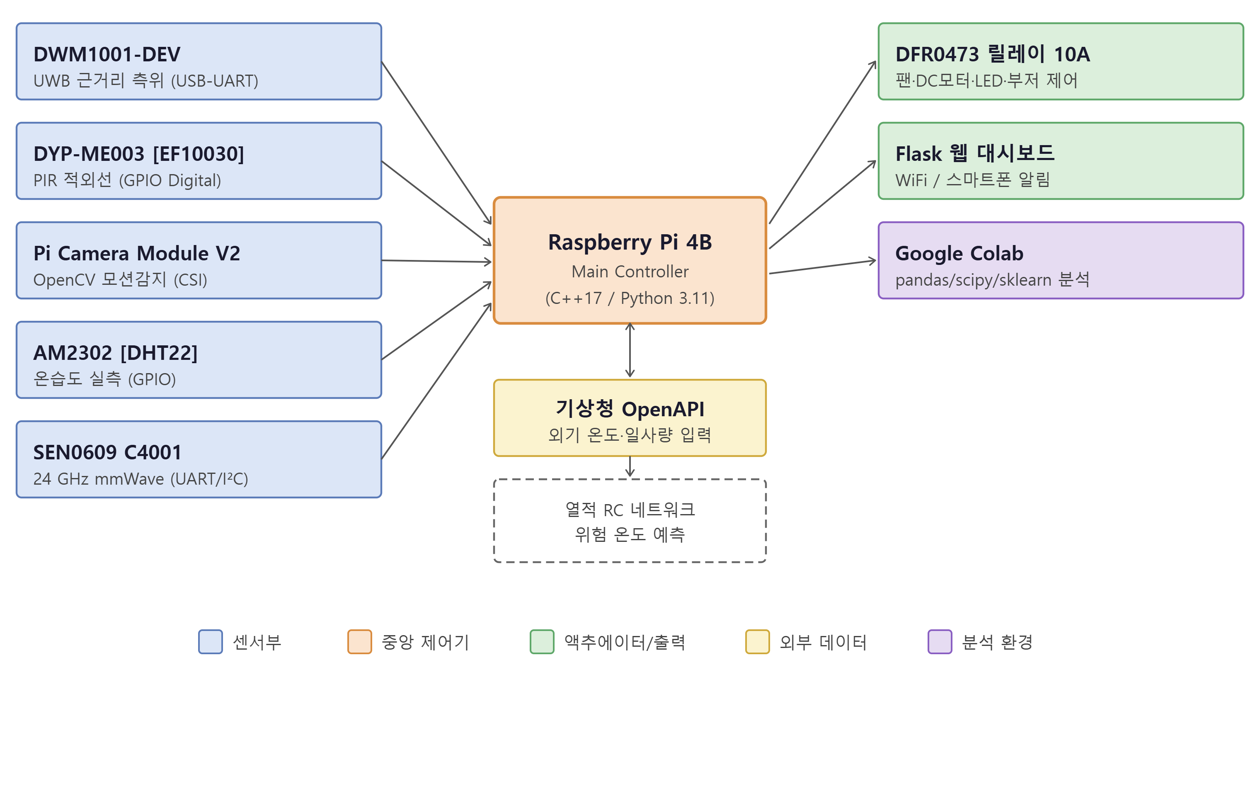
docs/presentation/img/docx/image2.png
