SafeGuard-EWHA/2026ESWContest_mobility_DugoNaerijiMarajo/docs/presentation/img/docx/image3.png

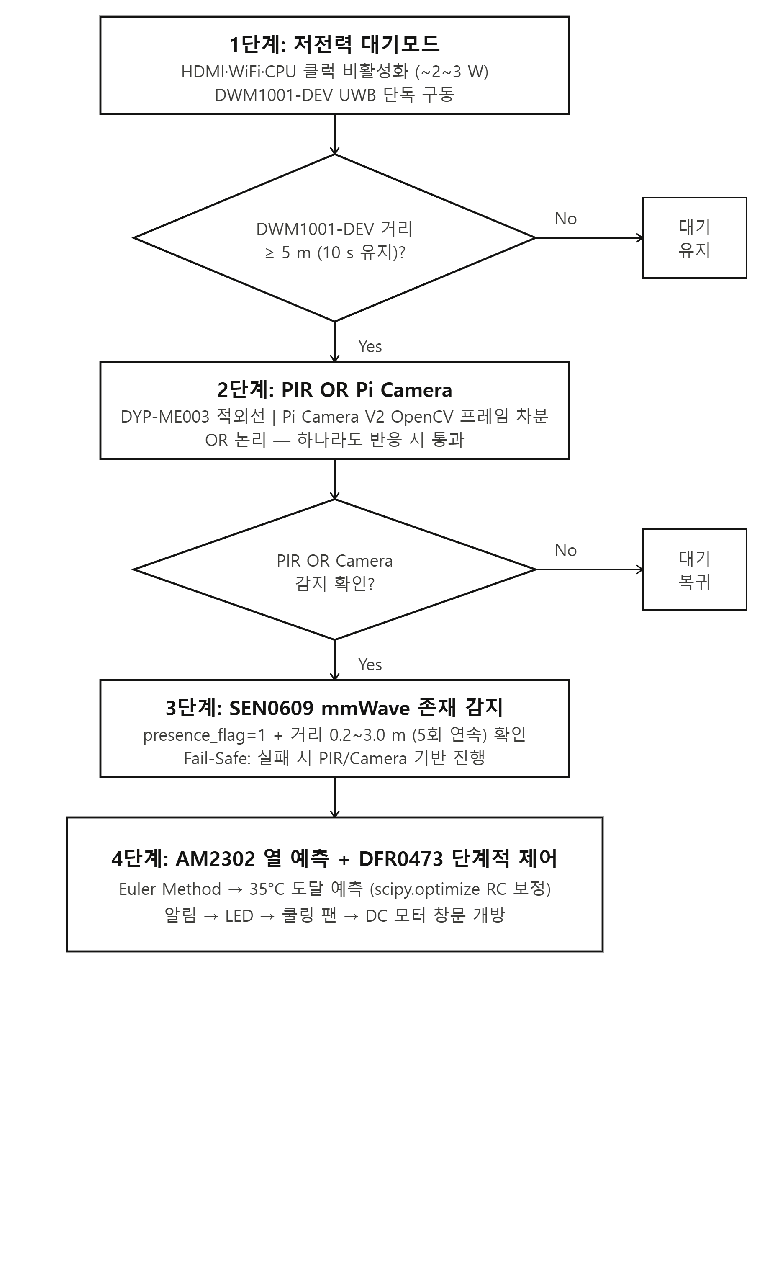
docs/presentation/img/docx/image3.png
