SafeGuard-EWHA/2026ESWContest_mobility_DugoNaerijiMarajo/docs/presentation/img/docx/image4.png

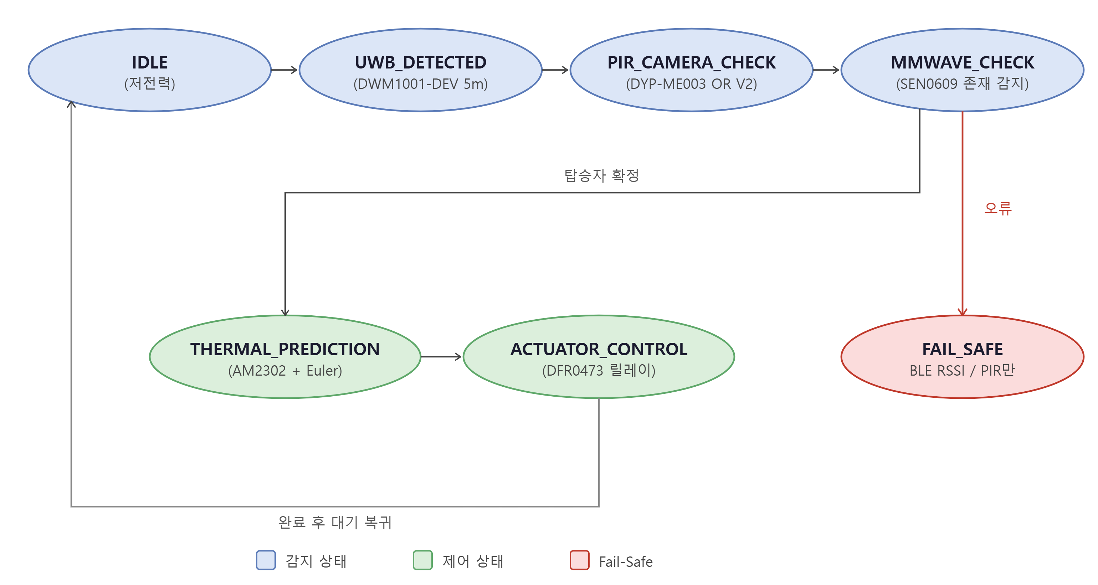
docs/presentation/img/docx/image4.png
