SafeGuard-EWHA/2026ESWContest_mobility_DugoNaerijiMarajo/docs/presentation/img/docx/image12.png

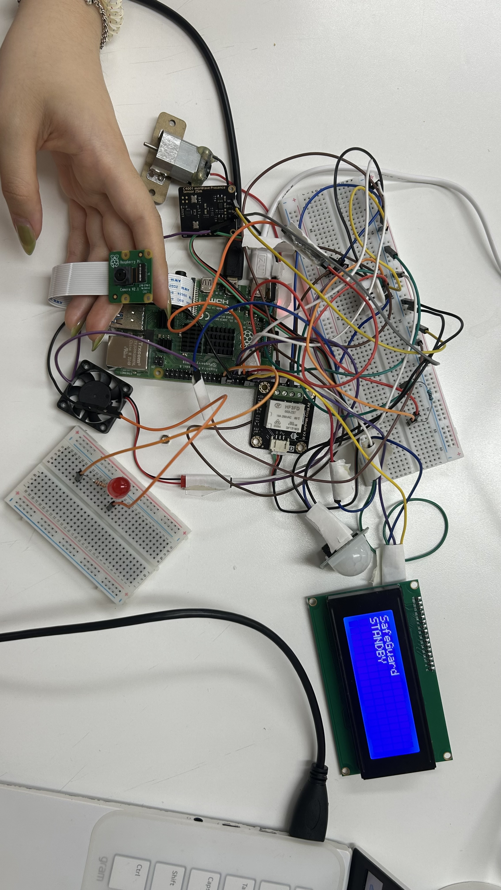
docs/presentation/img/docx/image12.png
