SafeGuard-EWHA/2026ESWContest_mobility_DugoNaerijiMarajo/docs/presentation/img/docx/image20.png

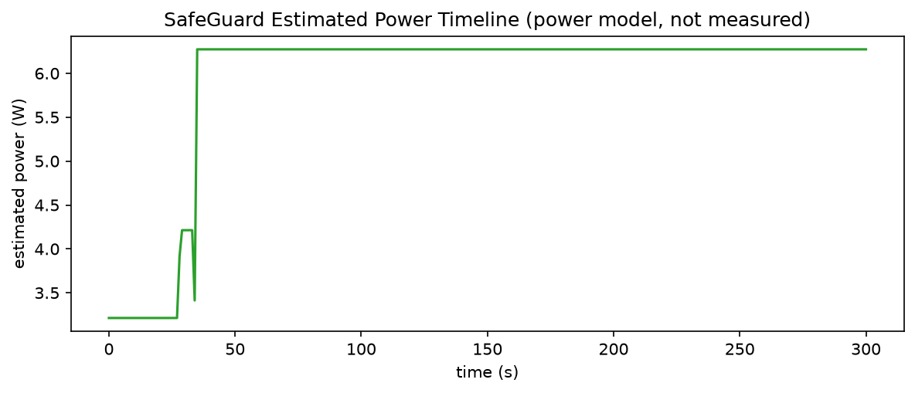
docs/presentation/img/docx/image20.png
