SafeGuard-EWHA/2026ESWContest_mobility_DugoNaerijiMarajo/docs/presentation/img/final/hero_wave.png

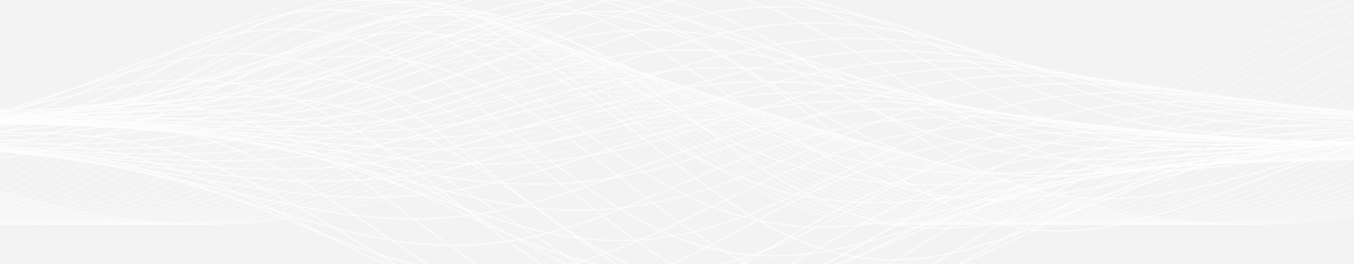
docs/presentation/img/final/hero_wave.png
