SafeGuard-EWHA/2026ESWContest_mobility_DugoNaerijiMarajo/docs/presentation/img/final/pointcloud_preview.gif

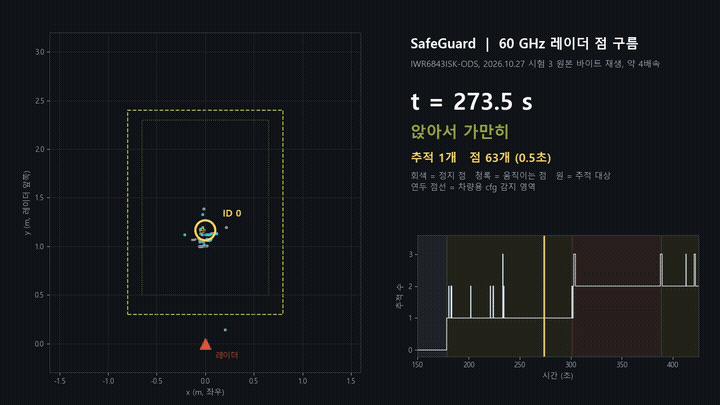
docs/presentation/img/final/pointcloud_preview.gif
