SafeGuard-EWHA/2026ESWContest_mobility_DugoNaerijiMarajo/docs/presentation/img/final/rpt_fig7.png

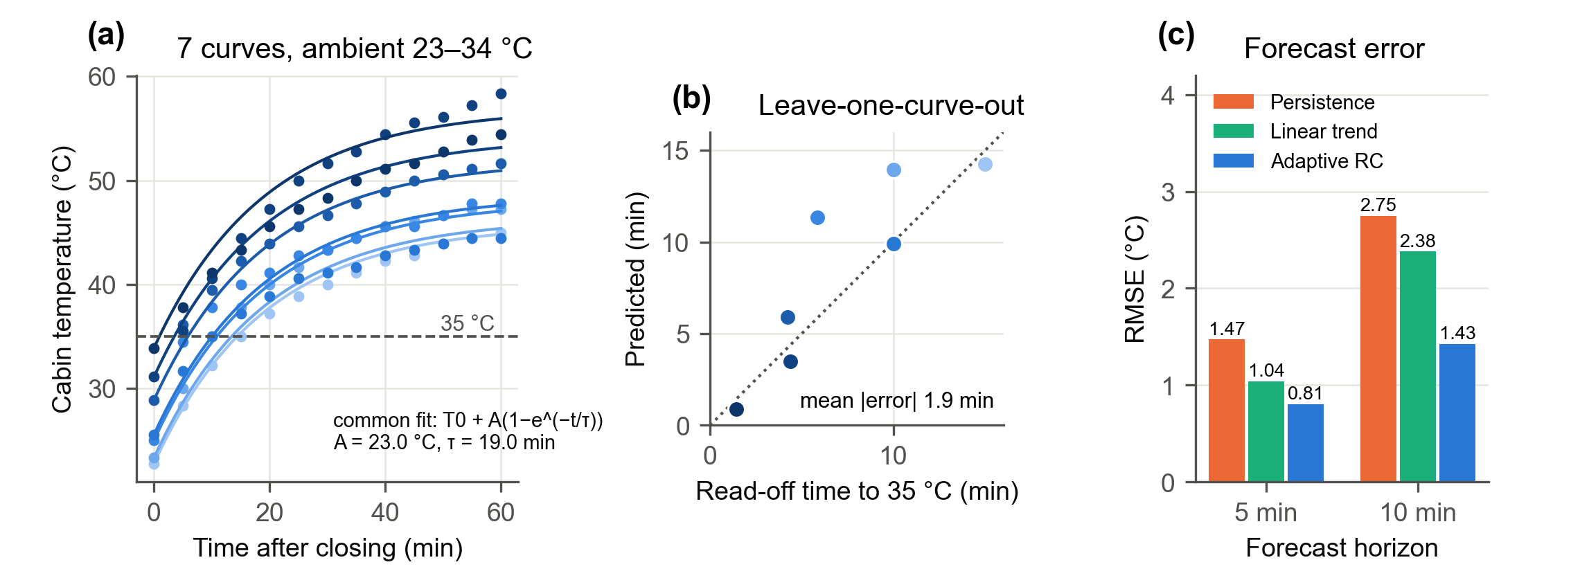
docs/presentation/img/final/rpt_fig7.png
