SafeGuard-EWHA/2026ESWContest_mobility_DugoNaerijiMarajo/docs/presentation/img/final/system_diagram.png

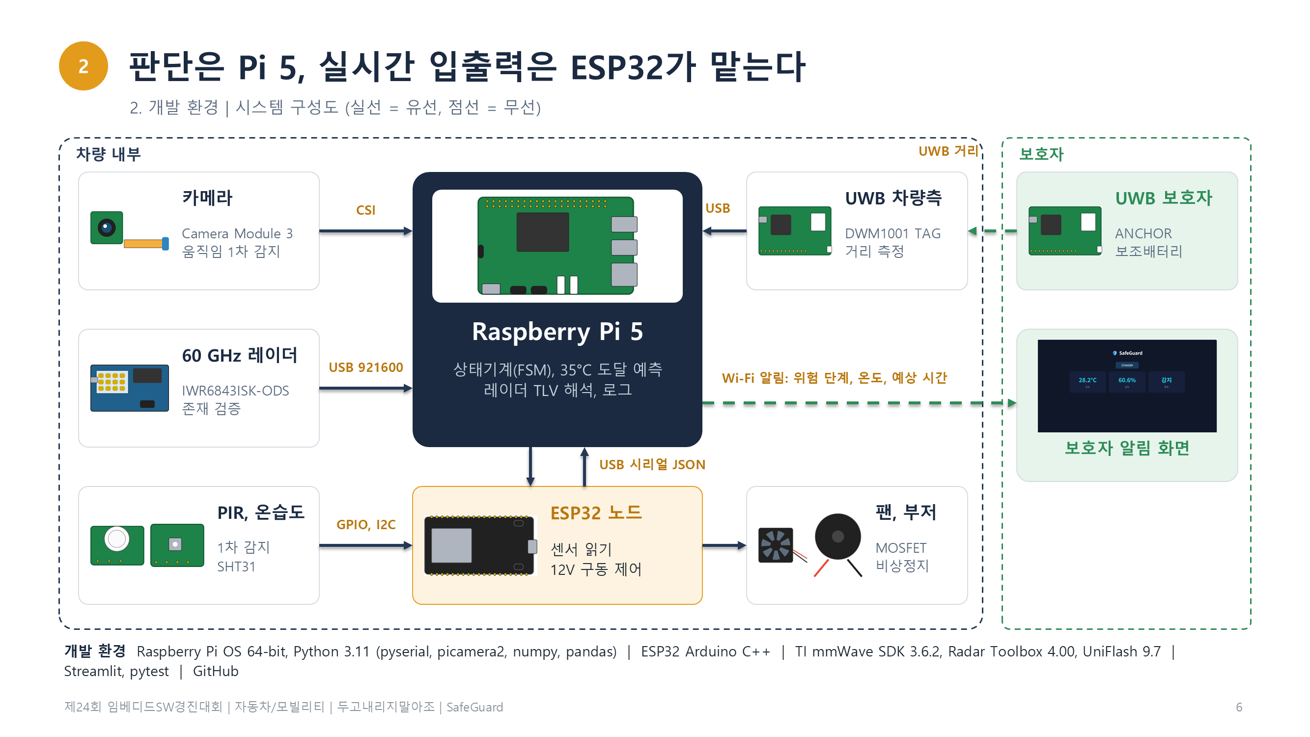
docs/presentation/img/final/system_diagram.png
