SafeGuard-EWHA/2026ESWContest_mobility_DugoNaerijiMarajo/docs/presentation/img/hw/book_p7.png

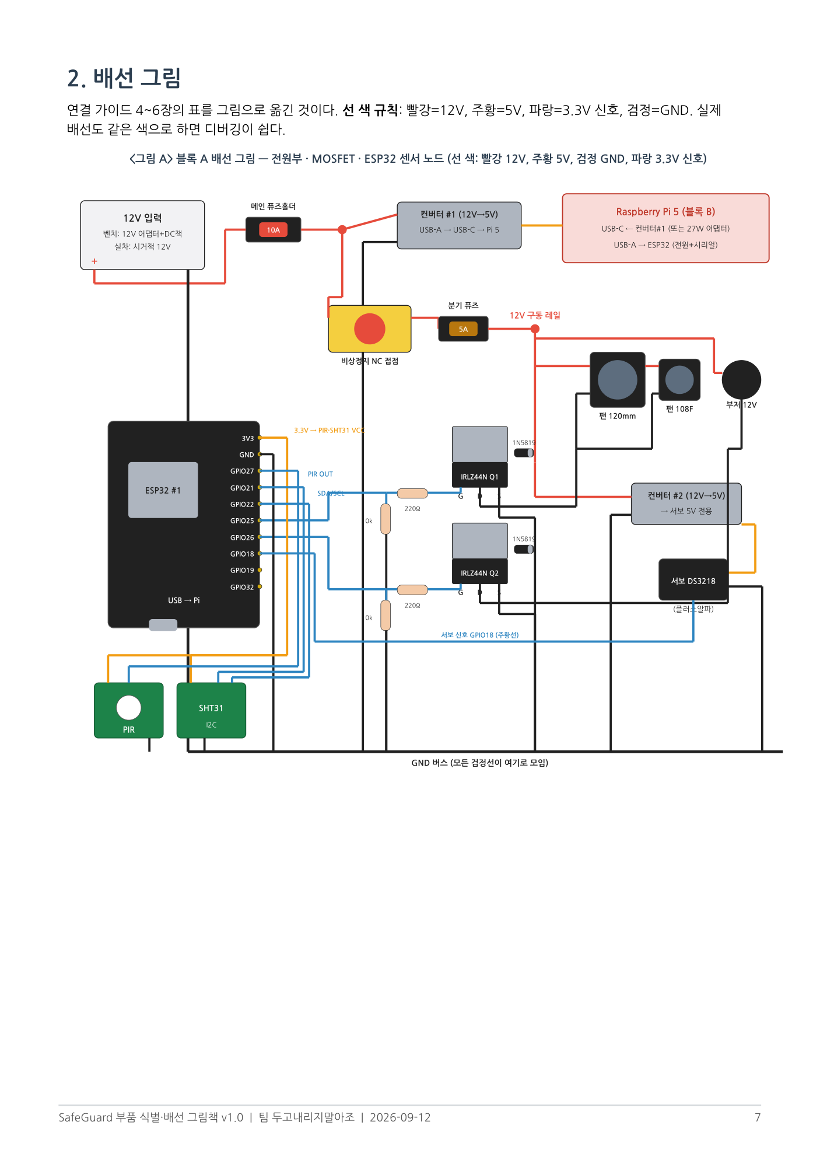
docs/presentation/img/hw/book_p7.png
