SafeGuard-EWHA/2026ESWContest_mobility_DugoNaerijiMarajo/docs/presentation/img/hw/power_tree.png

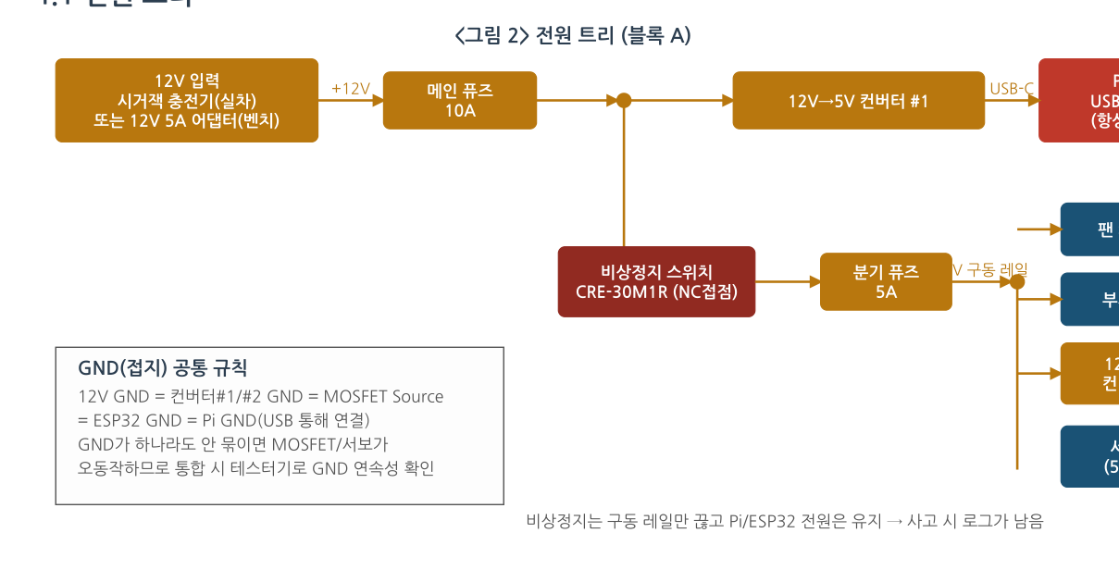
docs/presentation/img/hw/power_tree.png
