SafeGuard-EWHA/2026ESWContest_mobility_DugoNaerijiMarajo/docs/presentation/img/supp/p02_img0.png

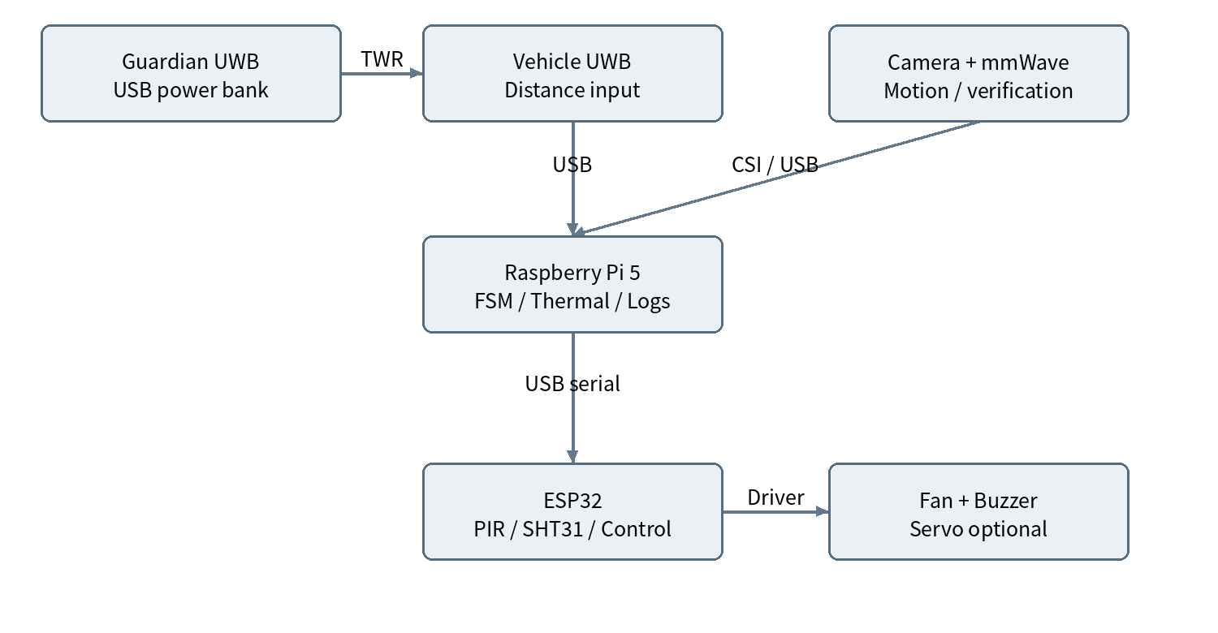
docs/presentation/img/supp/p02_img0.png
