SafeGuard-EWHA/2026ESWContest_mobility_DugoNaerijiMarajo/docs/presentation/img/supp/p19_img1.png

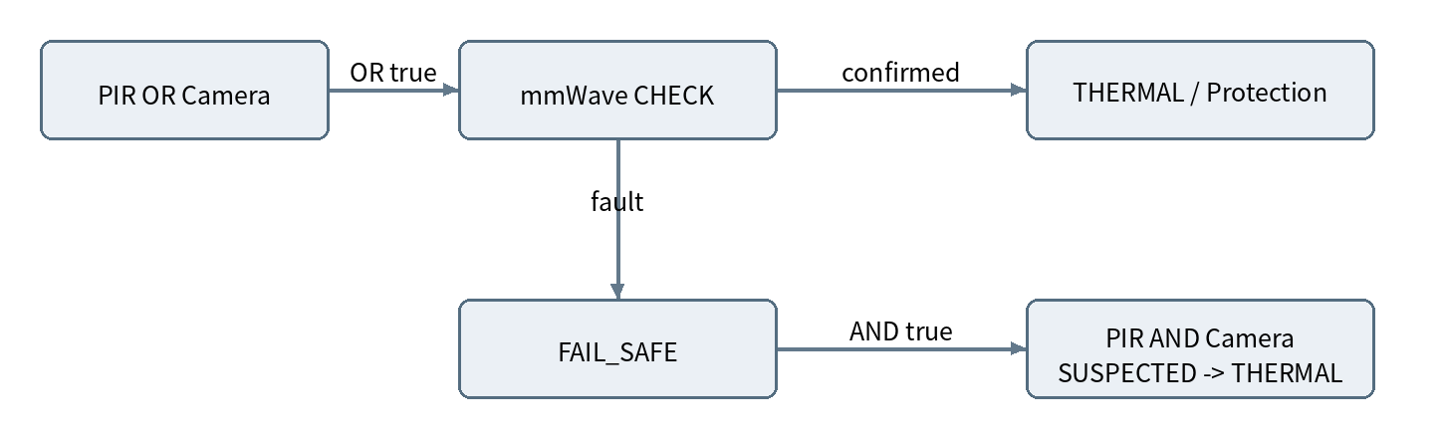
docs/presentation/img/supp/p19_img1.png
