SafeGuard-EWHA/2026ESWContest_mobility_DugoNaerijiMarajo/docs/presentation/img/supp/page01.png

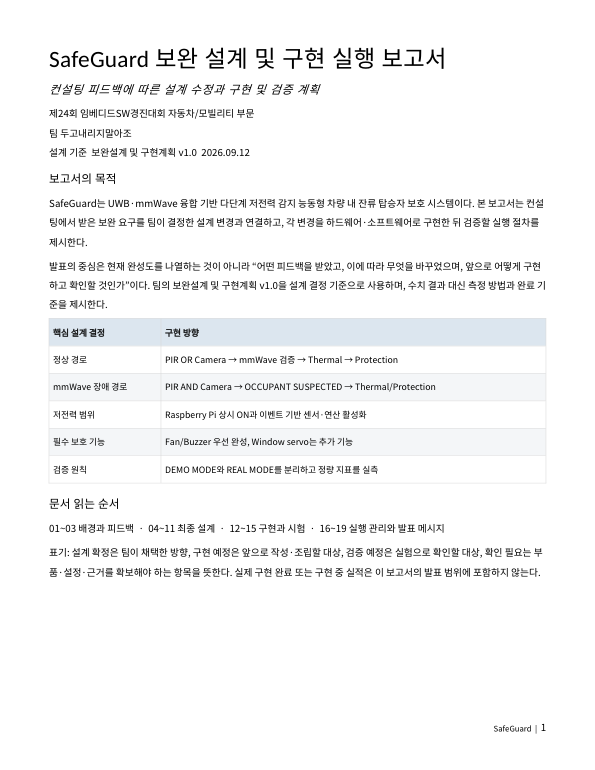
docs/presentation/img/supp/page01.png
