SafeGuard-EWHA/2026ESWContest_mobility_DugoNaerijiMarajo/docs/presentation/img/video/v1_01.jpg

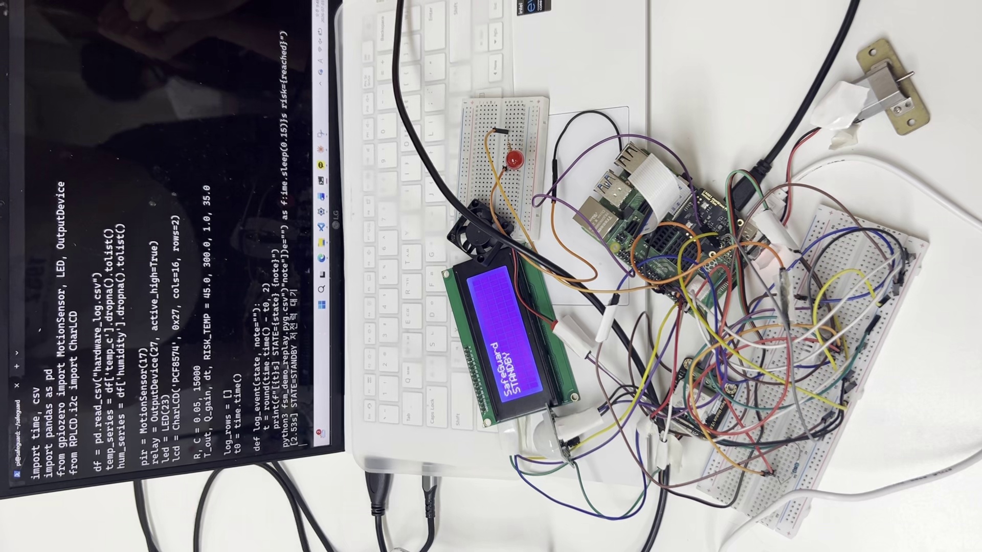
docs/presentation/img/video/v1_01.jpg
