SafeGuard-EWHA/2026ESWContest_mobility_DugoNaerijiMarajo/docs/presentation/img/video/v2_00.jpg

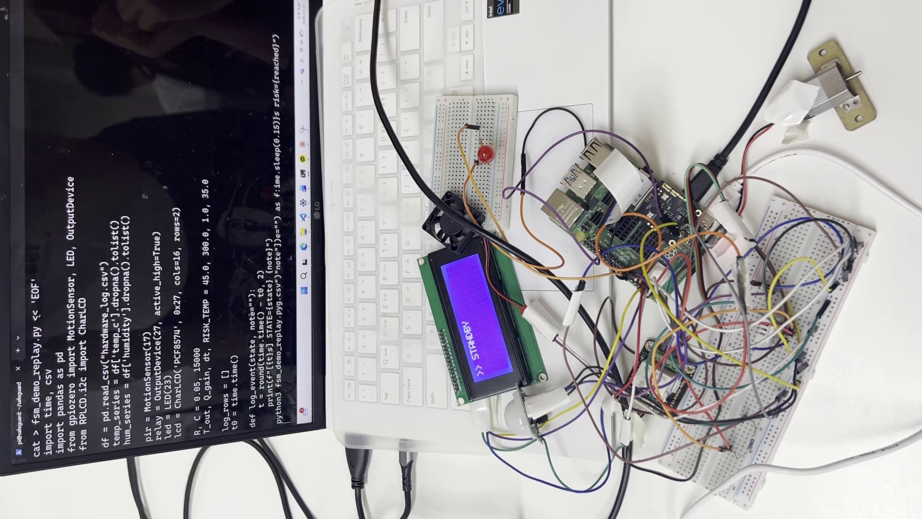
docs/presentation/img/video/v2_00.jpg
