SafeGuard-EWHA/2026ESWContest_mobility_DugoNaerijiMarajo/docs/presentation/img/video/v2_02.jpg

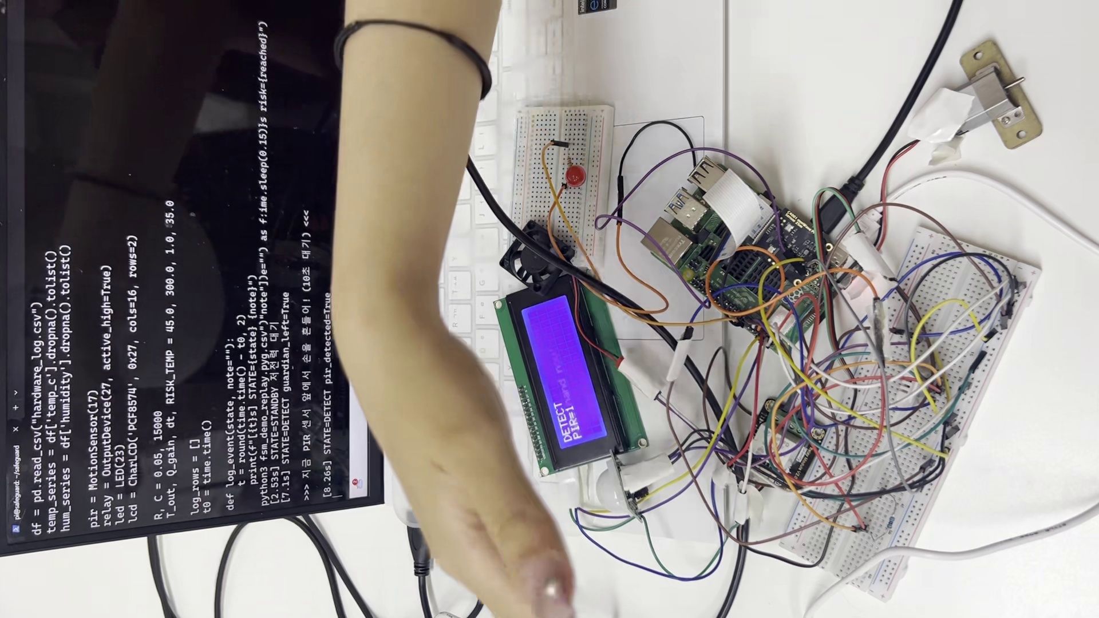
docs/presentation/img/video/v2_02.jpg
