SafeGuard-EWHA/2026ESWContest_mobility_DugoNaerijiMarajo/docs/presentation/img/video/v2_11.jpg

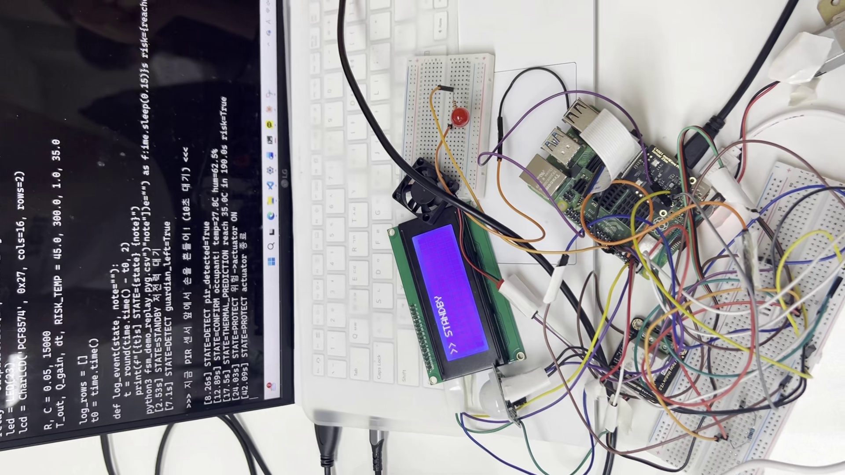
docs/presentation/img/video/v2_11.jpg
