SafeGuard-EWHA/2026ESWContest_mobility_DugoNaerijiMarajo/hardware/docs/배선_ESP32_PIR_SHT31_빵판.png

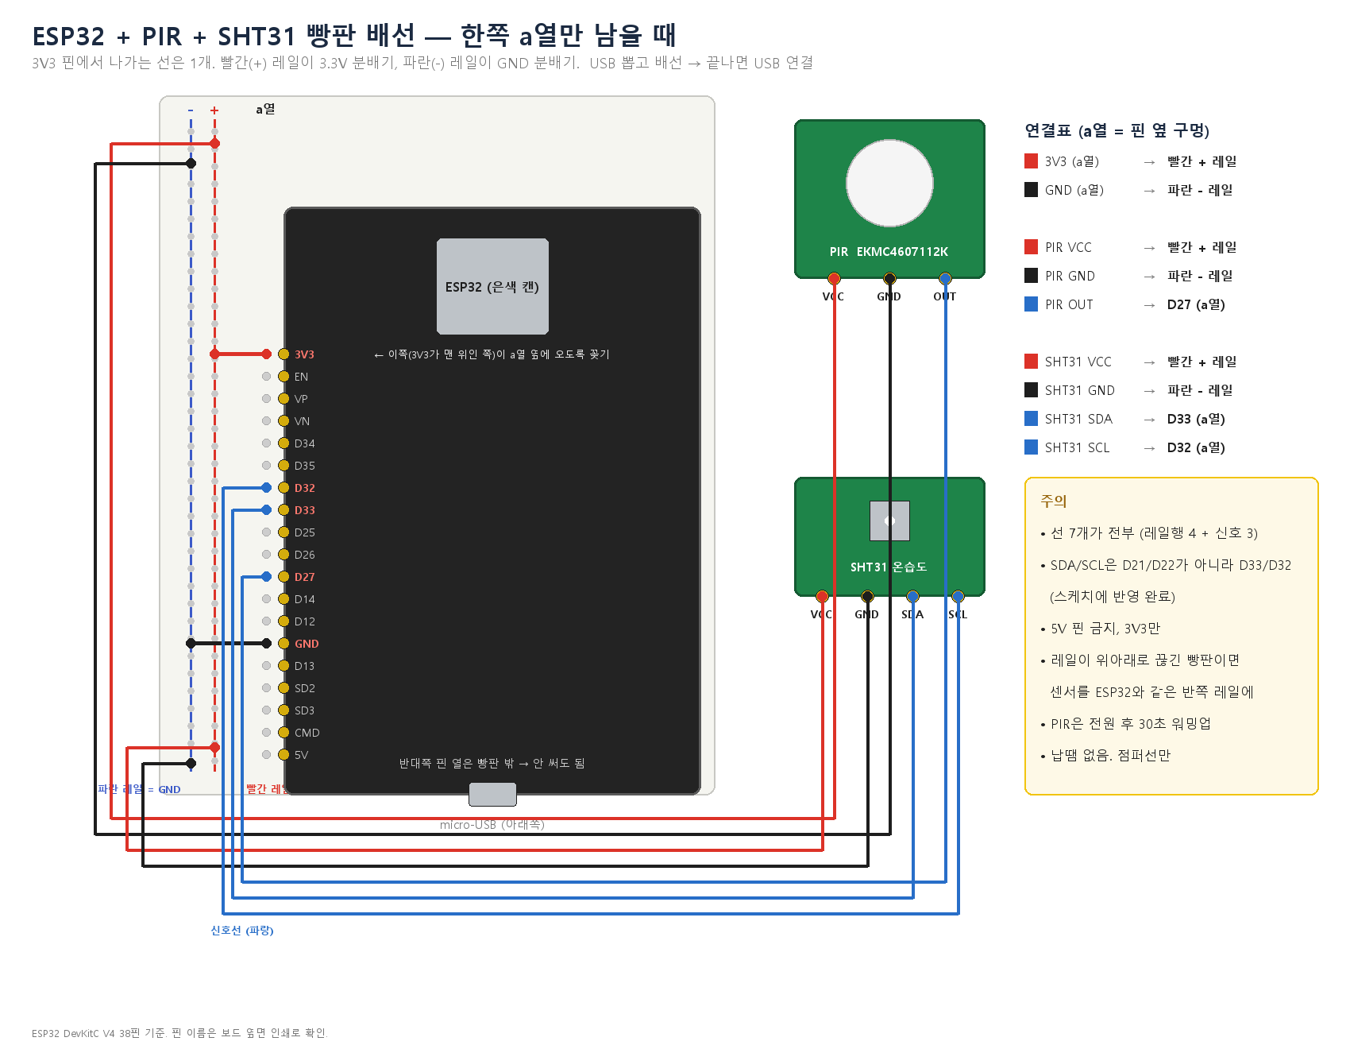
hardware/docs/배선_ESP32_PIR_SHT31_빵판.png
