SafeGuard-EWHA/2026ESWContest_mobility_DugoNaerijiMarajo/hardware/docs/진단_레일끊김_테스터기.png

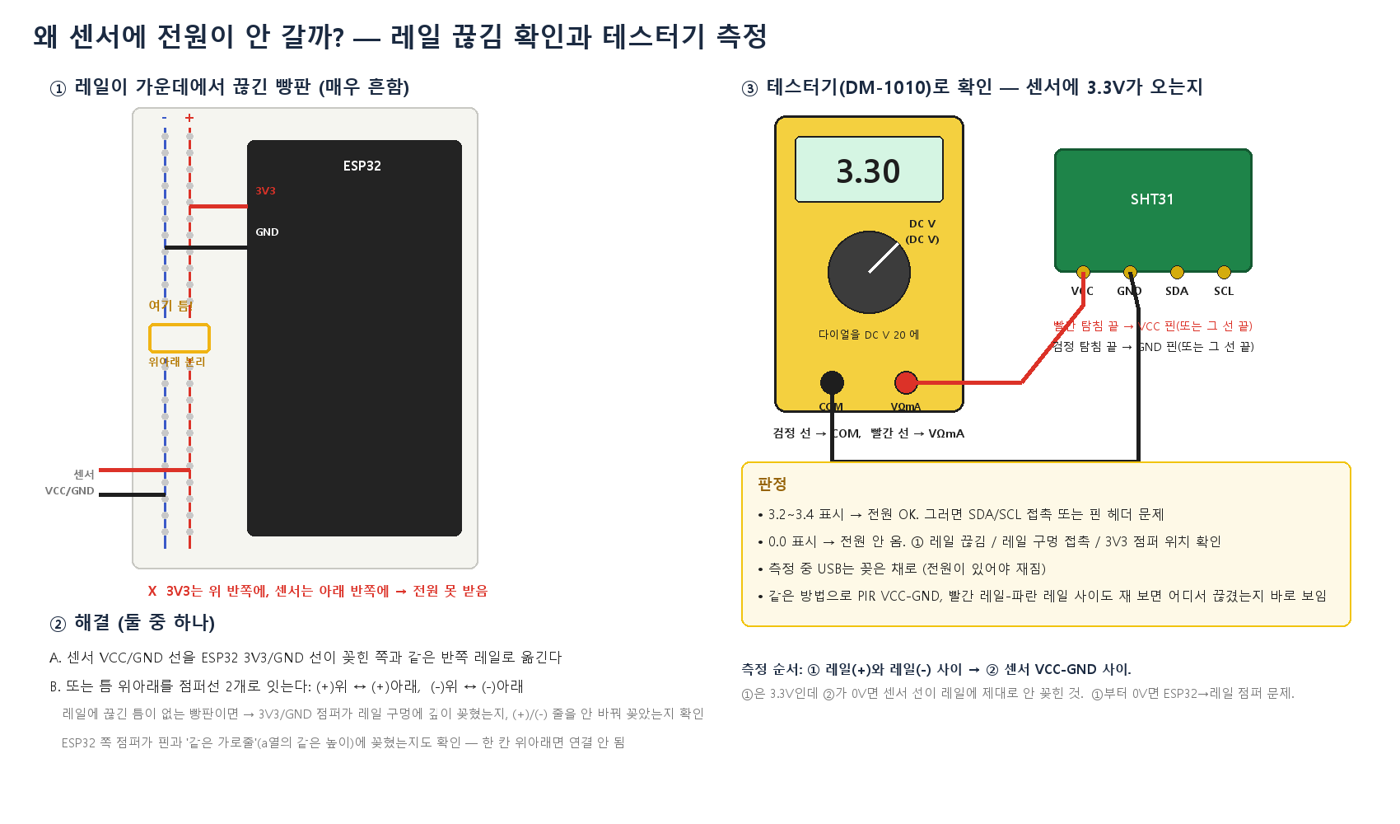
hardware/docs/진단_레일끊김_테스터기.png
