SafeGuard-EWHA/2026ESWContest_mobility_DugoNaerijiMarajo/Pi Camera 프레임 차분 기반 움직임 검출-2.jpg

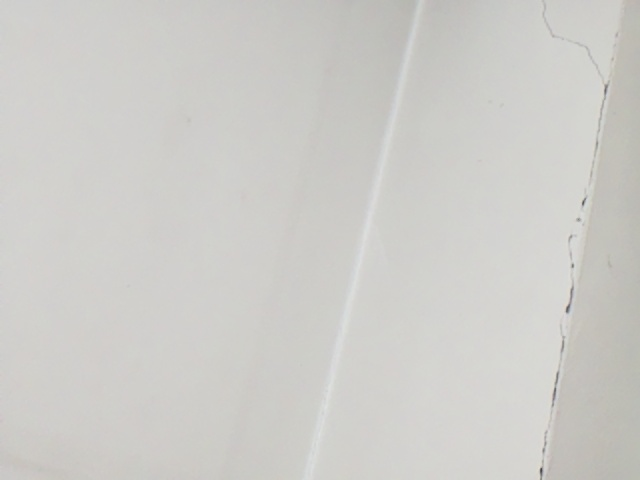
Pi Camera 프레임 차분 기반 움직임 검출-2.jpg
