SafeGuard-EWHA/2026ESWContest_mobility_DugoNaerijiMarajo/pic_red_benz/KakaoTalk_20261028_064853323_13.jpg

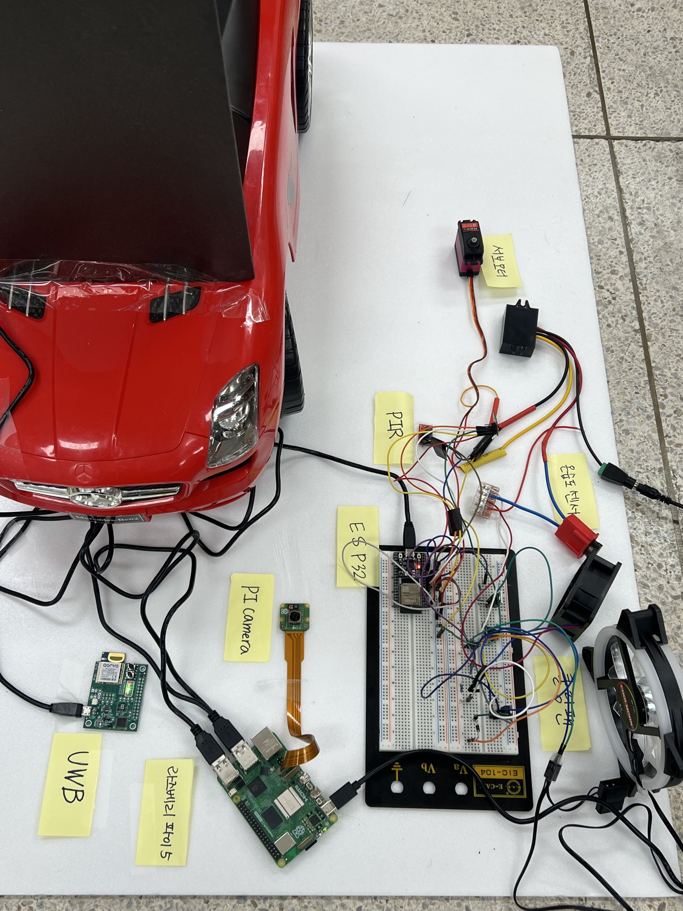
pic_red_benz/KakaoTalk_20261028_064853323_13.jpg
