SafeGuard-EWHA/2026ESWContest_mobility_DugoNaerijiMarajo/pics/KakaoTalk_20261028_015812621_05.jpg

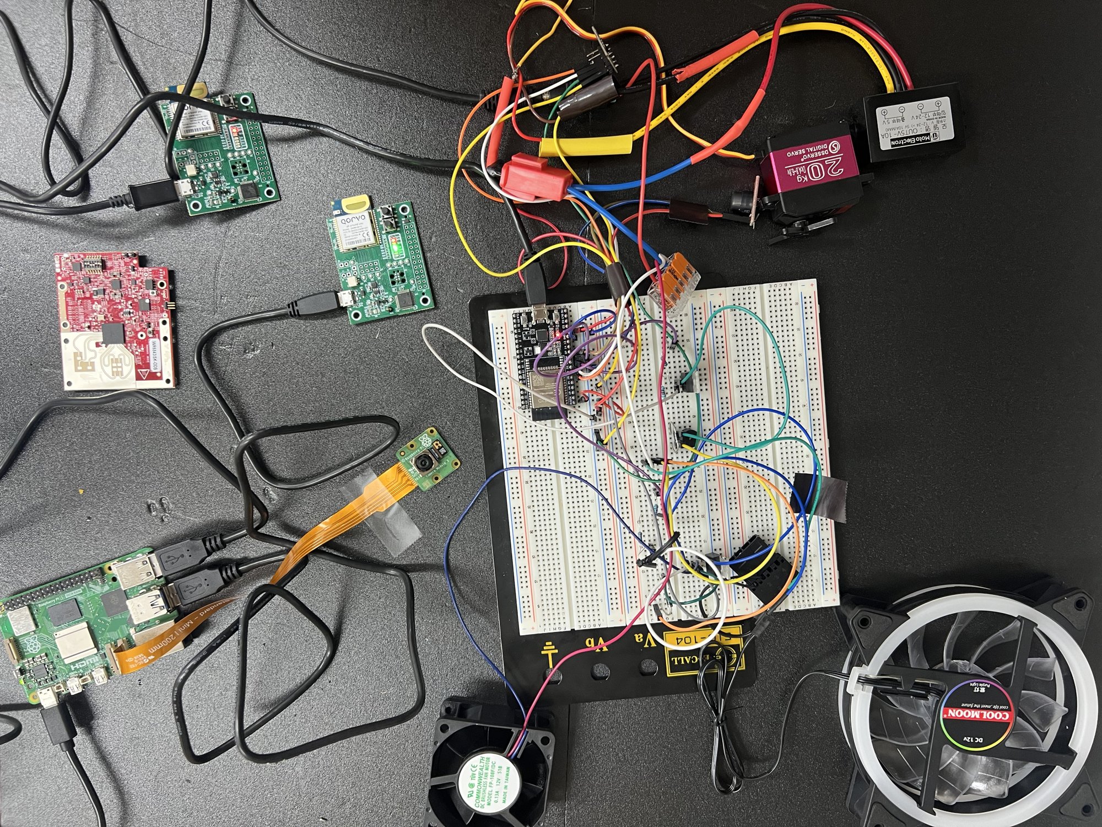
pics/KakaoTalk_20261028_015812621_05.jpg
