SafeGuard-EWHA/2026ESWContest_mobility_DugoNaerijiMarajo/safeguard_simulator_architecture-screenshot.png

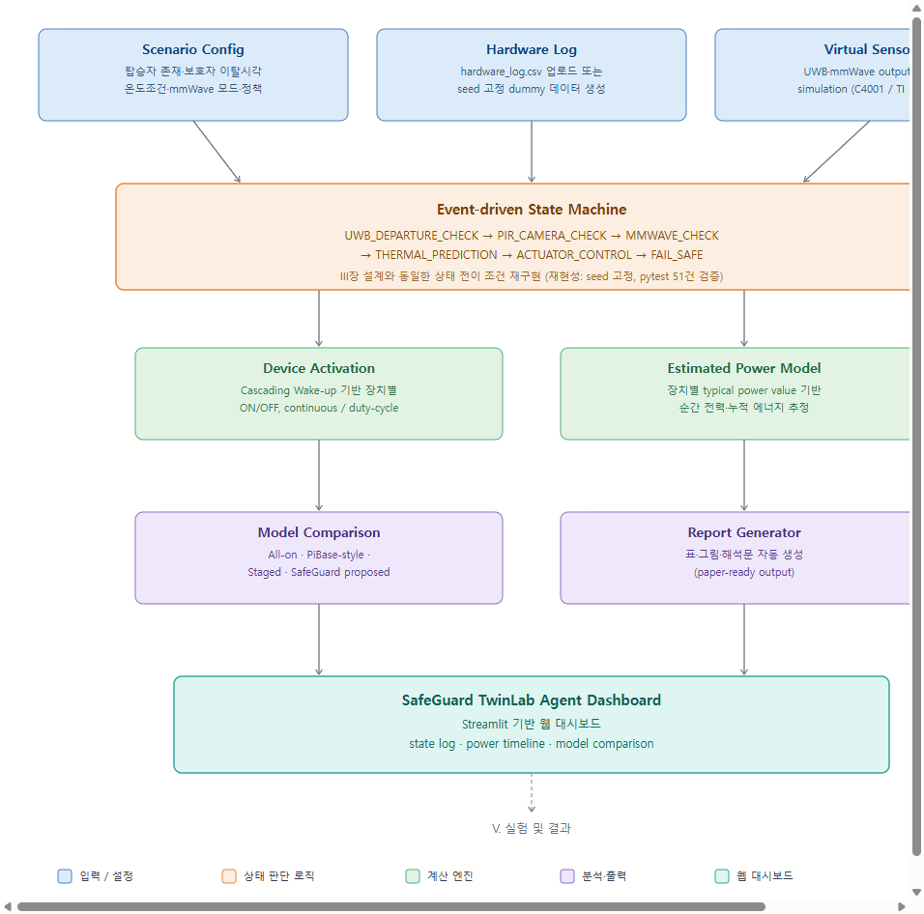
safeguard_simulator_architecture-screenshot.png
