SafeGuard-EWHA/2026ESWContest_mobility_DugoNaerijiMarajo/docs/presentation/img/hw/parts_map.png

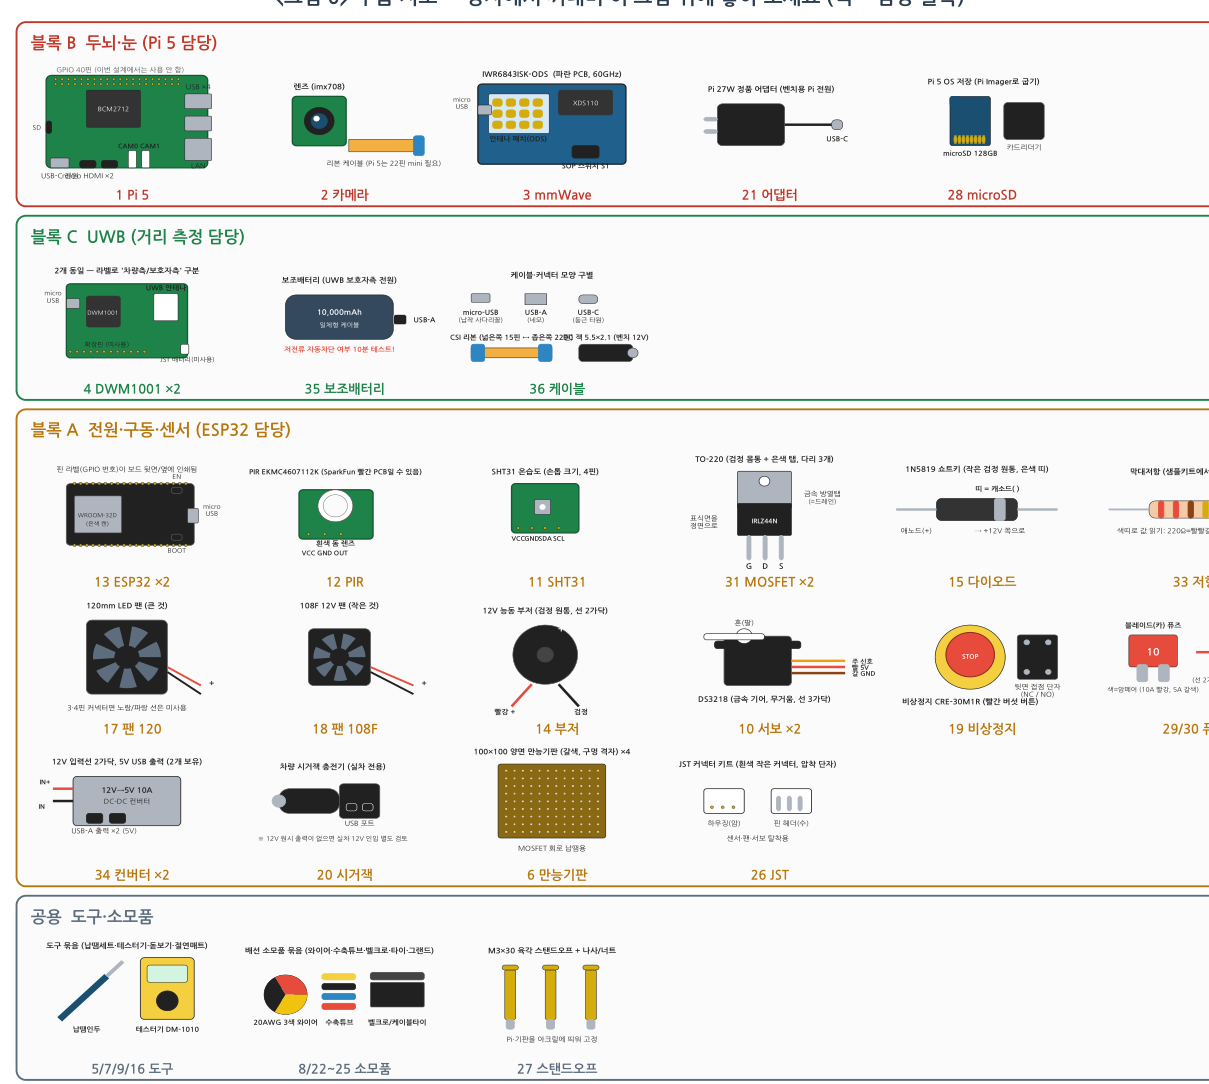
docs/presentation/img/hw/parts_map.png
