SafeGuard-EWHA/2026ESWContest_mobility_DugoNaerijiMarajo/docs/presentation/img/hw/guide_p1.png

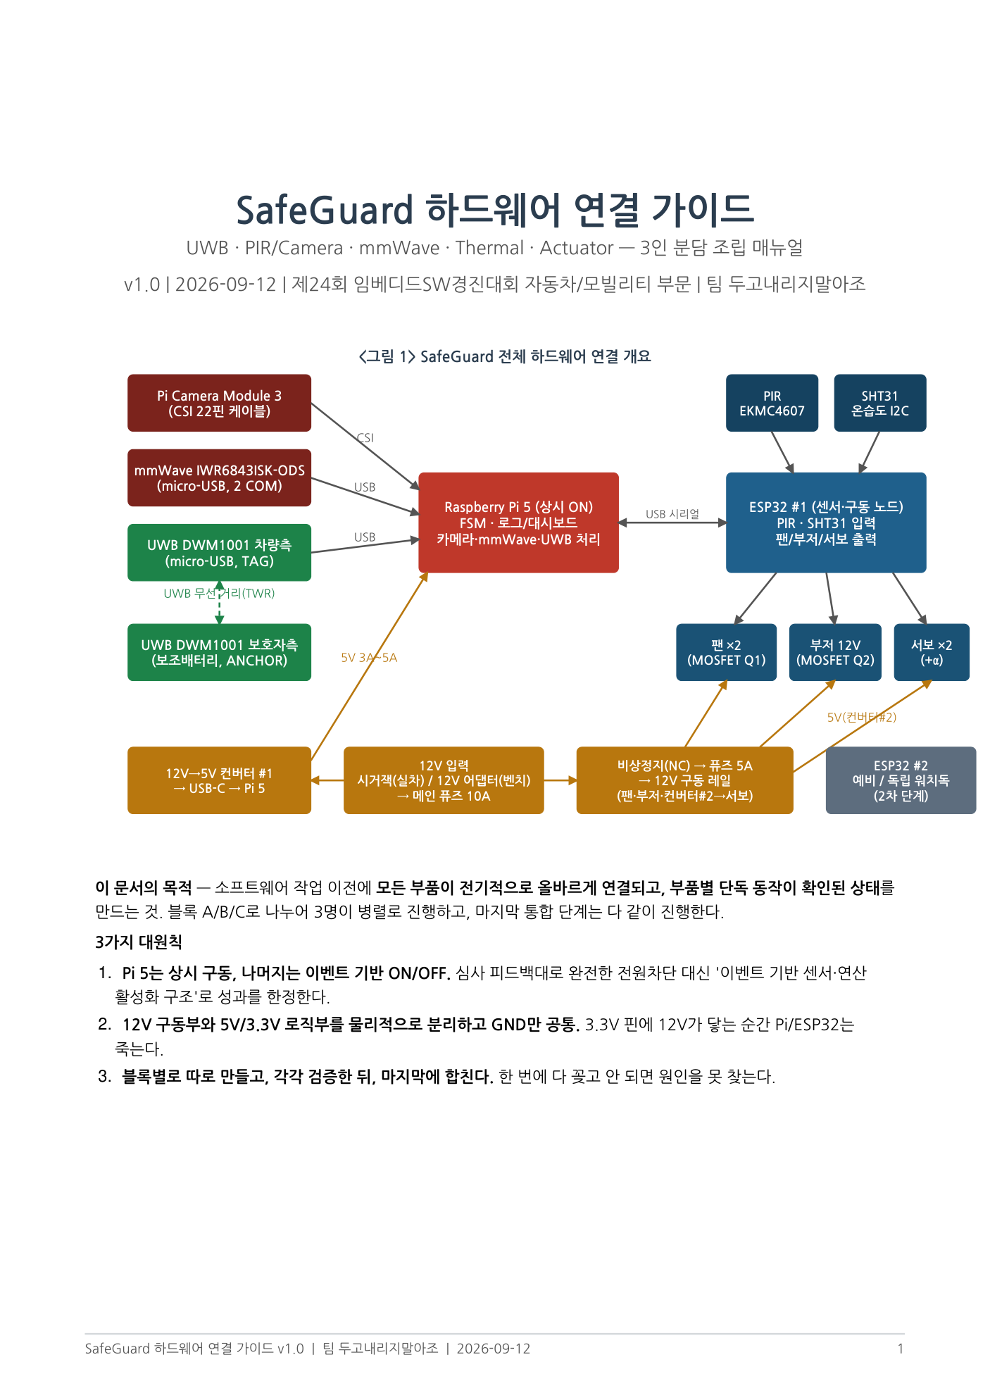
docs/presentation/img/hw/guide_p1.png
