SafeGuard-EWHA/2026ESWContest_mobility_DugoNaerijiMarajo/prototype/maintenance/SafeGuard_BlockB_Input_Update_20261027/VALIDATION_KO.txt

검증 결과 — 2026-10-27

실행 환경: 개발용 Linux 호스트, 소프트웨어 시험. 실제 Pi/레이더/ESP32에 연결하지 않음.

통과:
- 새 Python 검사 20개: 분할/연속 패킷, 잡음, 길이 오류, 111바이트 track 거부,
  누락 TLV와 0대 구별, NaN/잘못된 presence, 중복/역행/번호 wrap,
  정확히 2초부터 stale, 부분 패킷으로 복구, 연속성 표식,
  미검증/처리 비활성 데이터 차단, 설정 해시, cfg 오류 즉시 중단.
- 기존 sensor_hub Python 검사 22개: 출처/시간/순서, ESP 피드백/ACK,
  UWB passive 실행, 측정 무효화, 모의/실측 구분.
- 전체 메인 C++ 빌드 성공.
- 기존 C++ test_core, test_input 통과.
- 새 C++ test_radar_main 통과: 5초 연속 부정 근거, 묶음 수신 중 숨은 변화가
  양성/음성 대기 시간을 초기화, native 어댑터 연속성 필드 필수 검사.
- 설치기 --apply를 프로젝트 복사본에서 실행: 임시 빌드/시험/백업/설치 성공.
- 호환 원본 통과 및 팀원의 다른 수정 거부·보존 확인.
- 설치 후 기존 config 파일 바이트가 원본과 동일함 확인.

소프트웨어 정지 MCU 펌웨어 및 manual_control.hpp는 수정하지 않았으며
이번 차례에 팬·서보를 실제로 돌리거나 물리 정지를 재시험하지 않았음.
외기 API/휴대폰 위치 수신을 이번 차례에 실시간 재시험하지 않았음.
카메라 기존 코드 경로를 유지함. B담당자 카메라 구현과 병합하지 않았음.

아직 미검증:
- 보드에 최종 채택할 People Tracking 펌웨어/설정 조합.
- ODS 좌표계와 실제 센서 장착 위치/좌석 영역.
- 정지 재실/빈 좌석/가림/오검출 및 TLV 생략 규약.
- CP2105 실제 포트 동시 사용, 설정 ACK, 센서 중지 후 재시작.
- 다른 센서들과 동시 운용 시 CPU 부하/지연.
- 실제 출력과 컴퓨터 전체 정지/감시 재개.
- 최종 통합 시연 및 전원 재시작.

5초는 제안된 연속 부정 관측 후보값이며 현장 성능을 인증한 값이 아님.
본 시험 결과를 실제 사람 감지율이나 완제품 안전 검증으로 사용하면 안 됨.
