SafeGuard-EWHA/2026ESWContest_mobility_DugoNaerijiMarajo/prototype/maintenance/SafeGuard_Camera_Link_20261027/VALIDATION_KO.txt

검증 범위 — 2026-10-27

입력 자료
- 사용자가 보낸 SafeGuard_Main_Current.zip의 sensor_hub 및 설정.
- B회신3_20261027_메인전달.zip의 camera_motion.py와 두 카메라 CSV.
- B 원본 camera_motion.py SHA256:
  bdb1c0e79da1d60df09d937830d73fcd8f832236b952f446a503ff948e7bb3e1
  배포된 block_b_camera_motion.py와 바이트 단위 일치.

실행한 검사
- 기존 sensor_hub 프로토콜/유효성/장애 관련 22개 검사 통과.
- 새 detector/worker 9개 검사 통과.
  초기 프레임, 연속 3프레임, 정지 장면, 조명 및 안정화, 프레임 간격 초과,
  처리 재활성화 전 초기화, 밝기 차분/ROI, 잘못된 설정, 연결 오류/정리 포함.
- 업로드 프로젝트 복사본에 실제 설치기 --apply 실행 성공.
- 기존 설정의 모든 값 보존 확인(새 카메라 backend/전용 설정만 추가).
- 재설치 시 변경 없음 확인.
- 알 수 없는 sensor_hub 수정본을 덮어쓰지 않고 거부함을 확인.
- B cam_light.csv 1,996행: 원본 MotionState 재생 결과 motion_active 및 kind 모두 일치.
- B test3_cam.csv 4,594행: motion_active 모두 일치. kind는 2행 차이.
  CSV에는 ratio 소수 네 자리/시각 소수 세 자리만 있으므로 원본 정밀도 재현은 불가.
  이 재생 검사는 기록된 비율을 사용하며 실제 이미지 수신 경로를 검증하지 않습니다.

검증하지 않은 것
- 이 환경에는 Pi 카메라가 없으므로 새 adapter의 실제 Pi 카메라 수신은 미검증.
- 전체 C++ FSM 시나리오/물리 출력/전원 차단/감시 재개는 이번 검사 대상 아님.
- 이번 변경은 C++ 소스를 수정하지 않으며 C++ 빌드 결과를 주장하지 않음.
- 원본 B 카메라 시험의 조명 조건 밖에서 정확도를 보장하지 않음.
- 레이더 감지 잔류, ESP32 USB 재연결 안정성은 이 패키지의 수정 범위가 아님.
