SafeGuard-EWHA/2026ESWContest_mobility_DugoNaerijiMarajo/prototype/measurements/derived/radar_interval_summary.csv

label | start_s_inclusive | end_s_exclusive | frames | positive_frames | positive_percent
Initial empty | 0 | 170 | 3090 | 0 | 0.0
Seated still | 180 | 300 | 2182 | 2182 | 100.0
Empty after departure | 315 | 375 | 1090 | 1090 | 100.0
