SafeGuard-EWHA/2026ESWContest_mobility_DugoNaerijiMarajo/B회신4_20261027/analyze_test3_tracks_output.txt

(1) 고정 추적 주변 점이 있었던 프레임 수
  빈자리1 id0: 프레임 3090, 점 있음 0, 움직이는 점 있음 0
  빈자리1 id4: 프레임 3090, 점 있음 0, 움직이는 점 있음 0
  퇴장 후 빈자리2 id0: 프레임 1090, 점 있음 0, 움직이는 점 있음 0
  퇴장 후 빈자리2 id4: 프레임 1090, 점 있음 0, 움직이는 점 있음 0
(2) 앉아 있는 사람 추적(가장 작은 id) 주변 점이 끊긴 최장 시간
  정지 2분: 프레임 2182, 점 없는 최장 10프레임(0.55s), 움직이는 점 없는 최장 12프레임(0.66s)
  재착석 정지 30초: 프레임 564, 점 없는 최장 35프레임(1.93s), 움직이는 점 없는 최장 35프레임(1.93s)
