SafeGuard-EWHA/2026ESWContest_mobility_DugoNaerijiMarajo/prototype/maintenance/SafeGuard_Thermal_20261028/VALIDATION.md

# 검증 기록 — 2026-10-28

## 실행한 소프트웨어 검사

실행 환경: 개발용 Linux x86_64, g++ C++17, CMake, Node.js. Pi ARM과 실제 장치 시험은 미실시.

| 검사 | 결과 |
|---|---|
| 변경된 main.cpp + 기존 core.cpp 실제 컴파일 | 통과, -Wall -Wextra -Werror |
| 기존 core 단위 테스트 | 통과 |
| 원본 입력 계약/재무장 C++ 테스트 | 설치기 CTest에서 통과 |
| 새 thermal observer 수치/결측/시간/출처/팬/추세 검사 | 통과 |
| 기존 대시보드 렌더 테스트 | 통과 |
| 새 연구용 표기/초기 시나리오/겨울 범위/끊김 후 곡선 제거 | 통과 |
| 기존 7개 실행 시나리오 | 통과: 정상, mmWave 장애, UNKNOWN, 외기 장애, 비상정지, REAL 입력 없음, DEMO 입력 없음 |
| observer를 켠 컴파일된 main 실행/상태 로그/종료 무효화 | 통과 |
| 설치기: 임시 프로젝트 빌드 + 3개 CTest | 통과 |
| 설치기: 35°C·서보80° 보존 및 롤백 바이트 일치 | 통과 |
| 설치기: 미지원 소스 거부·설치 후 사용자 편집 보호 | 통과 |
| 실제 Pi 설치·ESP32·팬·부저·서보 구동 | 미실시 |
| 다른 차량/겨울/실제 일사에서 예측 정확도 | 미검증 |

기존 `test_input.cpp`의 ControllerFeedback 일부 필드 초기화에 대한 컴파일 경고가 있었습니다.
이번 변경의 main/observer 코드는 -Werror 컴파일을 통과했고, 기존 경고를 숨기거나 수정하지 않았습니다.
전체 프로젝트에 경고가 없다는 뜻은 아닙니다.

새 수치 테스트에는 지수식의 120초 도달 조건, 5분 내 미도달, 냉각, 이미 기준 도달,
중복 프레임, NaN, 오래된 온도, REAL 모드 DEMO 출처, 시각 역행, 팬 개입, 겨울 외기,
급격한 온도 계단 변화, 추정치가 있어도 STANDBY에서 출력이 켜지지 않는 조건을 포함했습니다.
데모는 실제 모듈을 합성 입력으로 실행해 `tests/example_result.json`으로 저장하고 그 결과를 그렸습니다.

## 문헌 그래프를 이용한 사전 모델 비교

출처: McLaren 2005 Fig.3. 7개 곡선의 0~60분, 5분 간격 시각 약독 자료.
**원시 계측 데이터가 아니며, 동일 연구·동일 차량 범위의 평가입니다.**
평가할 곡선을 제외한 나머지 곡선에서 시간상수를 적합하고, 평가 곡선의 직전 10분 3개 점으로
기울기를 구해 미래를 예측했습니다. 아래 수치는 `research/analyze.py`를 재실행해 확인했습니다.

| 5분 후 온도 예측 / 70개 비교점 | MAE (°C) | 최대 절대오차 (°C) |
|---|---:|---:|
| 현재 온도 유지 | 1.254 | 3.889 |
| 직선 추세 외삽 | 0.730 | 4.167 |
| 시간상수 + 관측 추세 | 0.563 | 3.440 |

10분 후 동일 계열 모델 MAE 0.890°C, 최대 절대오차 6.754°C로 장기 예측 오차가 커졌습니다.
따라서 구현의 표시 예측 범위는 5분으로 제한했습니다. 평균 오차만을 이용해 안전성을 주장하지 않습니다.

초기 고정 곡선 모델의 곡선 분리 평가 MAE는 1.888°C, 최대 절대오차 5.971°C였으며,
35°C 도달 시점을 약 5.51분 늦게 계산한 사례가 있었습니다. 초기 곡선을 자동 제어에 연결하지 않은 이유입니다.
7개 중 6개는 10분 이력 확보 시점에 이미 35°C 이상이므로, 이 모델은 단독으로 초기 보호를 완성하지 못합니다.

**실시간 구현과 문헌 평가의 차이:** 실시간 구현은 약 5초 간격의 최근 10분 데이터로 회귀합니다.
문헌은 5분 간격의 3점 회귀입니다. 또한 실제 구현의 최종 시간상수는 전체 7개 곡선 적합값입니다.
따라서 위 MAE를 설치된 실시간 시스템의 정확도나 독립 검증 성능으로 표시하면 안 됩니다.
최종 시간상수에 대한 미사용 외부 데이터 검증은 없습니다.

그림 읽기 오차 ±1°F를 독립적으로 교란한 민감도 계산은 `research/results.json`에 기록했습니다.
이 민감도 범위는 통계적 신뢰구간이나 실제 차량 예측 구간이 아닙니다.

## 재현

Pi 설치기는 CMake/CTest로 3개 C++ 테스트를 실행한 뒤에만 설치합니다.
개발용 전체 재현:

```bash
python3 tests/test_install.py /path/to/original/SafeGuard_Main
python3 research/analyze.py
```

두 번째 명령에 NumPy와 SciPy가 필요합니다. 실제 Pi 메인에는 이 패키지들이 필요하지 않습니다.
실행 시나리오 기록은 `tests/scenario_results.json`, 설치기 원본 출력은 `tests/install_test.log`에 있습니다.
기록 속 임시 경로는 개발 환경의 경로이며 Pi에 존재할 것으로 가정하지 않습니다.
