SafeGuard-EWHA/2026ESWContest_mobility_DugoNaerijiMarajo/B회신2_20261027/3_test3/test3_cues.csv

event | t_plan_s | laptop_time | pi_time | say
countdown | 0 | 1793096866.308 | 1793096868.386 | 15초 뒤 레이더 시험을 시작합니다. 레이더 대각선 뒤 멀리 가 계세요.
start_empty | 15 | 1793096881.329 | 1793096883.407 | 시작. 빈자리 3분입니다. 그대로 계세요.
empty_1min_left | 135 | 1793097001.313 | 1793097003.391 | 빈자리 1분 남았습니다.
sit_down | 185 | 1793097051.303 | 1793097053.381 | 의자로 가서 앉으세요.
still_start | 195 | 1793097061.304 | 1793097063.382 | 가만히 계세요. 2분입니다.
still_end | 315 | 1793097181.314 | 1793097183.392 | 일어나서 레이더 대각선 뒤로 나가세요.
empty2_start | 330 | 1793097196.326 | 1793097198.404 | 빈자리 1분입니다. 그대로 계세요.
sit_again | 390 | 1793097256.302 | 1793097258.380 | 다시 의자로 가서 앉으세요.
still2_start | 400 | 1793097266.318 | 1793097268.396 | 가만히 계세요. 30초입니다.
end | 430 | 1793097296.326 | 1793097298.404 | 레이더 시험 끝. 일어나도 됩니다.
