SafeGuard-EWHA/2026ESWContest_mobility_DugoNaerijiMarajo/B회신3_20261027/1_radar_test3/test3_cam.csv

wall_time | ratio | kind | motion_active
1793096849.536 | 0.0000 | still | 0
1793096849.636 | 0.0000 | still | 0
1793096849.736 | 0.0000 | still | 0
1793096849.836 | 0.0000 | still | 0
1793096849.937 | 0.0000 | still | 0
1793096850.036 | 0.0000 | still | 0
1793096850.136 | 0.0000 | still | 0
1793096850.236 | 0.0000 | still | 0
1793096850.336 | 0.0000 | still | 0
1793096850.436 | 0.0000 | still | 0
1793096850.536 | 0.0000 | still | 0
1793096850.636 | 0.0000 | still | 0
1793096850.736 | 0.0000 | still | 0
1793096850.836 | 0.0000 | still | 0
1793096850.936 | 0.0000 | still | 0
1793096851.036 | 0.0000 | still | 0
1793096851.136 | 0.0000 | still | 0
1793096851.236 | 0.0000 | still | 0
1793096851.336 | 0.0000 | still | 0
1793096851.436 | 0.0000 | still | 0
1793096851.536 | 0.0000 | still | 0
1793096851.636 | 0.0000 | still | 0
1793096851.736 | 0.0000 | still | 0
1793096851.836 | 0.0000 | still | 0
1793096851.938 | 0.0000 | still | 0
1793096852.037 | 0.0000 | still | 0
1793096852.137 | 0.0000 | still | 0
1793096852.236 | 0.0000 | still | 0
1793096852.336 | 0.0000 | still | 0
1793096852.436 | 0.0000 | still | 0
1793096852.536 | 0.0000 | still | 0
1793096852.636 | 0.0000 | still | 0
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
