SafeGuard-EWHA/2026ESWContest_mobility_DugoNaerijiMarajo/B회신3_20261027/1_radar_test3/test3_radar.csv

wall_time | frame_number | num_points | nearest_range_m | num_tracks | presence | bad_frame | breath_rate | heart_rate | breath_dev | range_bin
1793096847.570 | 1 | 0 |  | 0 | 0 | 0
1793096847.625 | 2 | 2 | 0.253 | 0 | 0 | 0
1793096847.680 | 3 | 1 | 0.253 | 0 | 0 | 0
1793096847.735 | 4 | 0 |  | 0 | 0 | 0
1793096847.790 | 5 | 0 |  | 0 | 0 | 0
1793096847.845 | 6 | 1 | 0.253 | 0 | 0 | 0
1793096847.900 | 7 | 0 |  | 0 | 0 | 0
1793096847.955 | 8 | 0 |  | 0 | 0 | 0
1793096848.010 | 9 | 0 |  | 0 | 0 | 0
1793096848.065 | 10 | 0 |  | 0 | 0 | 0
1793096848.120 | 11 | 0 |  | 0 | 0 | 0
1793096848.175 | 12 | 1 | 0.253 | 0 | 0 | 0
1793096848.230 | 13 | 0 |  | 0 | 0 | 0
1793096848.285 | 14 | 0 |  | 0 | 0 | 0
1793096848.340 | 15 | 0 |  | 0 | 0 | 0
1793096848.395 | 16 | 1 | 0.253 | 0 | 0 | 0
1793096848.450 | 17 | 1 | 0.253 | 0 | 0 | 0
1793096848.505 | 18 | 0 |  | 0 | 0 | 0
1793096848.560 | 19 | 0 |  | 0 | 0 | 0
1793096848.618 | 20 | 2 | 1.328 | 0 | 0 | 0
1793096848.670 | 21 | 0 |  | 0 | 0 | 0
1793096848.725 | 22 | 0 |  | 0 | 0 | 0
1793096848.780 | 23 | 1 | 0.253 | 0 | 0 | 0
1793096848.835 | 24 | 0 |  | 0 | 0 | 0
1793096848.890 | 25 | 0 |  | 0 | 0 | 0
1793096848.945 | 26 | 0 |  | 0 | 0 | 0
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
