SafeGuard-EWHA/2026ESWContest_mobility_DugoNaerijiMarajo/B회신3_20261027/3_final_files/tools/plan_radar_test3.csv

t_s | event | say
0 | countdown | 15초 뒤 레이더 시험을 시작합니다. 레이더 대각선 뒤 멀리 가 계세요.
15 | start_empty | 시작. 빈자리 3분입니다. 그대로 계세요.
135 | empty_1min_left | 빈자리 1분 남았습니다.
185 | sit_down | 의자로 가서 앉으세요.
195 | still_start | 가만히 계세요. 2분입니다.
315 | still_end | 일어나서 레이더 대각선 뒤로 나가세요.
330 | empty2_start | 빈자리 1분입니다. 그대로 계세요.
390 | sit_again | 다시 의자로 가서 앉으세요.
400 | still2_start | 가만히 계세요. 30초입니다.
430 | end | 레이더 시험 끝. 일어나도 됩니다.
