SafeGuard-EWHA/2026ESWContest_mobility_DugoNaerijiMarajo/prototype/measurements/raw/block_b_20261027/reply1/csv/testA_origcfg_3people_still_orig.csv

wall_time | frame_number | num_points | nearest_range_m | num_tracks | presence | bad_frame
1792771524.064 | 1 | 4 | 0.253 | 0 | 0 | 0
1792771524.120 | 2 | 6 | 0.253 | 0 | 0 | 0
1792771524.174 | 3 | 3 | 0.253 | 0 | 0 | 0
1792771524.229 | 4 | 2 | 3.983 | 0 | 0 | 0
1792771524.284 | 5 | 2 | 3.983 | 0 | 0 | 0
1792771524.339 | 6 | 4 | 0.253 | 0 | 0 | 0
1792771524.394 | 7 | 1 | 4.047 | 0 | 0 | 0
1792771524.449 | 8 | 1 | 7.018 | 0 | 0 | 0
1792771524.504 | 9 | 1 | 0.253 | 0 | 0 | 0
1792771524.559 | 10 | 2 | 3.983 | 0 | 0 | 0
1792771524.613 | 11 | 0 |  | 0 | 0 | 0
1792771524.669 | 12 | 3 | 4.047 | 0 | 0 | 0
1792771524.724 | 13 | 4 | 3.983 | 0 | 0 | 0
1792771524.779 | 14 | 4 | 0.253 | 0 | 0 | 0
1792771524.833 | 15 | 0 |  | 0 | 0 | 0
1792771524.889 | 16 | 1 | 0.253 | 0 | 0 | 0
1792771524.944 | 17 | 4 | 0.253 | 0 | 0 | 0
1792771524.999 | 18 | 1 | 0.253 | 0 | 0 | 0
1792771525.054 | 19 | 2 | 0.253 | 0 | 0 | 0
1792771525.114 | 20 | 8 | 4.173 | 0 | 0 | 0
1792771525.164 | 21 | 2 | 7.018 | 0 | 0 | 0
1792771525.219 | 22 | 2 | 3.983 | 0 | 0 | 0
1792771525.274 | 23 | 2 | 0.253 | 0 | 0 | 0
1792771525.328 | 24 | 0 |  | 0 | 0 | 0
1792771525.383 | 25 | 0 |  | 0 | 0 | 0
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
