SafeGuard-EWHA/2026ESWContest_mobility_DugoNaerijiMarajo/prototype/measurements/raw/block_b_20261027/reply1/csv/testB_sedancfg_1person_still_car.csv

wall_time | frame_number | num_points | nearest_range_m | num_tracks | presence | bad_frame
1792772399.124 | 1 | 7 | 0.253 | 0 | 0 | 0
1792772399.178 | 2 | 4 | 2.529 | 0 | 0 | 0
1792772399.233 | 3 | 6 | 2.466 | 0 | 0 | 0
1792772399.289 | 4 | 8 | 0.253 | 0 | 0 | 0
1792772399.343 | 5 | 6 | 2.529 | 0 | 0 | 0
1792772399.398 | 6 | 5 | 2.529 | 0 | 0 | 0
1792772399.452 | 7 | 0 |  | 0 | 0 | 0
1792772399.508 | 8 | 4 | 2.529 | 0 | 0 | 0
1792772399.564 | 9 | 8 | 0.253 | 0 | 0 | 0
1792772399.620 | 10 | 8 | 0.253 | 0 | 0 | 0
1792772399.674 | 11 | 7 | 2.466 | 0 | 0 | 0
1792772399.728 | 12 | 6 | 0.253 | 0 | 0 | 0
1792772399.784 | 13 | 8 | 0.253 | 0 | 0 | 0
1792772399.838 | 14 | 2 | 2.592 | 0 | 0 | 0
1792772399.893 | 15 | 2 | 0.253 | 0 | 0 | 0
1792772399.948 | 16 | 5 | 0.253 | 0 | 0 | 0
1792772400.003 | 17 | 6 | 2.529 | 0 | 0 | 0
1792772400.059 | 18 | 8 | 0.253 | 0 | 0 | 0
1792772400.113 | 19 | 6 | 0.253 | 0 | 0 | 0
1792772400.174 | 20 | 9 | 1.897 | 0 | 0 | 0
1792772400.224 | 21 | 7 | 0.253 | 0 | 0 | 0
1792772400.278 | 22 | 4 | 2.592 | 0 | 0 | 0
1792772400.333 | 23 | 3 | 3.920 | 0 | 0 | 0
1792772400.389 | 24 | 8 | 0.253 | 0 | 0 | 0
1792772400.443 | 25 | 6 | 2.466 | 0 | 0 | 0
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
