SafeGuard-EWHA/2026ESWContest_mobility_DugoNaerijiMarajo/B회신2_20261027/3_test3/test3_cam_snaps/motion_20261027_193430.jpg

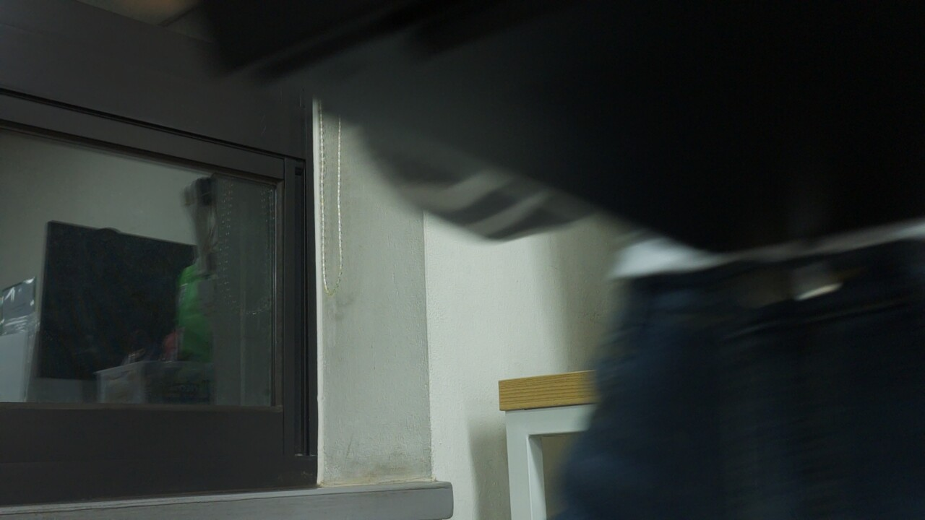
B회신2_20261027/3_test3/test3_cam_snaps/motion_20261027_193430.jpg
