SafeGuard-EWHA/2026ESWContest_mobility_DugoNaerijiMarajo/B회신3_20261027/1_radar_test3/test3_cam_snaps/motion_20261027_193100.jpg

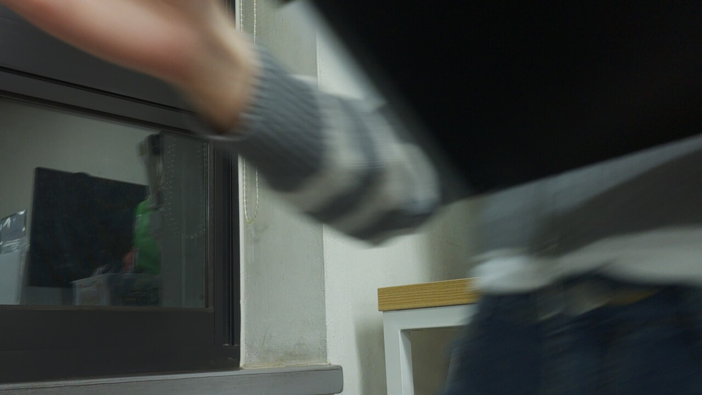
B회신3_20261027/1_radar_test3/test3_cam_snaps/motion_20261027_193100.jpg
