SafeGuard-EWHA/2026ESWContest_mobility_DugoNaerijiMarajo/prototype/measurements/figures/camera_light_timeline.png

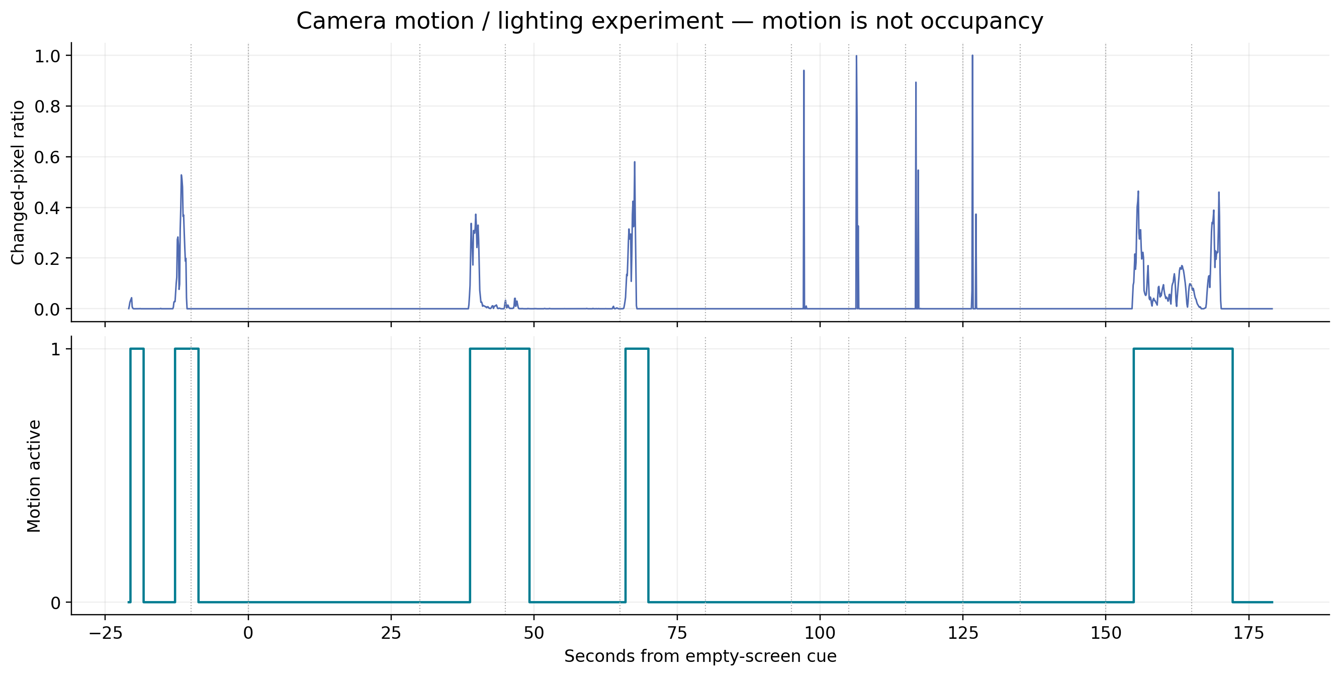
prototype/measurements/figures/camera_light_timeline.png
