SafeGuard-EWHA/2026ESWContest_mobility_DugoNaerijiMarajo/prototype/measurements/figures/radar_test3_timeline.png

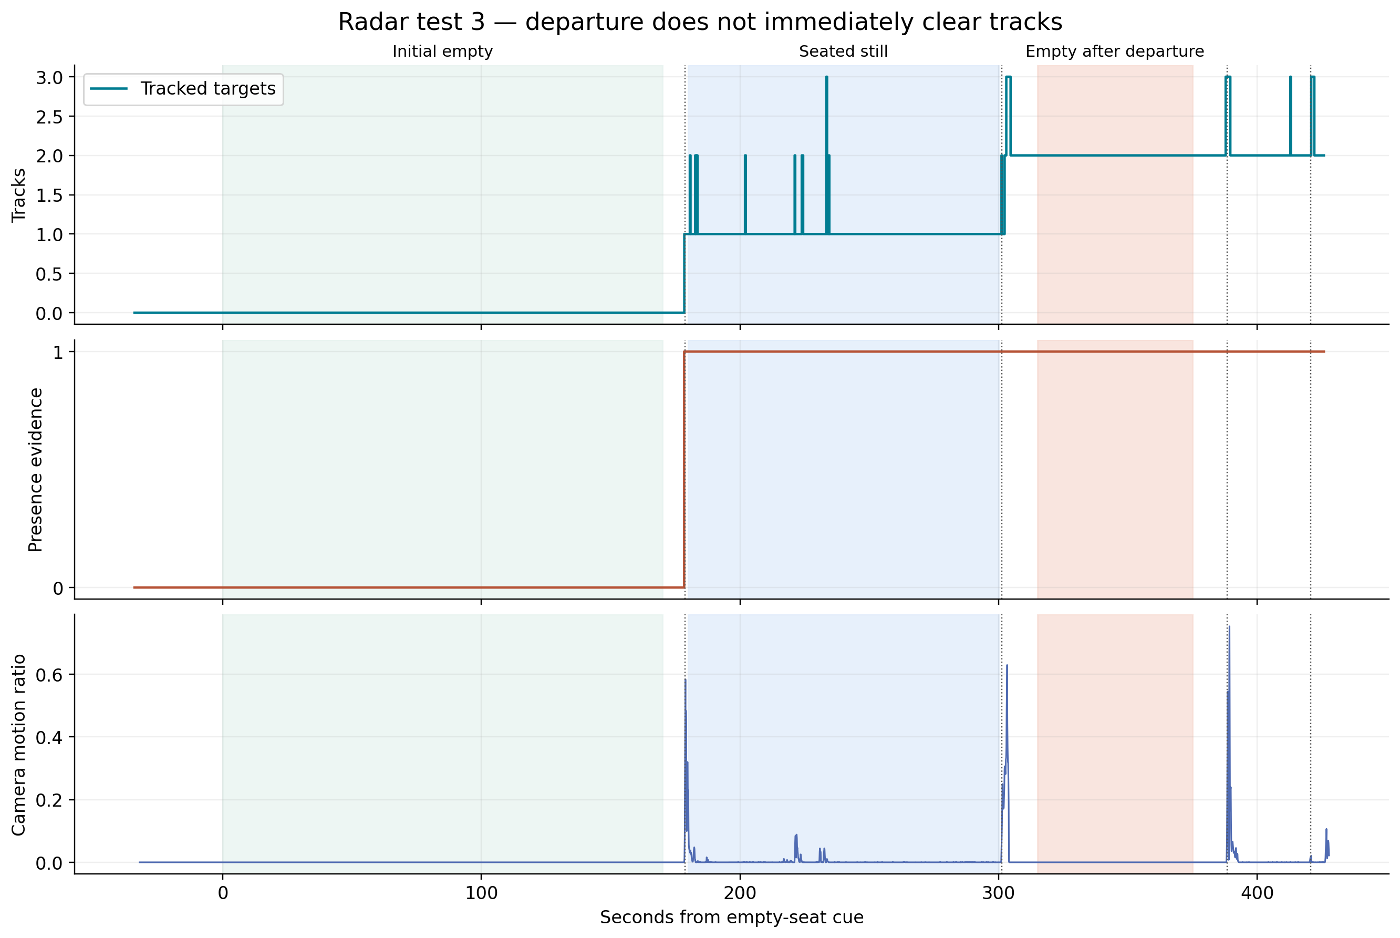
prototype/measurements/figures/radar_test3_timeline.png
