SafeGuard-EWHA/2026ESWContest_mobility_DugoNaerijiMarajo/prototype/measurements/figures/uwb_sessions.png

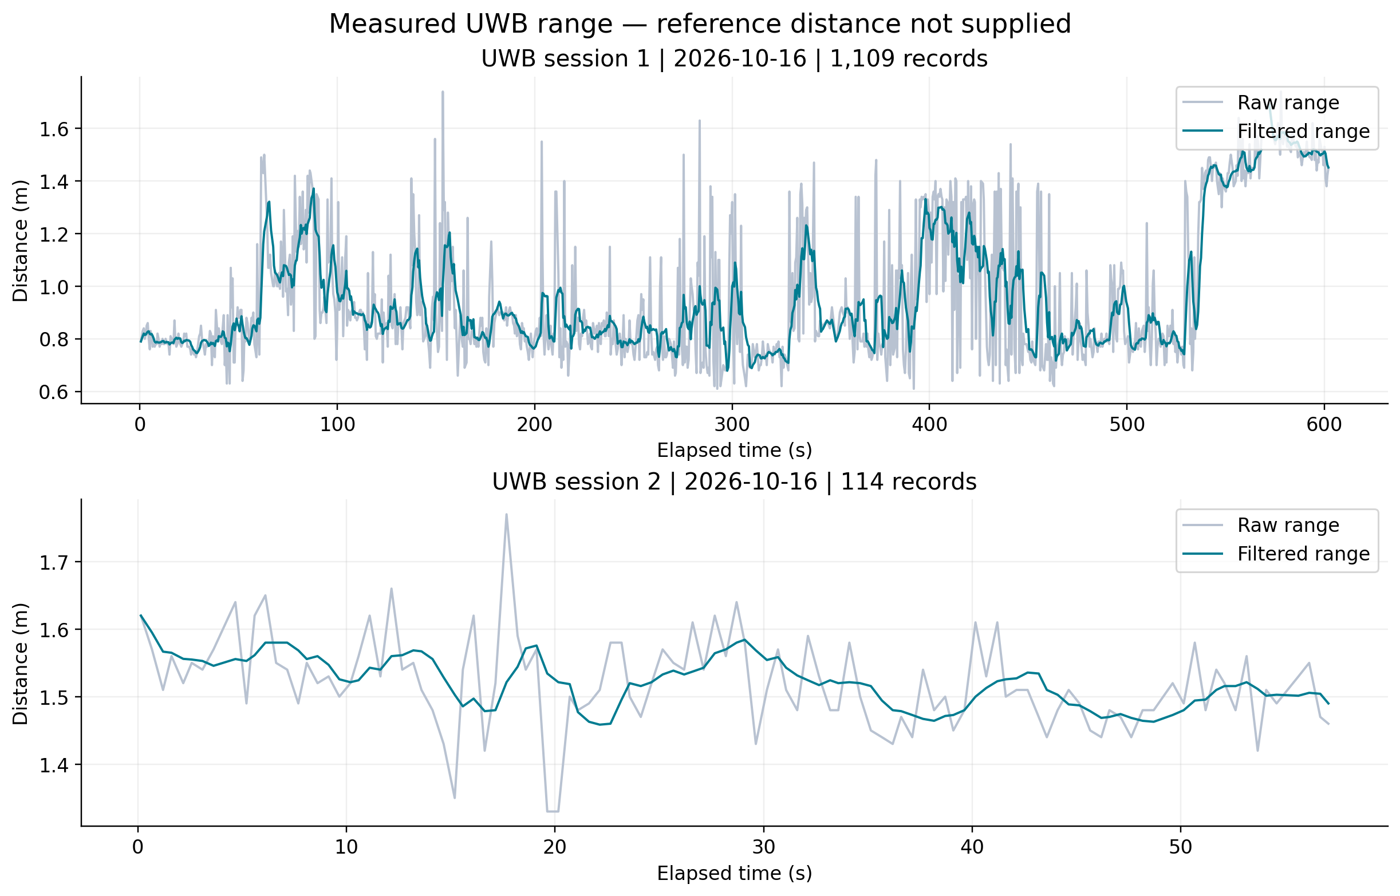
prototype/measurements/figures/uwb_sessions.png
