SafeGuard-EWHA/2026ESWContest_mobility_DugoNaerijiMarajo/prototype/measurements/raw/block_b_20261027/reply3/1_radar_test3/test3_cam_snaps/motion_20261027_193143.jpg

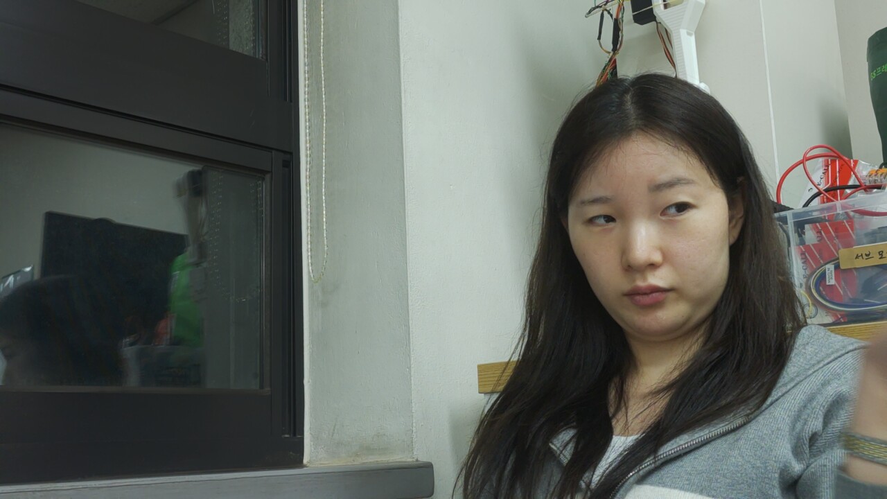
prototype/measurements/raw/block_b_20261027/reply3/1_radar_test3/test3_cam_snaps/motion_20261027_193143.jpg
