SafeGuard-EWHA/2026ESWContest_mobility_DugoNaerijiMarajo/prototype/measurements/raw/block_b_20261027/reply3/2_camera/cam_light_snaps/motion_20261027_195932.jpg

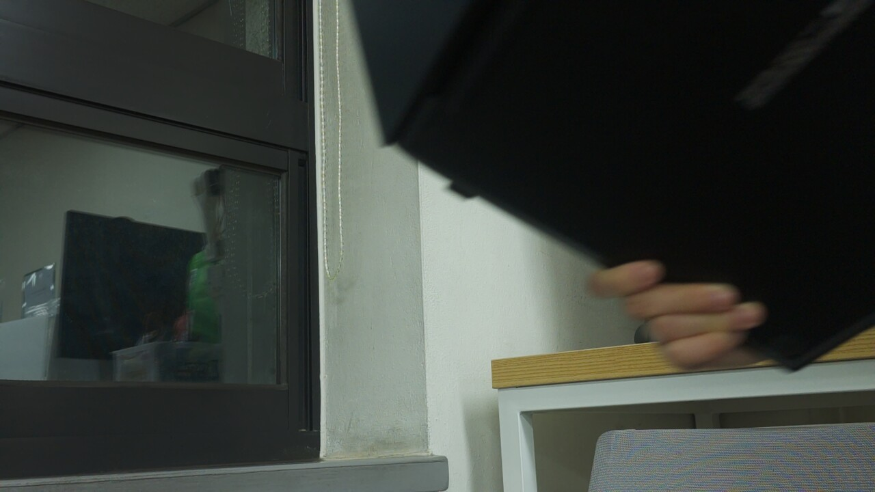
prototype/measurements/raw/block_b_20261027/reply3/2_camera/cam_light_snaps/motion_20261027_195932.jpg
