SafeGuard-EWHA/2026ESWContest_mobility_DugoNaerijiMarajo/prototype/measurements/raw/block_b_20261027/reply3/5_photos/1_side_tilt_c.jpg

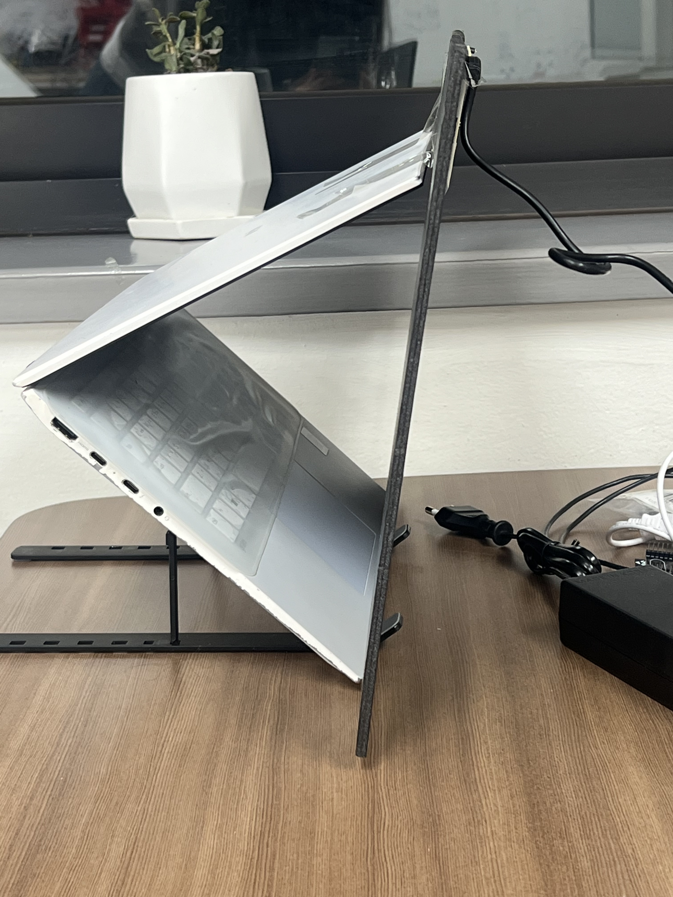
prototype/measurements/raw/block_b_20261027/reply3/5_photos/1_side_tilt_c.jpg
