SafeGuard-EWHA/2026ESWContest_mobility_DugoNaerijiMarajo/prototype/maintenance/README.md

# 최신 업데이트

[SafeGuard_Predictive_Control_20261028](SafeGuard_Predictive_Control_20261028/)이 최신 선제 보호 변경입니다. 이전 Thermal 패키지의 자동 제어 OFF 설명은 당시 단계의 기록이며 현재 상태는 [STATUS](../docs/STATUS.md)를 따릅니다. 이미 통합된 소스에 과거 설치기를 순서대로 실행하지 않습니다.

# 이전 설치·진단 패키지

이 폴더는 이전에 전달한 패키지를 보관합니다. 각 버전의 적용 전제, 해시 가드, 당시 검증 결과를 유지하기 위해 원본을 포함했습니다.

**현재 메인 소스는 상위 `SafeGuard_Main/`입니다. 이 폴더의 설치 스크립트를 일괄 실행하지 마세요.** 네트워크/인증서/펌웨어를 바꿀 수 있는 도구도 있으며 현재 설정과 맞지 않을 수 있습니다.

- `SafeGuard_Link_Fix_20261028`: 사용자 설치 확인된 통신 수정 패키지. 현재 소스에 이미 반영됨.
- `SafeGuard_Camera_Link_20261027`: 카메라 단독 점검과 이전 설치 도구.
- `SafeGuard_BlockB_Input_Update_20261027`: 레이더 입력 계약·참고 설정. 파손 장치에서 실행하지 않음.
- Navigation 패키지 및 IPv4 수정 파일: 위치 전달 서비스 설치 이력. 현재 Pi 서비스 파일·인증서는 이 묶음에서 직접 수집하지 않았으므로 신규 장치 재현 전 별도 확인 필요.

## 열 추정 추가 — 2026-10-28

`SafeGuard_Thermal_20261028/`은 전달한 설치 패키지의 원본입니다. 현재 `../SafeGuard_Main/`에는 이미 반영되어 있으므로 이 저장소 복제본에 설치기를 다시 실행하지 않습니다. 설치기는 지원 해시와 일치하는 이전 Pi 소스용이며 알 수 없는 버전은 거부합니다. 원본 패키지의 검증 기록은 당시 개발 환경 결과입니다. 최신 사용자 관찰은 `../docs/STATUS.md`를 참고하세요.
