SafeGuard-EWHA/2026ESWContest_mobility_DugoNaerijiMarajo/prototype/maintenance/SafeGuard_Navigation_Update/patch/scripts/dashboard.html

# SafeGuard 보호 상태 모니터

시험 구분 WAITING모드 WAITING연결 대기

WAITING · 제어기의 상태를 기다리고 있습니다.

## 현재 판단

경과 WAITING

WAITING

상태를 기다리고 있습니다.

### 보호자

WAITING

### 탑승자

WAITING

이탈 판단 기준 WAITING

## 운영 제어

비상정지 WAITING

버튼은 제어기에 요청을 전달합니다. 실제 전환은 현재 입력과 복귀 조건을 확인한 뒤 이루어집니다.

복귀조건 충족 후 보호 해제 비상정지 복귀 후 재무장

상태 수신 후 요청할 수 있습니다.

## 거리와 탑승 증거

### UWB · 보호자 거리

출처 WAITING

—m

품질 WAITING

마지막 거리 수신 후

WAITING

수신 중단은 보호자 이탈을 뜻하지 않습니다. 준비 상태는 거리 정확도의 보증이 아닙니다.

### PIR · 움직임 증거

출처 WAITING

WAITING

입력 상태 WAITING

### 카메라 · 영상 움직임

출처 WAITING

WAITING

입력 상태 WAITING

처리 상태 WAITING

### mmWave · 존재 증거

출처 WAITING

WAITING

증거 종류 WAITING

입력 상태 WAITING

처리 상태 WAITING

존재 감지용 입력입니다. 이 화면은 호흡이나 생체 상태를 측정·판정하지 않습니다.

## 온도와 예측

예측 WAITING

### 차내 온도 입력

—°C

출처 WAITING

유효성 WAITING

### 외기 온도 입력

—°C

출처 WAITING

유효성 WAITING

별도 센서 실측 온도 WAITING

외기 API 출처 정보 WAITING

차량 내비게이션 대용 iPhone 위치 대기

Weather data: Open-Meteo (https://open-meteo.com/) · CC BY 4.0 (https://open-meteo.com/en/licence)

### 35°C 도달 예상 시간 · 모델 계산

WAITING

곡선은 모델 예측값입니다. 실제 온도와 구분하며, 입력이나 예측이 유효하지 않으면 표시하지 않습니다.

## 출력 요청과 확인

출력 허용 WAITING

### 팬 요청

WAITING

### 부저 요청

WAITING

명령 확인 상태

WAITING

확인 출처

출처 WAITING

명령 ID WAITING

요청과 확인 응답을 표시합니다. 확인 응답만으로 실제 팬 회전이나 부저 소리를 확인한 것은 아닙니다.

## 이상 상태와 화면 기록

- 이상 상태 WAITING

아래 기록은 이 화면이 열린 동안의 상태 변화입니다.

실행 ID WAITING

마지막 수신 WAITING

SafeGuard · 로컬 상태 모니터
