SafeGuard-EWHA/2026ESWContest_mobility_DugoNaerijiMarajo/prototype/maintenance/SafeGuard_Navigation_Update/patch/scripts/navigation_phone.html

SAFEGUARD / VEHICLE NAVIGATION

# 차량 위치 전달

이 아이폰을 차량 내비게이션 대용으로 Pi와 함께 두세요. 이동하면 실제 위치를 자동으로 전달합니다.

## 1. Pi와 연결

Pi의 검은 창에 표시된 8자리 연결 코드를 입력하세요. 새 수신기를 실행할 때마다 코드가 바뀝니다.

연결하기

연결 대기

## 2. 위치 자동 전달

Pi 연결 후 시작하세요.

위치 접근 요청이 나오면 허용하고, 정확한 위치를 켜주세요.

시연 시작정지

시연 중 이 Safari 화면을 켜두세요. 화면 잠금·다른 앱 전환 시 전달을 중단합니다. 돌아오면 다시 시작하세요.

## 실제 수신 상태

위도

—

경도

—

아이폰이 보고한 정확도

—

위치 측정 후 경과

—

Pi가 마지막으로 받은 시각

—

Pi 수신 확인 횟수

0

아직 유효한 위치를 전달하지 않았습니다.

출처: 이 아이폰의 위치 서비스. GPS·Wi-Fi·이동통신 등 운영체제가 제공하는 위치이며 원시 GPS 측위 성공을 보증하는 표시는 아닙니다. 외기 온도는 Pi가 이 좌표로 Open-Meteo API에 조회합니다. 기상 격자가 같으면 이동해도 온도는 같을 수 있습니다.
