SafeGuard-EWHA/2026ESWContest_mobility_DugoNaerijiMarajo/sample_data/sample_hardware_log_normal_risk.csv

time_s | state | pir_val | temp_c | humidity | relay_fan | relay_led | relay_buzzer | relay_motor | cpu_temp_c | cpu_percent
0.0 |  | 0 | 30.015235853987722 | 52.69920789262579 | 0 | 0 | 0 | 0 | 45.63403141381217 | 23.647965388637264
1.0 |  | 0 | 30.006192575074987 | 56.29574202054728 | 0 | 0 | 0 | 0 | 46.26431665628238 | 23.275364081048913
2.0 |  | 0 | 30.153623930288962 | 54.50721216531566 | 0 | 0 | 0 | 0 | 46.17195345400894 | 25.957751077040925
3.0 |  | 0 | 30.220758374583987 | 54.90801348125673 | 0 | 0 | 0 | 0 | 42.58541662504943 | 11.928715860147761
4.0 |  | 0 | 30.133527687545282 | 53.420652233944075 | 0 | 0 | 0 | 0 | 46.29898761345029 | 25.779383410640005
5.0 |  | 0 | 30.223041674985993 | 54.498315741466186 | 0 | 0 | 0 | 0 | 46.42734460470551 | 25.205106367452533
6.0 |  | 0 | 30.35133711759429 | 56.95006689204844 | 0 | 0 | 0 | 0 | 46.14555974305759 | 24.705115020163664
7.0 |  | 0 | 30.38565200075946 | 55.87398286298156 | 0 | 0 | 0 | 0 | 46.84896896745295 | 28.176552214298525
8.0 |  | 0 | 30.45686902684609 | 57.598467408114914 | 0 | 0 | 0 | 0 | 45.73663253883529 | 23.755585109410564
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
