SafeGuard-EWHA/2026ESWContest_mobility_DugoNaerijiMarajo/docs/figures/paper/fig1_uwb_ranging.pdf

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

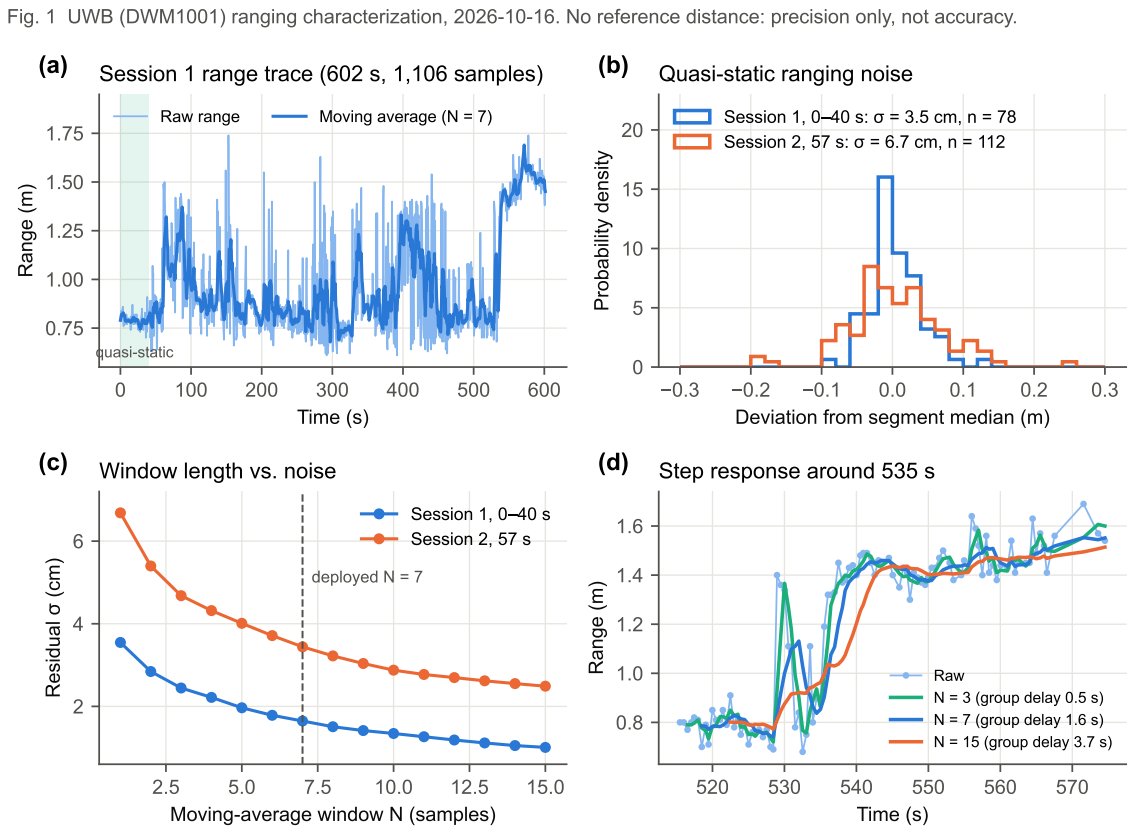
[picture p223: page 1]
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
