SafeGuard-EWHA/2026ESWContest_mobility_DugoNaerijiMarajo/docs/figures/paper/fig3_camera_feature.pdf

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

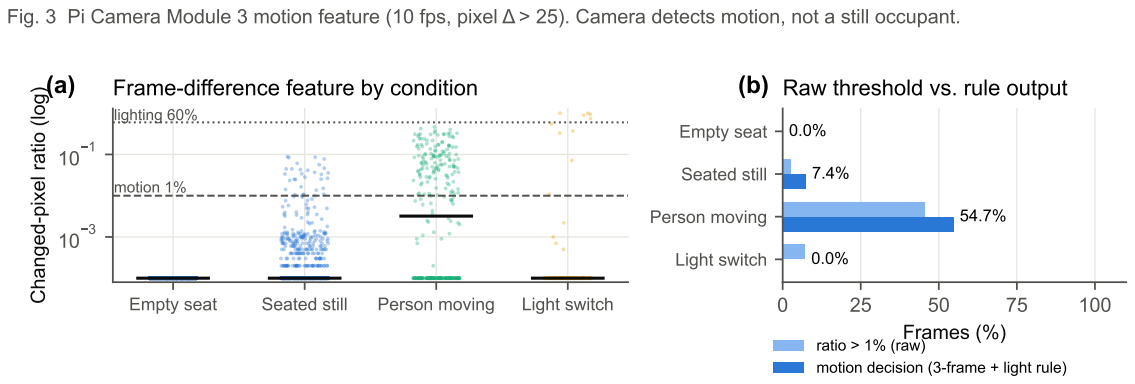
[picture p225: page 1]
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
