SafeGuard-EWHA/2026ESWContest_mobility_DugoNaerijiMarajo/docs/figures/paper/fig6_thermal_rule_map.pdf

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

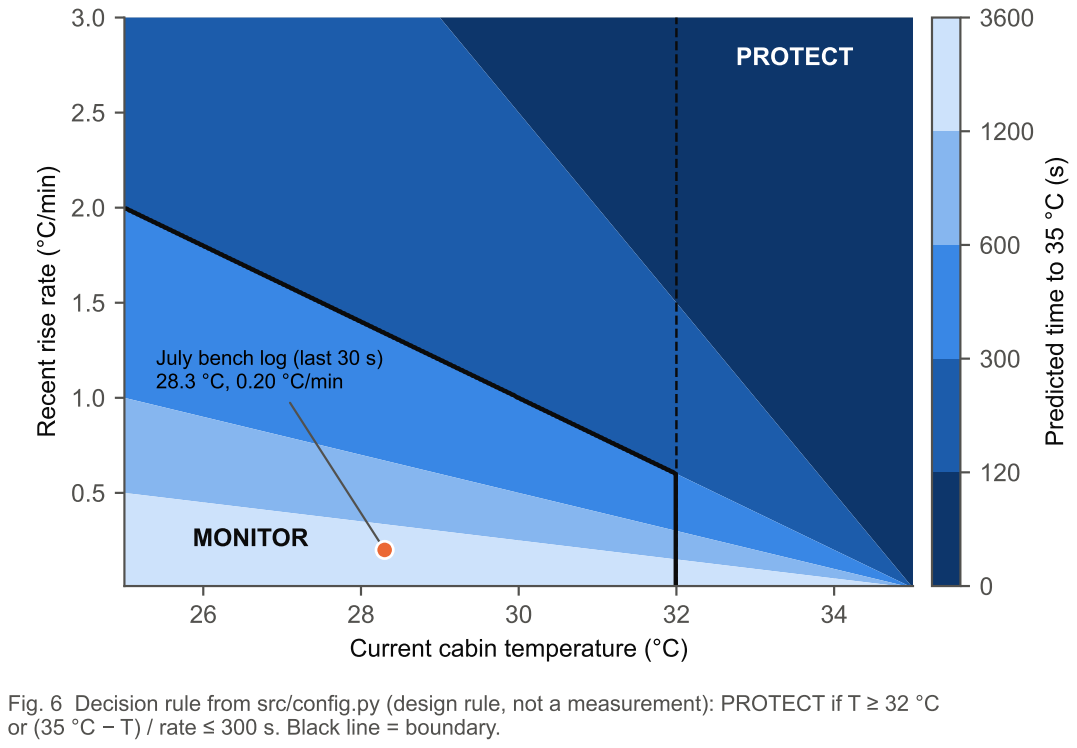
[picture p226: page 1]
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
