SafeGuard-EWHA/2026ESWContest_mobility_DugoNaerijiMarajo/(commit log)

2026-10-27 Final submission: SafeGuard source, measurements, figures, report and intro
    - prototype/: device control source (C++ state machine, thermal observer,
    Python sensor hub, dashboard, ESP32 firmware) and measurement originals
    - hardware/, src/, app/, tests/: radar receiver, camera motion, TwinLab simulator
    - docs/: final report (PDF/PPTX), project intro, 7 paper figures, radar videos
    - Photos resized to 2000 px with EXIF removed; internal zips, driver
    installer and draft papers left out
2026-10-28 README: intro/body/conclusion structure, power estimate, appendix cleanup
    Add summary, background, conclusion and implications. Drop Fig 7 (literature
    data, not ours). Recast Vital Signs as an attempt in an appendix. Fill the
    Streamlit section with the deployed preliminary app. Add a datasheet-based
    power estimate for the final hardware. Rewrite TwinLab limitations without
    paper references.
2026-10-28 Report: new homepage-style deck, drop literature Fig 7, regenerate PDF
    Page 17 now shows our temperature decision rule with the July DHT22 bench
    point instead of the McLaren 2005 literature fit. Page 16 lists the power
    estimate.
2026-10-28 Final report from team's real-car deck with fact fixes; longer conclusion
    Report: software full stop instead of NC e-stop, servo GPIO13, no literature
    figure, softened claims, radar-unavailable demo noted, 20 body pages.
    README: conclusion with evidence level per result, implications, next tests.
2026-10-28 README: drop radar socket note from real-car photo caption
2026-10-31 feat: add ambient-aware thermal prediction and managed Pi web access
    Preserve the existing mmWave dashboard panel, CTest conventions, firmware,
    measurement artifacts, and presentation materials. Document connection-only
    Pi deployment, reported mmWave repair, and pending physical verification.
